lanfuli/Localization/elcano-master/Vision/IMG_0450.JPG

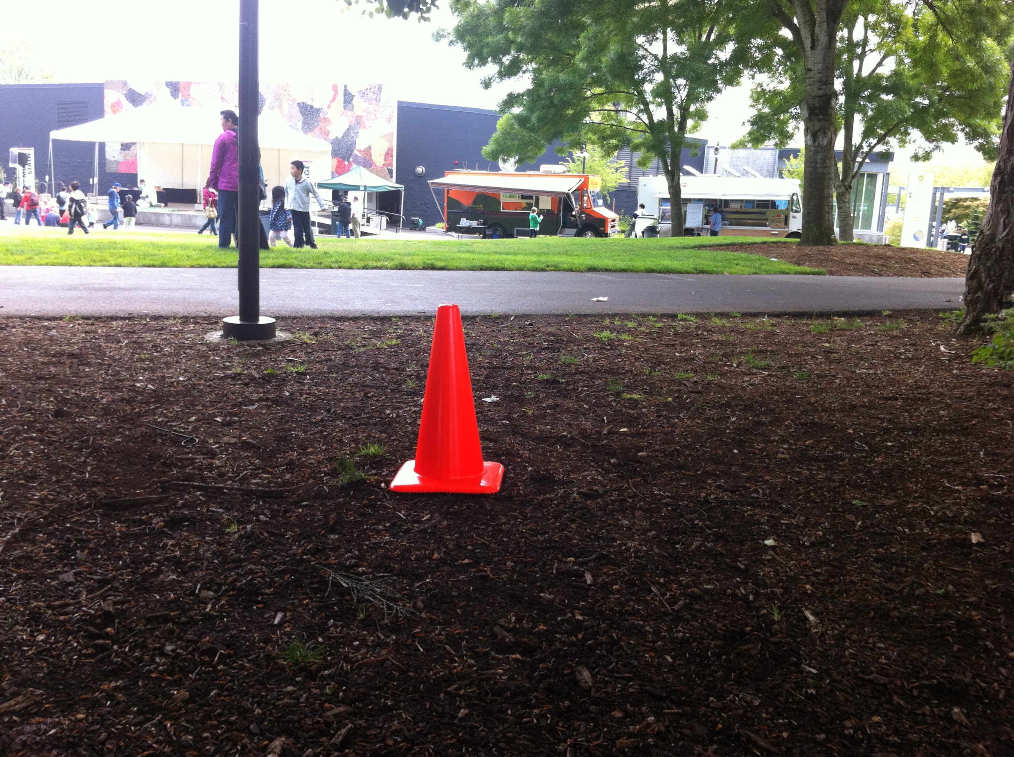
elcano-master/Vision/IMG_0450.JPG
