lanfuli/Localization/elcano-master/Vision/IMG_0453.JPG

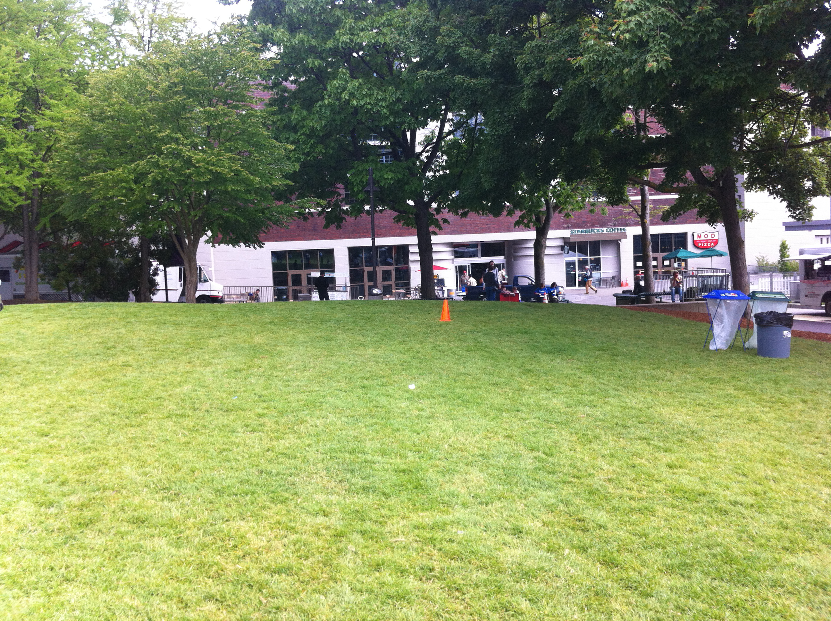
elcano-master/Vision/IMG_0453.JPG
