lanfuli/Localization/elcano-master/RNDF/Sample_RNDF.png

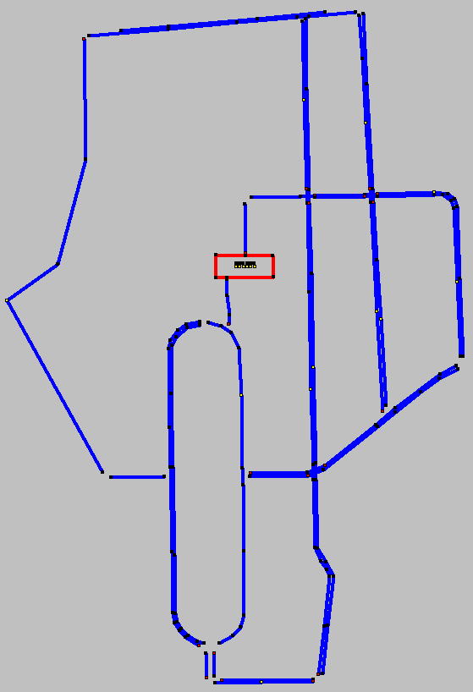
elcano-master/RNDF/Sample_RNDF.png
