lanfuli/Localization/elcano-master/Vision/backgrounds/IMG_0440.png

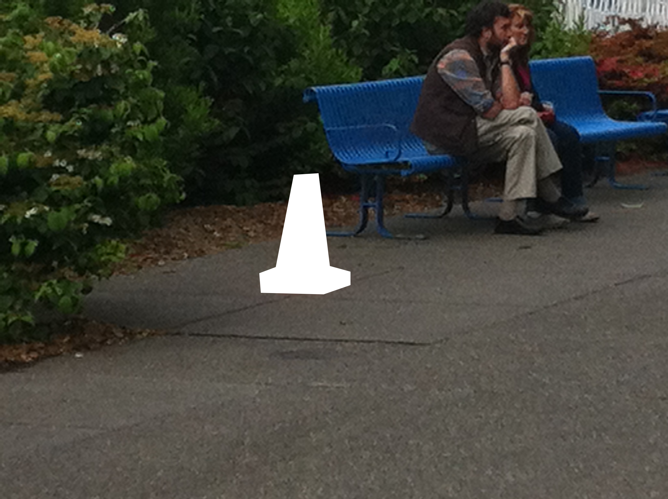
elcano-master/Vision/backgrounds/IMG_0440.png
