lanfuli/Localization/elcano-master/Vision/cones/orange_cones_cropped.png

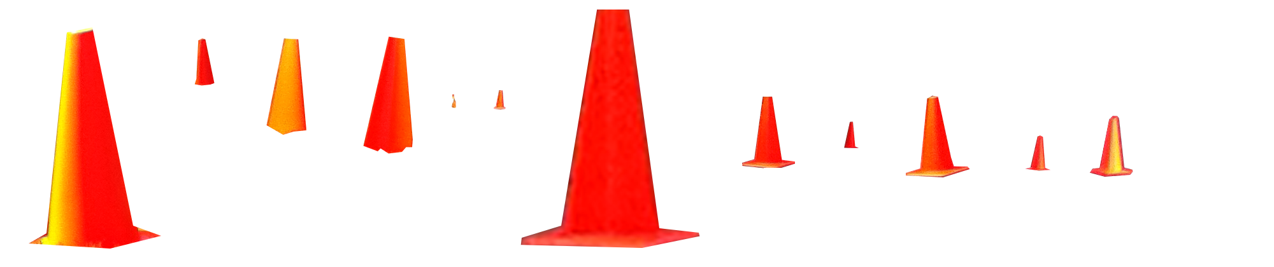
elcano-master/Vision/cones/orange_cones_cropped.png
