lanfuli/Localization/elcano-master/Vision/IMG_0434.JPG

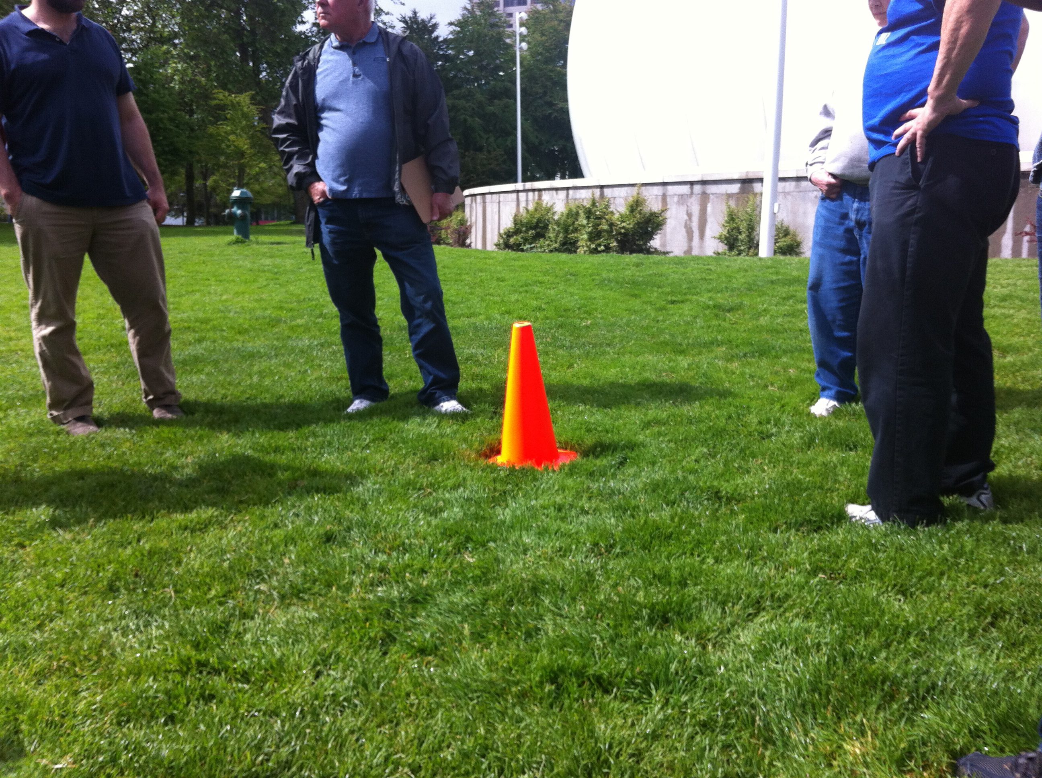
elcano-master/Vision/IMG_0434.JPG
