lanfuli/Localization/elcano-master/Vision/IMG_0435.JPG

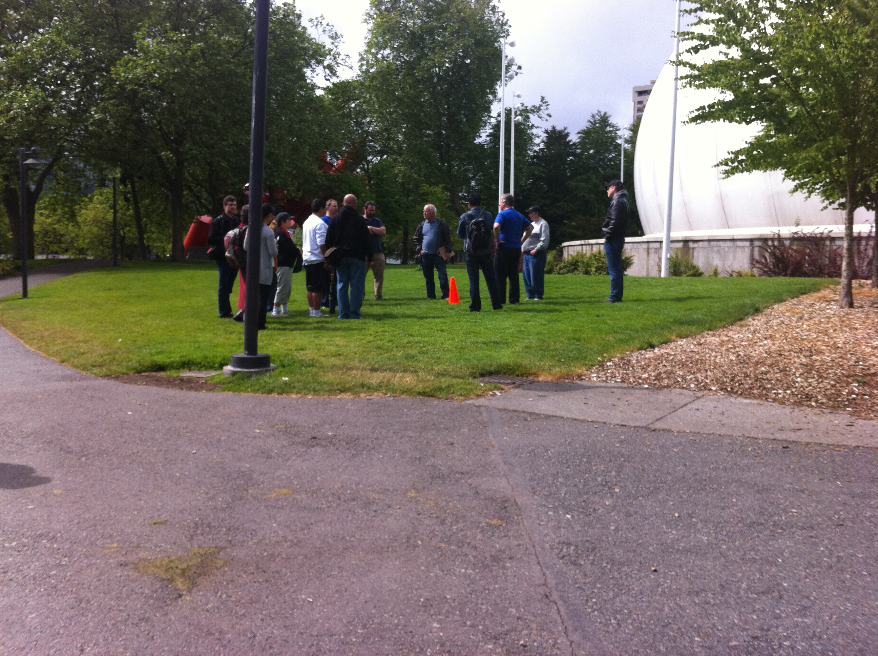
elcano-master/Vision/IMG_0435.JPG
