lanfuli/Localization/elcano-master/Vision/IMG_0436.JPG

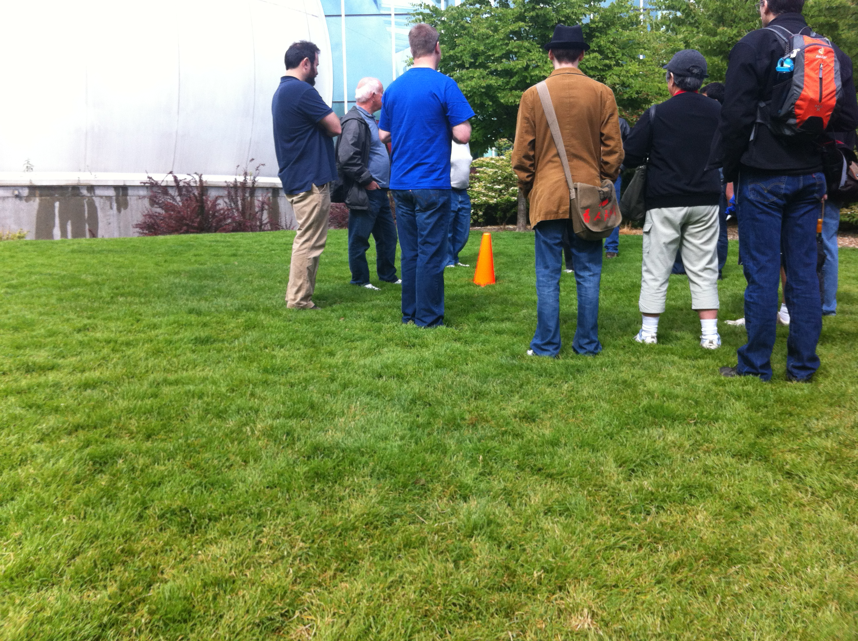
elcano-master/Vision/IMG_0436.JPG
