lanfuli/Localization/elcano-master/Vision/IMG_0437.JPG

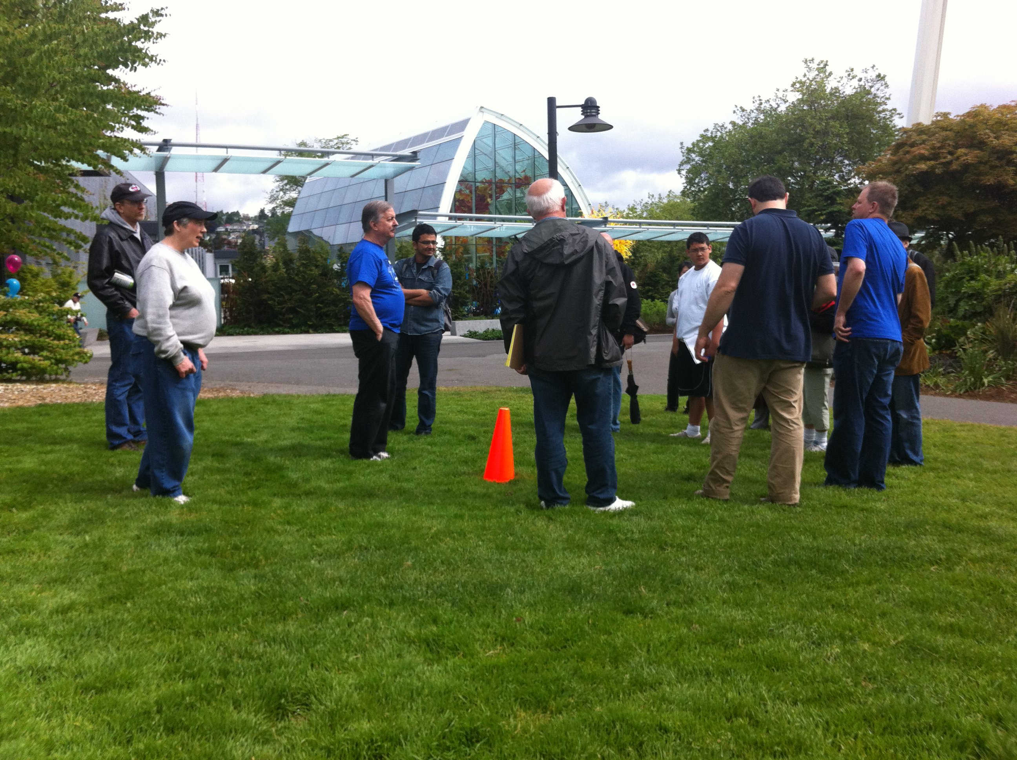
elcano-master/Vision/IMG_0437.JPG
