lanfuli/Localization/elcano-master/Vision/IMG_0438.JPG

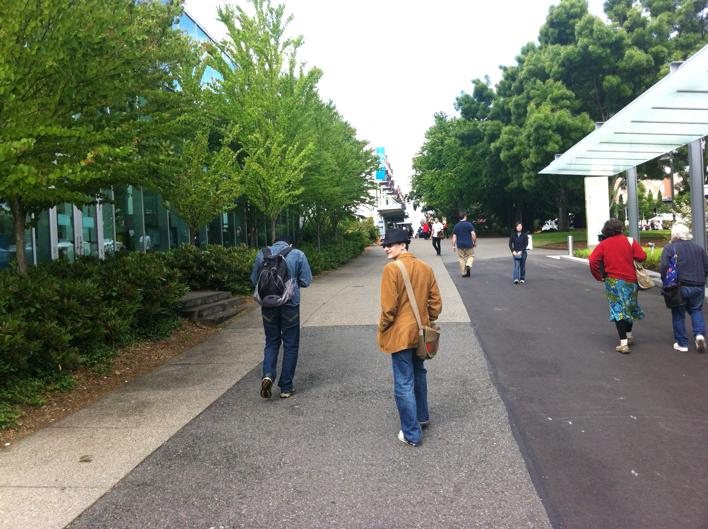
elcano-master/Vision/IMG_0438.JPG
