lanfuli/Localization/elcano-master/Vision/IMG_0439.JPG

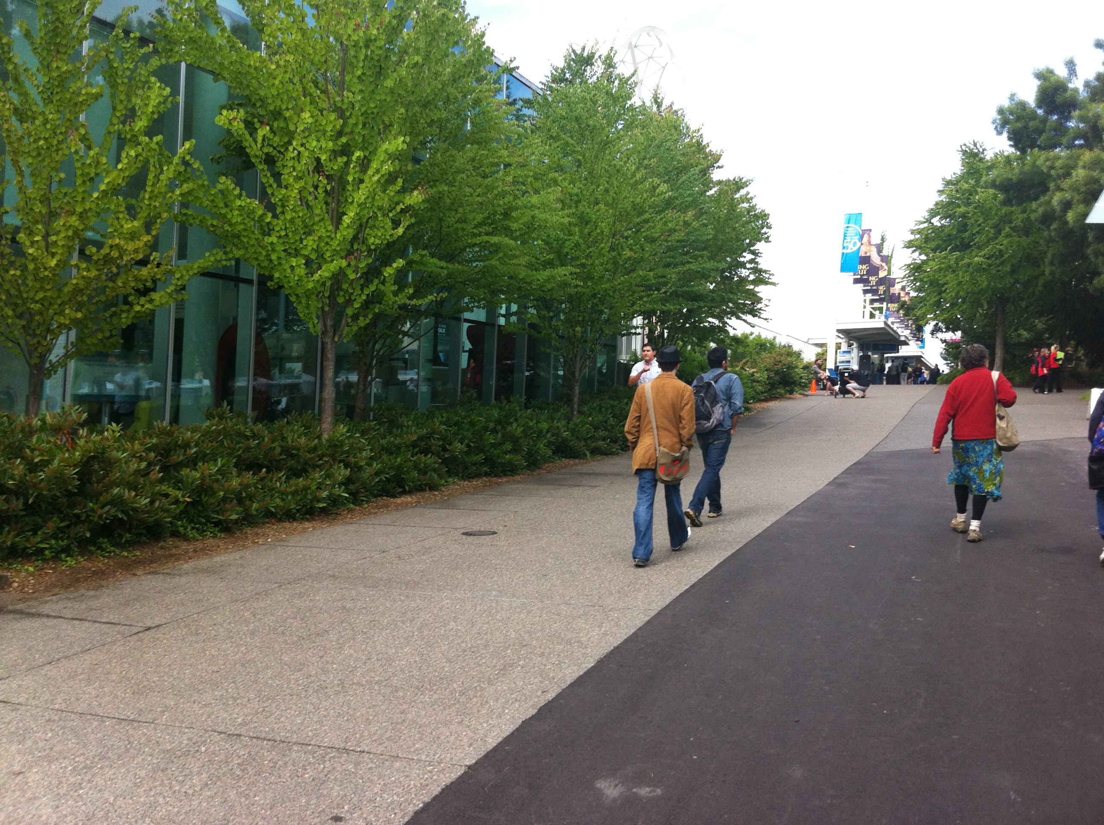
elcano-master/Vision/IMG_0439.JPG
