lanfuli/Localization/elcano-master/Vision/IMG_0441.JPG

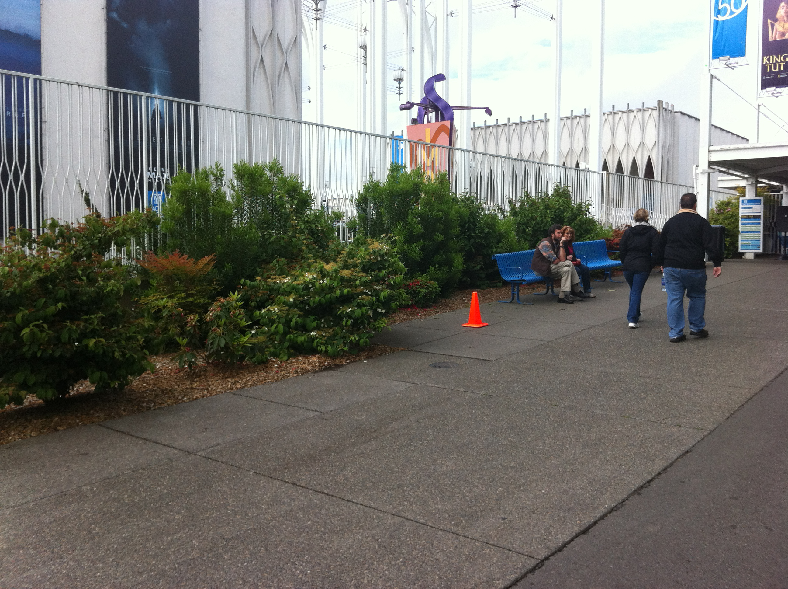
elcano-master/Vision/IMG_0441.JPG
