lanfuli/Localization/elcano-master/Vision/IMG_0442.JPG

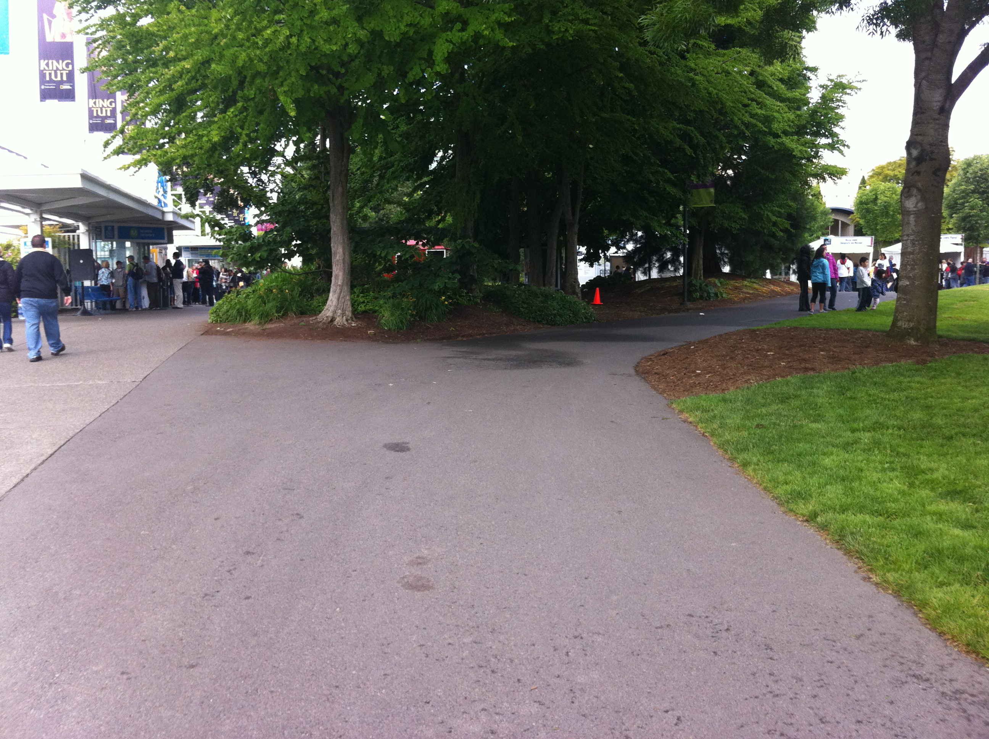
elcano-master/Vision/IMG_0442.JPG
