lanfuli/Localization/elcano-master/Vision/IMG_0443.JPG

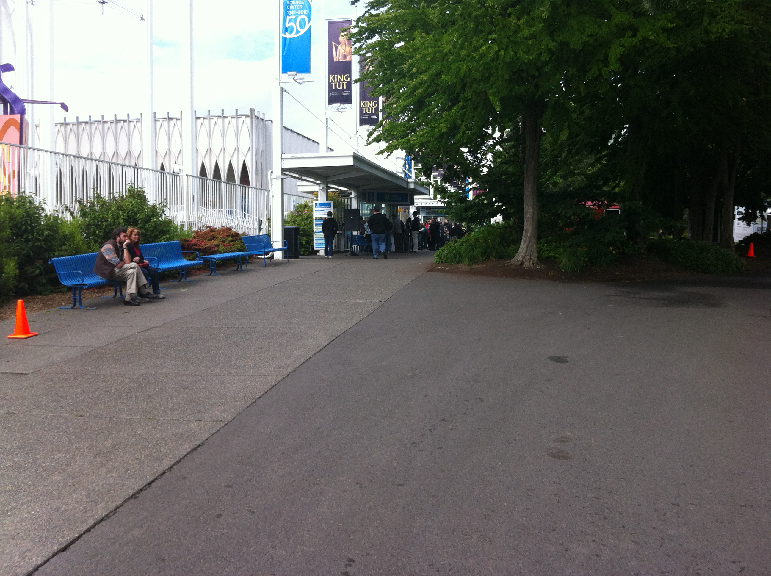
elcano-master/Vision/IMG_0443.JPG
