lanfuli/Localization/elcano-master/Vision/IMG_0444.JPG

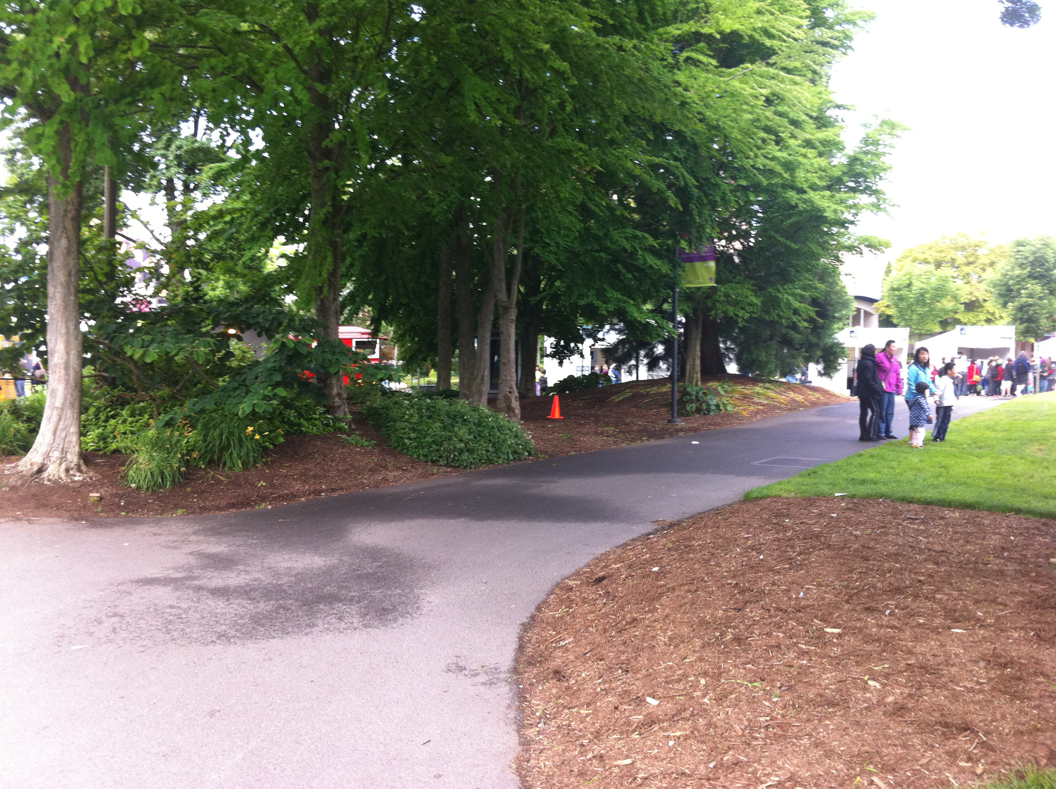
elcano-master/Vision/IMG_0444.JPG
