lanfuli/Localization/elcano-master/Vision/IMG_0445.JPG

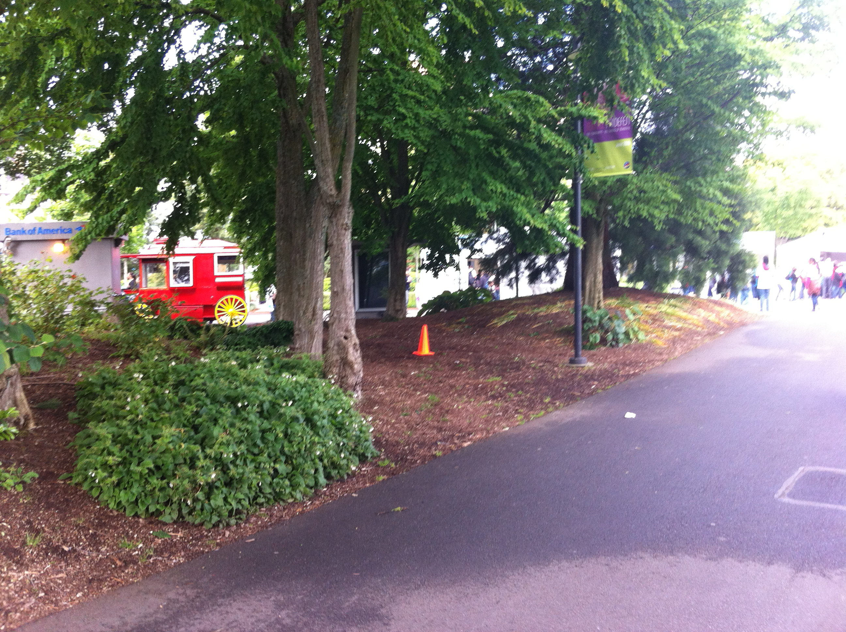
elcano-master/Vision/IMG_0445.JPG
