lanfuli/Localization/elcano-master/Vision/IMG_0446.JPG

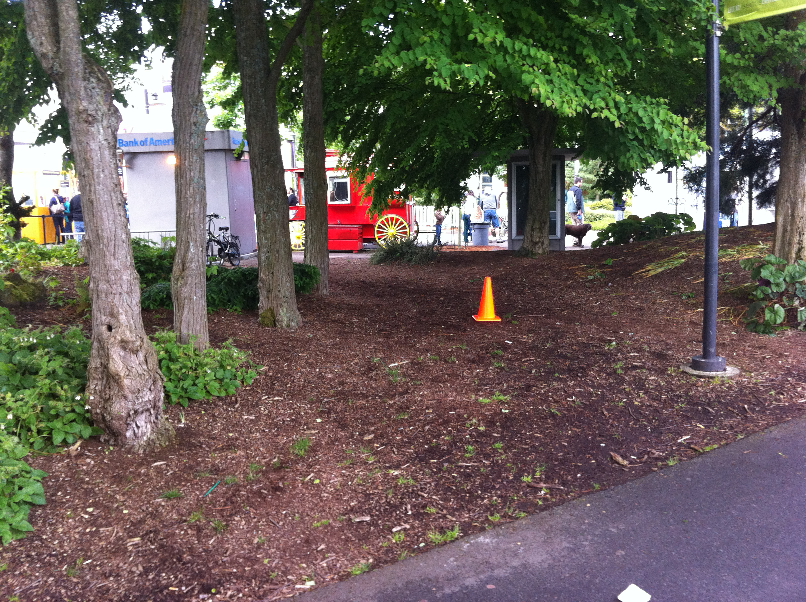
elcano-master/Vision/IMG_0446.JPG
