lanfuli/Localization/elcano-master/Vision/IMG_0447.JPG

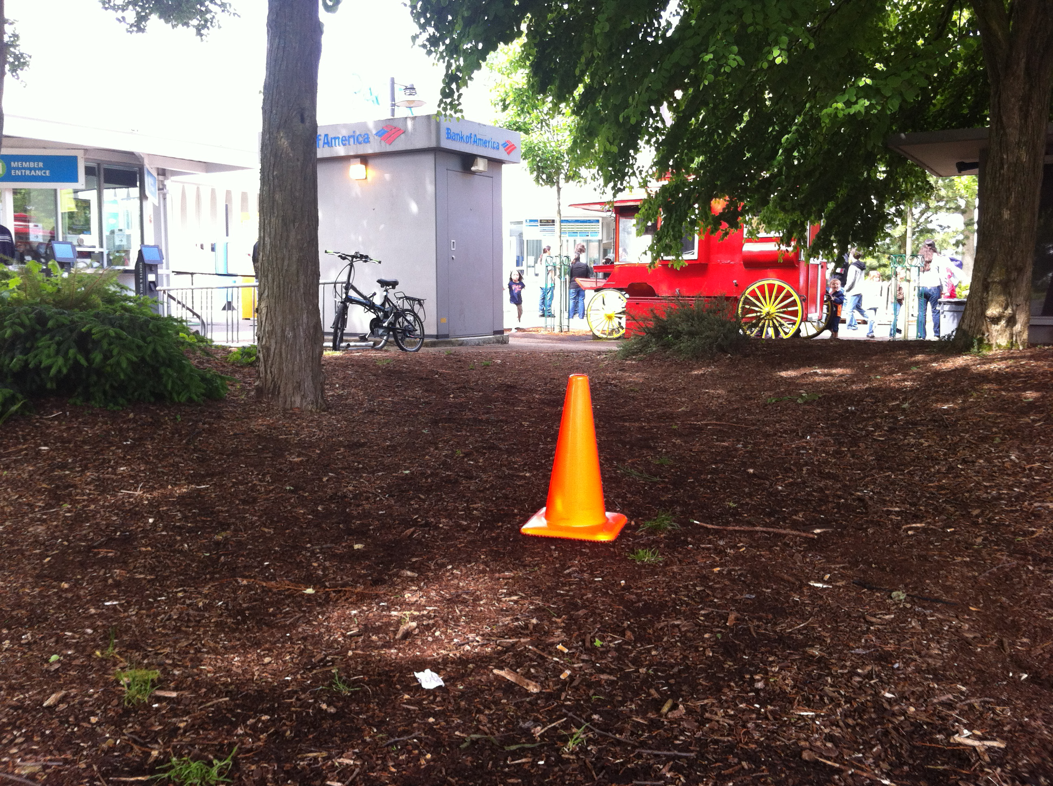
elcano-master/Vision/IMG_0447.JPG
