lanfuli/Localization/elcano-master/Vision/IMG_0448.JPG

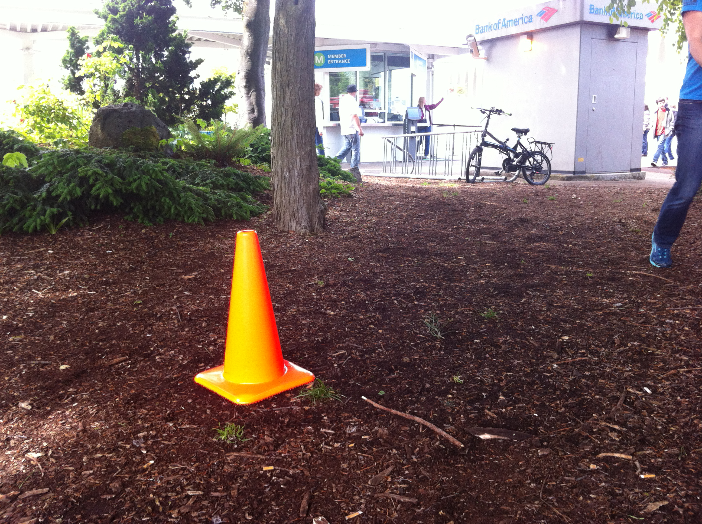
elcano-master/Vision/IMG_0448.JPG
