lanfuli/Localization/elcano-master/Vision/IMG_0449.JPG

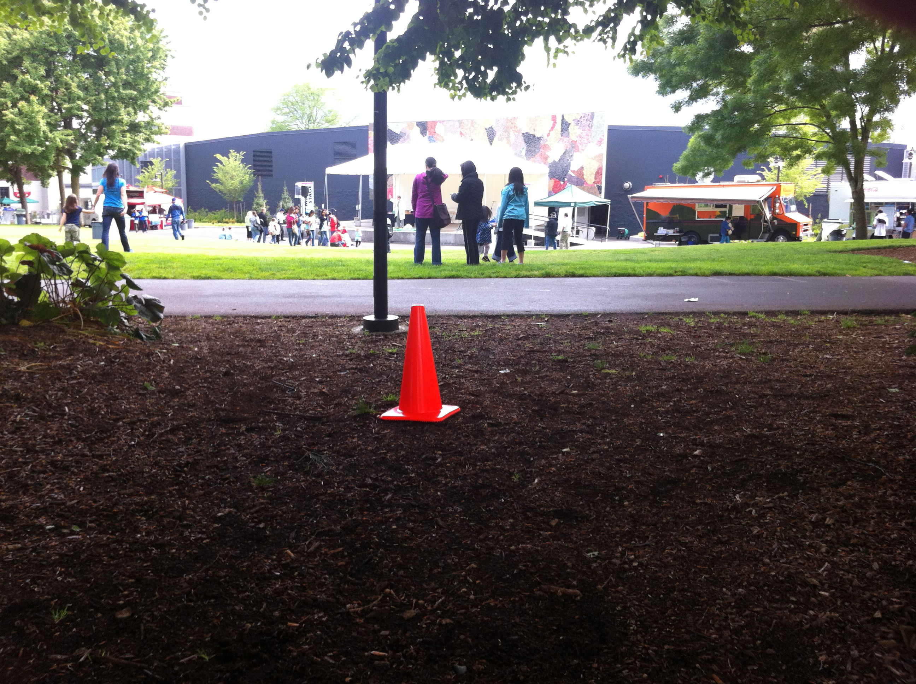
elcano-master/Vision/IMG_0449.JPG
