lanfuli/Localization/elcano-master/Vision/IMG_0451.JPG

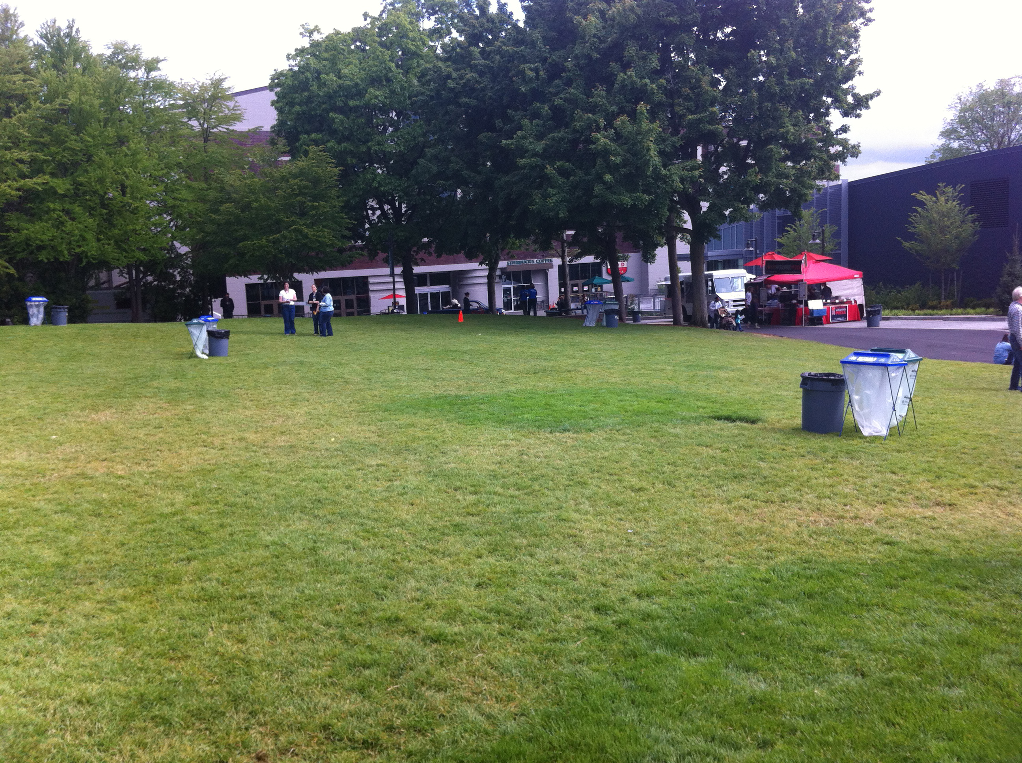
elcano-master/Vision/IMG_0451.JPG
