lanfuli/Localization/elcano-master/Vision/IMG_0452.JPG

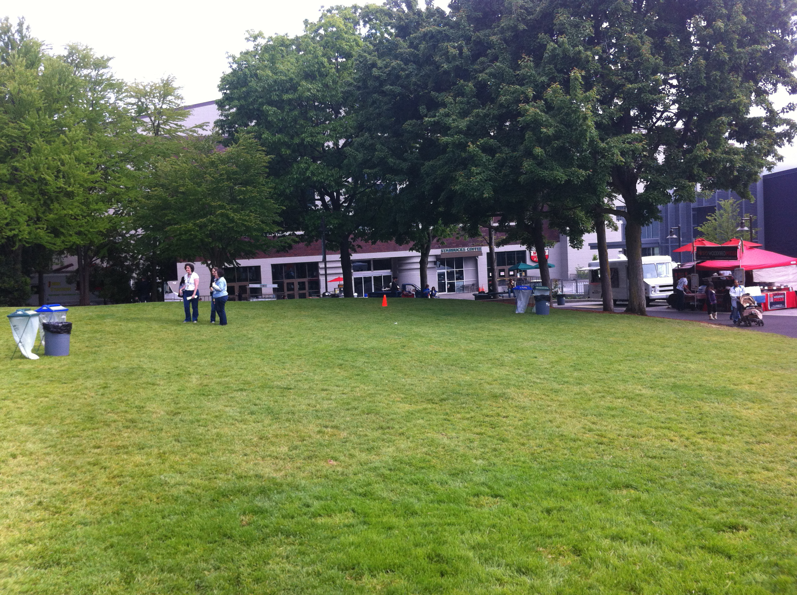
elcano-master/Vision/IMG_0452.JPG
