lanfuli/Localization/elcano-master/Vision/IMG_0454.JPG

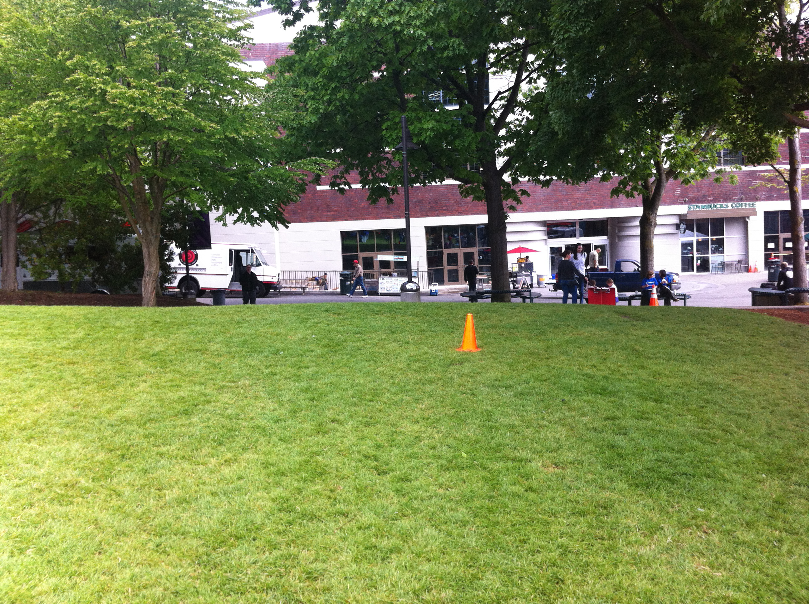
elcano-master/Vision/IMG_0454.JPG
