lanfuli/Localization/elcano-master/Vision/IMG_0455.JPG

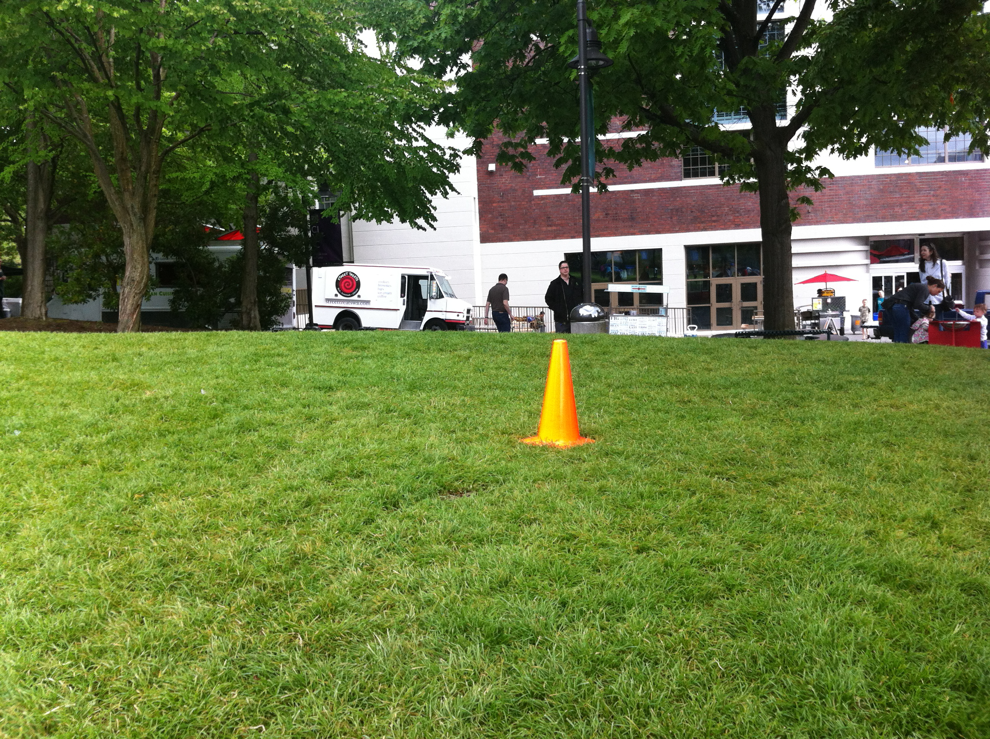
elcano-master/Vision/IMG_0455.JPG
