lanfuli/Localization/elcano-master/Vision/IMG_0456.JPG

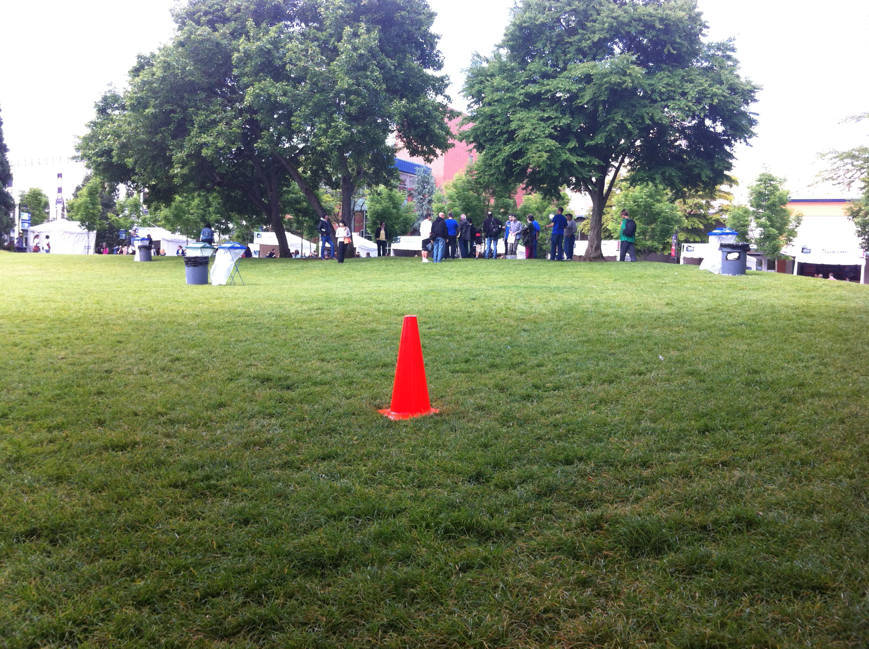
elcano-master/Vision/IMG_0456.JPG
