lanfuli/Localization/elcano-master/Vision/IMG_0457.JPG

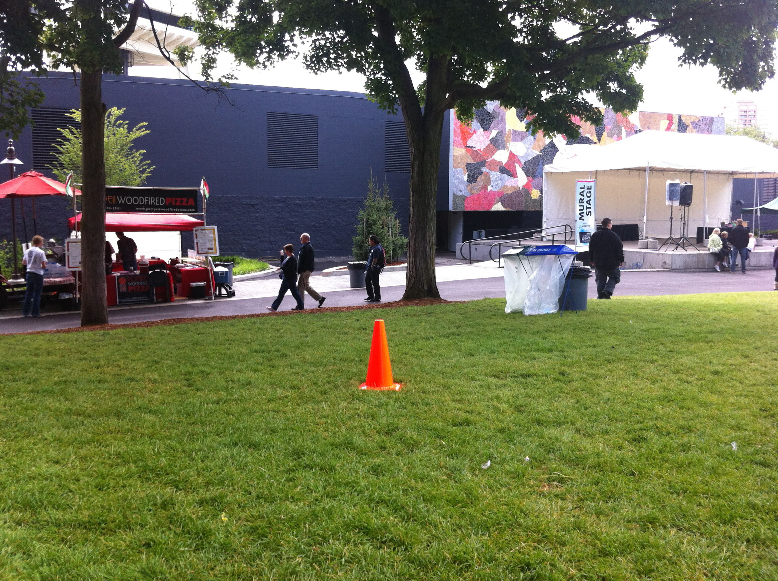
elcano-master/Vision/IMG_0457.JPG
