lanfuli/Localization/elcano-master/Vision/IMG_0465.JPG

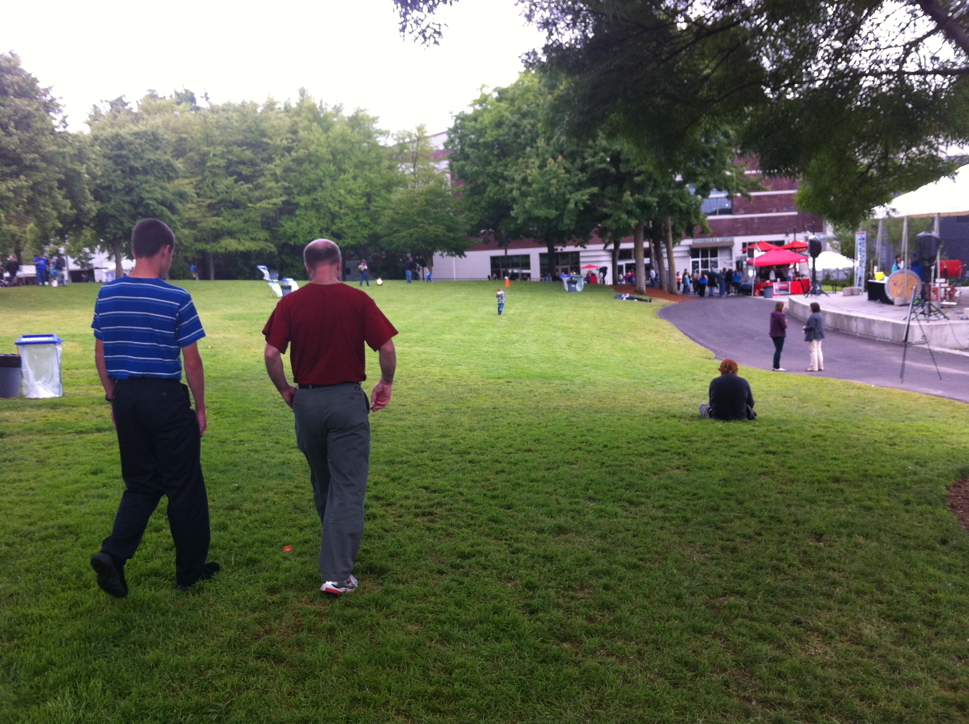
elcano-master/Vision/IMG_0465.JPG
