lanfuli/Localization/elcano-master/Vision/IMG_0466.JPG

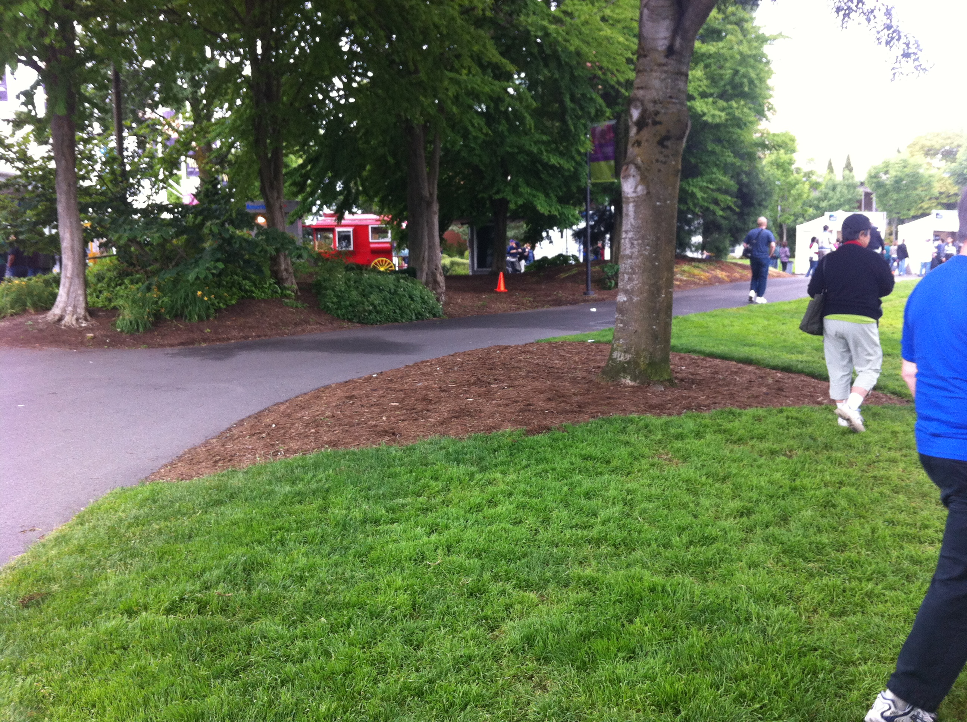
elcano-master/Vision/IMG_0466.JPG
