lanfuli/Localization/elcano-master/Vision/IMG_0467.JPG

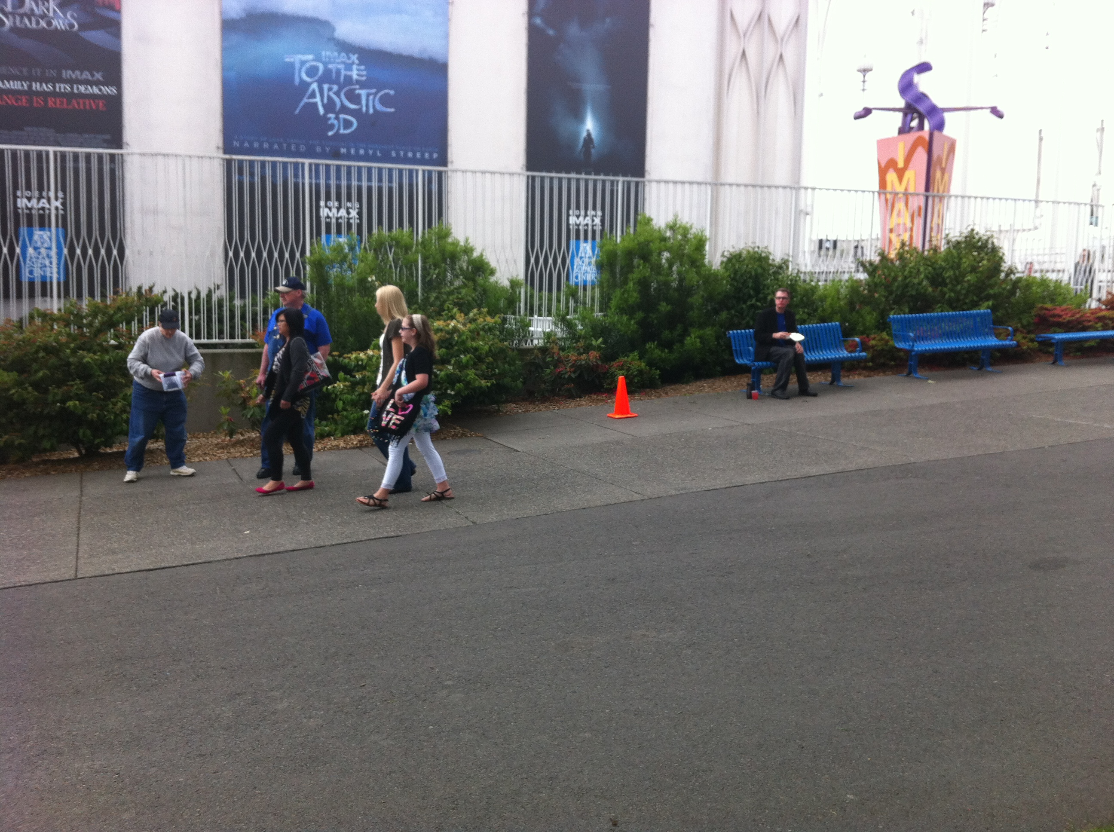
elcano-master/Vision/IMG_0467.JPG
