lanfuli/Localization/elcano-master/Vision/IMG_0468.JPG

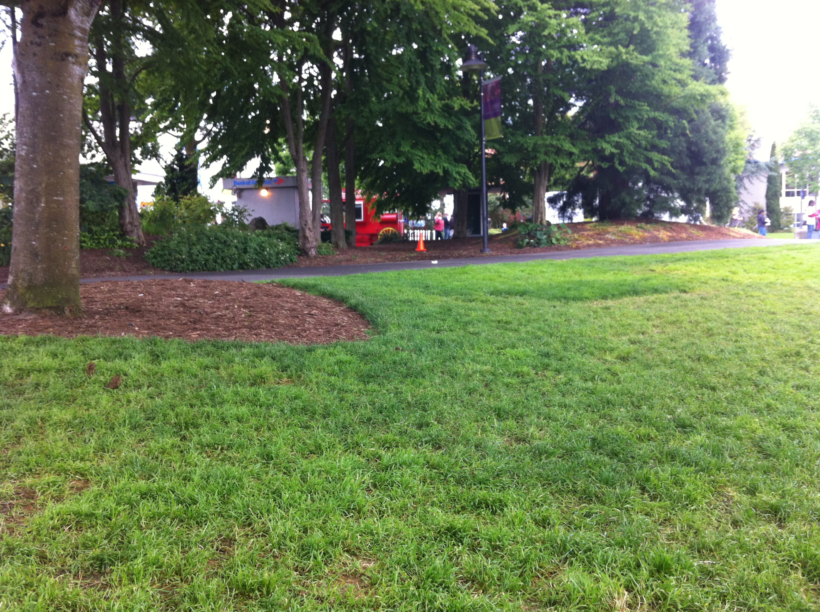
elcano-master/Vision/IMG_0468.JPG
