lanfuli/Localization/elcano-master/Vision/IMG_0469.JPG

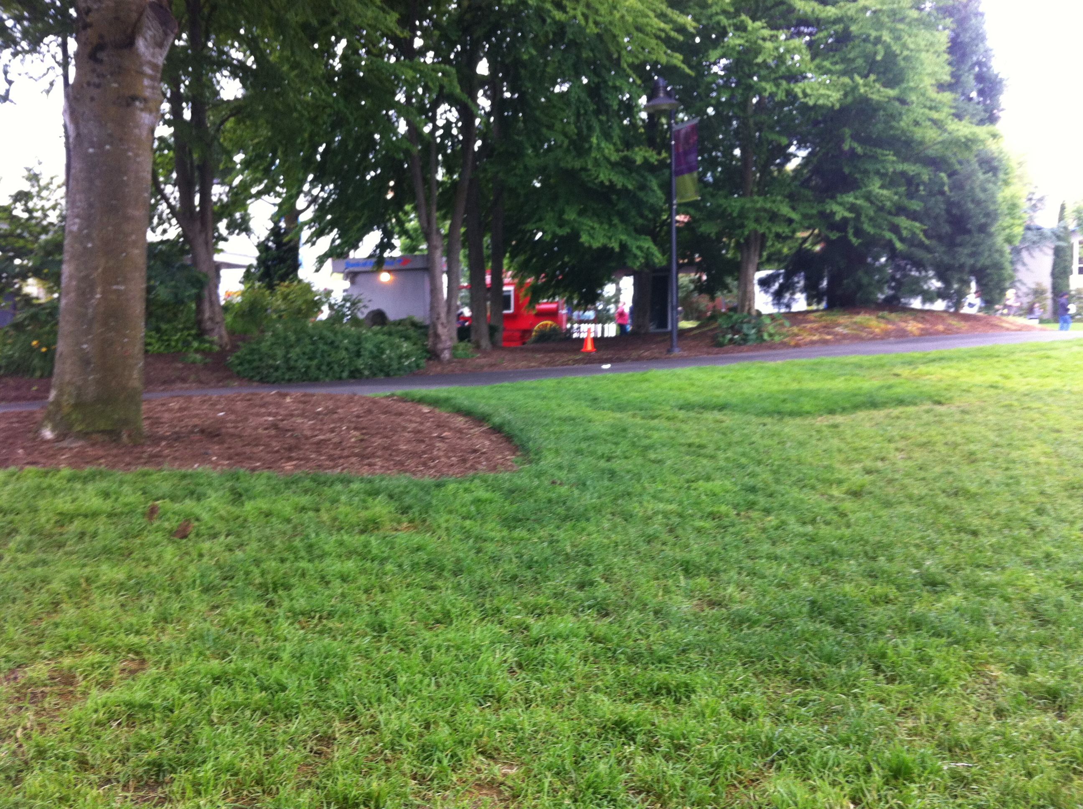
elcano-master/Vision/IMG_0469.JPG
