lanfuli/Localization/elcano-master/Vision/IMG_0470.JPG

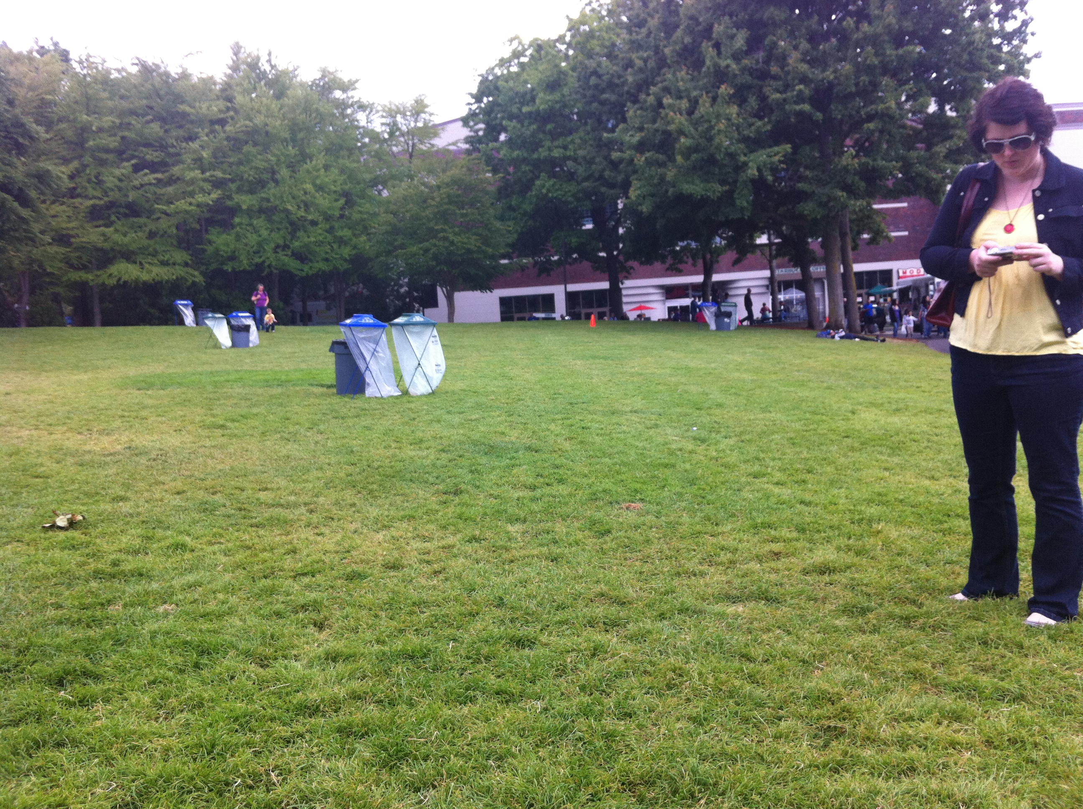
elcano-master/Vision/IMG_0470.JPG
