lanfuli/Localization/elcano-master/Vision/IMG_0471.JPG

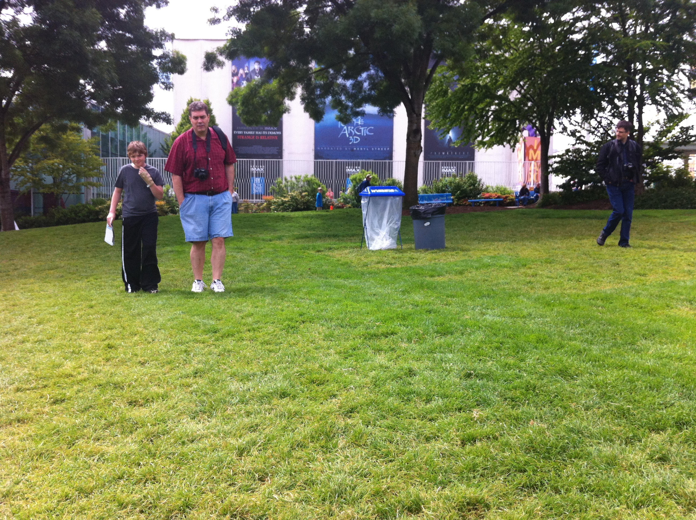
elcano-master/Vision/IMG_0471.JPG
