lanfuli/Localization/elcano-master/Vision/IMG_0472.JPG

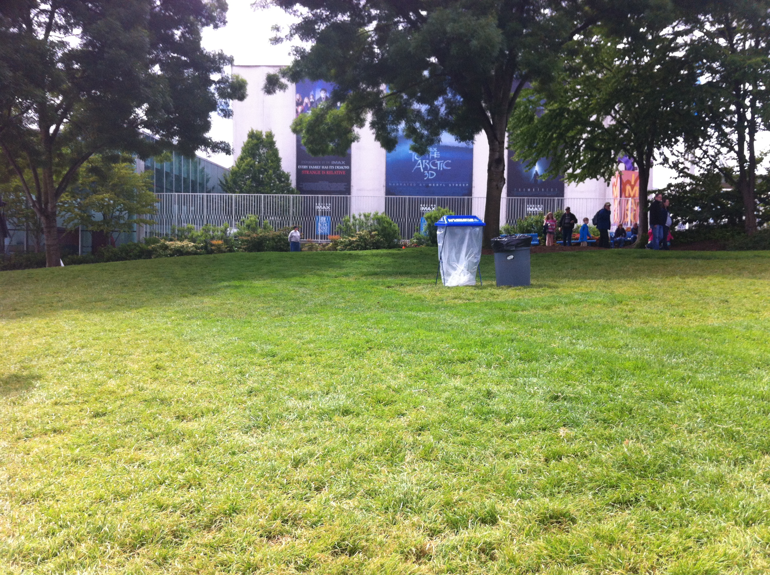
elcano-master/Vision/IMG_0472.JPG
