lanfuli/Localization/elcano-master/Vision/IMG_0473.JPG

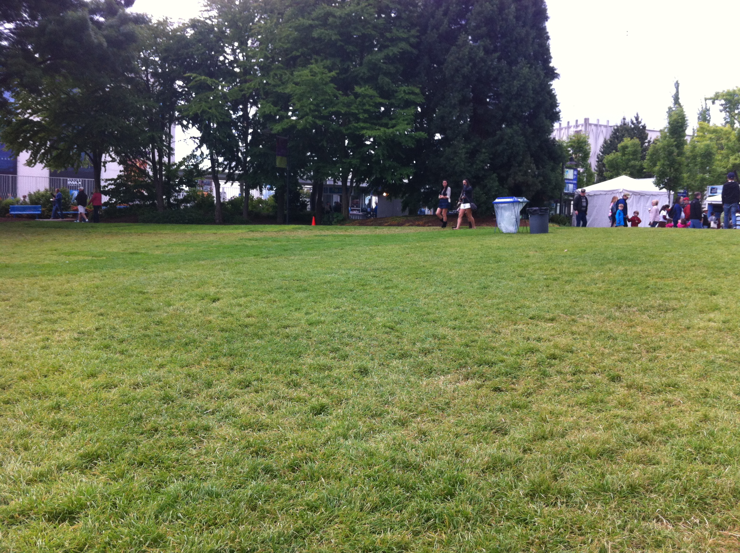
elcano-master/Vision/IMG_0473.JPG
