lanfuli/Localization/elcano-master/Vision/IMG_0474.JPG

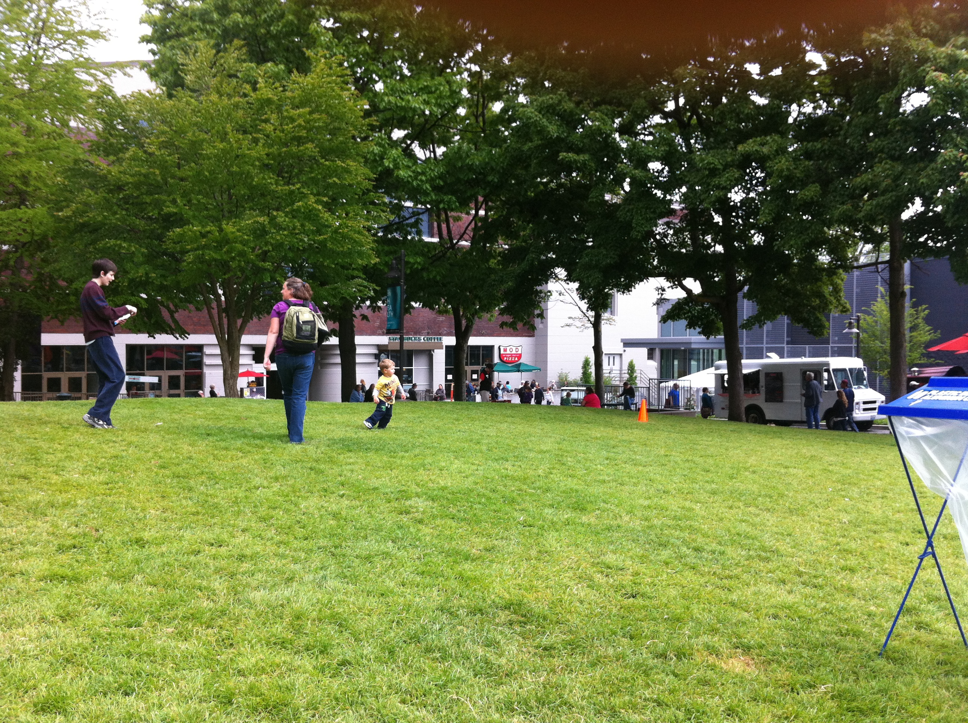
elcano-master/Vision/IMG_0474.JPG
