lanfuli/Localization/elcano-master/Documentation/Elcano_BOM.xls

Sheet: Sheet1
Elcano Bill of Materials
Description | Price (US $) | Weight (lb) | Source | Comment
Mechanical subtotal | 2579 | 31.4
Aluminum rack | 15 | 0.5 | Hardware store | Build rack from 1/16”x1/2”x6' Aluminum angle.
Navigation subsystem | 563
3 project boxes | 30 | 3 | Fryes; Twin Industries part# b30-7100 | 6.3”x3.7”x2.4” with proto boards.
Colored Anderson housings and powerpole contacts | 40 |  | Powerwerx.com | These give a secure connection. Buy an Anderson crimping tool. Price is for about 200 connectors.
MegaShieldDB | 105 |  |  | Four remote operated relays. Used for stop / go and emergency stop.
Arduino Mega for C2 | 24 |  | http://lightake.com | Dual control unit selects from driver joystick or C1 cruise control.
One ACS758LCB-050U current sensors | 7 |  | Newark Electronics | Sense the power draw to the three actuators
APEM 9000 Joystick | 110 |  | DigiKey | Driver has no mechanical control of the vehicle. Joystick is not needed for Robomagellan.
joystick enclosure, connector, relay etc. | 25
Parts for brake & steer servo control | 30
Parts for front panel | 60
Cable DB25 M-M | 7 |  | DigiKey
Cable DB25 F-F | 7 |  | DigiKey
Cable DB15 F-F | 7 |  | DigiKey
Data logging shield for C2 | 20 |  | http://www.adafruit.com/category/17 | You can record everything on an SD card, then analyze it in a spreadsheet on your laptop.
Arduino Nano for C3 | 11.5 |  | Various sources | Pilot
Arduino Nano for C4 | 11.5 |  | Various sources | Path planner
SD shield for C4 | 20
Raspberry Pi for C7 | 40
Web Camera | 20
Cruise shield | 55
TOTAL: | 3732 | 34.9
This come to about $3700 in materials, plus a whole lot of work. On completion, you will have a 50 lb dual mode vehicle capable of carrying a person.

Sheet: Navigation
Costs for building an Elcano vehicle |  | Updated 4/15/13
Navigation Subsystem
Description | Price (US $) | Weight (lb) | Source | Comment
Arduino Mega for C6 | 24 |  | http://lightake.com | Navigation unit uses GPS, odometer, compass, INU and digital map.
Arduino GPS data logging shield for C6 | 20 |  | http://www.adafruit.com/category/17 | SD card to analyze localization from sensor fusion.
EM-406A GPS module | 60 |  | http://www.adafruit.com/category/17
Cylometer | 25 |  | Bike store | Cut into wires from the Hall Effect odometry pick- ups and route them to the C6 computer.
UM-6 LT Orientation sensor | 149 |  | Polulu # 1256
Optical mouse odometer | 35 |  | Had been available from DIYdrones | An optical mouse sensor with the right lens
Front left: XL-MaxSonar 1200 | 50 |  | Pololu #1652 | Obstacle detection on C6
Front: XL-MaxSonar 1220 | 50 |  | Pololu #1650
Front right: XL-MaxSonar 1200 | 50 |  | www.Pololu.com #1650
right: XL-MaxSonar 1200 | 50
Left: XL-MaxSonar 1200 | 50
Total | 563

Sheet: Mechanical
Mechanical Subsystem
Description | Price (US $) | Weight (lb) | Source | Comment
 |  |  |  | There are many ways to build the system on a less expensive vehicle.
 |  |  | http://www.pjrc.com/teensy/ | An RC car would be a good choice, in which case Teensy Arduinos are appropriate.
Catrike Dash | 1350 | 17 | http://www.catrike.com/catrike_dash.html | Design works with any vehicle big enough to carry electronics, sensors and actuators.
Kelly E-bike controller | 169 | 4.5 | http://kellycontroller.com/keb48201x24v-48v150a20kw-bike-brushless-controller-regen-p-59.html | KEB48201X,24V-48V,150A,2.0KW, E-bike Brushless Controller /Regen
Controller waterproof option | 38 | 0 | same
20” rear wheel with hub motor | 295 |  | http://www.goldenmotor.com | May be heavy
2” stroke linear servo | 130 | 2.4 | http://servocity.com/html/12v_linear_actuators.html | Brake servo and controller: 25 lb thrust. Writing a PWM signal applies brakes. Present version from Servo City does not include a controller, but price is $130.
4” stroke linear servo | 130 | 2.5 | same | Steering servo and controller: 25 lb thrust. Writing a PWM signal turns wheels.
Two actuator mounting brackets | 22 |  | same
Brake lever pulling two cables | 15 |  | Bike shop | Connect disk brakes on front wheels to the lever.
Custom brake mount hardware | 15 |  | Need to machine parts. | Make parts to mount brake servo. A slotted PVC tube pushed by the servo applies the brake. Make sure rider can manually operate brake lever in an emergency.
Custom steering mount hardware. | 15 |  | Need to machine parts. | Steering servo is attached to steering tie bar. Vehicle is Ackerman steered.
Subtotal | 2179 | 26.4
Lead acid battery: 3 cells of 12 V and 6.5 Amp Hours each | 110 | 15.4 |  | Put batteries in series for 36V power to hub motor. The lower 12 V (or a separate battery) is used to power the servos and electronics.
Lithium battery | 400 | 5 | BatterySpace.com
Lead acid total: | 2289 | 41.8
Lithium Total: | 2579 | 31.4
