lanfuli/Localization/elcano-master/Documentation/MegaShieldDB_BOM.xls

DB board | Bill of Materials |  | 9/11/13
Part | Where | Quantity | Appox price | Extended | Manufacturer | M Part # | Source | Supplier part # | Link
MegaShieldDB PCB |  | 1 | 40.00 | 40.00 | ElcanoProject | DB-PCBv1
1x8 Stack Header | D0-13,A0-7 | 3 |  | 1.76 |  |  | Pololu | 1035 | http://www.pololu.com/catalog/product/1035
1x6 Stack Header | Power | 1 |  |  |  |  | Pololu | 1035
1x8 M Hdr .23 | D14-21,A8-15 | 2 | 0.22 | 0.44 | FCI | 68000-408HLF | DigiKey | 609-3264-ND | http://www.digikey.com/product-search/en?WT.z_header=search_go&lang=en&site=us&x=11&y=14&formaction=on
PINHD-2X9M .228 | D22-53 | 2 | 0.60 | 1.20 | Harwin | M20-9760942 | DigiKey | 952-1825-ND | http://www.digikey.com/product-search/en?WT.z_header=search_go&lang=en&site=us&x=11&y=12&formaction=on
Resistor 1 M | R1 | 1 | 0.03 | 0.03 | Stackpole Electronics | CF14JT1M00 | DigiKey | CF14JT1M00CT-ND | http://www.digikey.com/product-detail/en/CF14JT1M00/CF14JT1M00CT-ND/1830423
M25 SubD connector | X1 | 1 | 1.18 | 1.18 | FCI | 10090097-P254VLF | DigiKey | 609-4006-ND | http://www.digikey.com/product-search/en?WT.z_header=search_go&lang=en&site=us&x=11&y=16&formaction=on
DB-25 female | X2 | 1 | 1.18 | 1.18 | FCI | 10090099-S254VLF | DigiKey | 609-4012-ND | http://www.digikey.com/product-search/en?WT.z_header=search_go&lang=en&site=us&x=15&y=16&formaction=on
DB-15 -male | X3 | 1 | 1.08 | 1.08 | Sullins Connector | SDS107-PRW1-M15-SN23-11 | DigiKey | S9569-ND | http://www.digikey.com/product-search/en?WT.z_header=search_go&lang=en&site=us&x=18&y=17&formaction=on
DB-9-F | X4 | 1 | 0.64 | 0.64 | TE Connectivity | 1734348-1 | DigiKey | A35109-ND | http://www.digikey.com/product-search/en?WT.z_header=search_go&lang=en&site=us&x=12&y=12&formaction=on
DB-9-M | X5 | 1 | 0.83 | 0.83 | FCI | 10090097-P094VLF | DigiKey | 609-4003-ND | http://www.digikey.com/product-search/en?WT.z_header=search_go&lang=en&site=us&x=12&y=16&formaction=on
SHUNT | JP9:3-5,2-4 | 2 | 0.10 | 0.20 | TE Connectivity | 382811-8 | DigiKey | A26228-ND | http://www.digikey.com/product-search/en?WT.z_header=search_go&lang=en&site=us&x=16&y=15&formaction=on
PINHD-2X3M | ICSP,JP9 | 2 | 0.22 | 0.44 | Sullins Connector | PREC003DAAN-RC | DigiKey | S2012EC-03-ND | http://www.digikey.com/product-detail/en/PREC003DAAN-RC/S2012EC-03-ND/2774891
DAC MCP 4802 | IC2,IC3 | 2 | 1.48 | 2.96 | Microchip Tech | MCP4802-E/P | DigiKey | MCP4802-E/P-ND | http://www.digikey.com/product-search/en?WT.z_header=search_go&lang=en&site=us&x=11&y=13&formaction=on
0.1 uF Capacitor | C1,C2 | 2 | 0.10 | 0.20 | Kemet | C420C104K5R5TA7200 | DigiKey | 399-4491-1-ND | http://www.digikey.com/product-detail/en/C420C104K5R5TA7200/399-4491-1-ND/818348
Parts TOTAL |  |  |  | 46.87
Price |  |  |  | 90.00
Not used
PINHD-1X8M .32 | too long | 2 | 0.80 |  | Samtec | TSW-108-14-L-S | DigiKey | SAM1055-08-ND | http://www.digikey.com/product-search/en?WT.z_header=search_go&lang=en&site=us&x=15&y=15&formaction=on
push button (reset) | PCB error | 2 | 0.44 | 0.88 | CW Industries | GPBS-800N | DigiKey | CW178-ND | http://www.digikey.com/product-search/en?WT.z_header=search_go&lang=en&site=us&x=14&y=13&formaction=on
Socket-2X3F ICSP1 | Not needed | 1 | 0.88 |  | TE Connectivity | 215307-3 | DigiKey | A106656-ND | http://www.digikey.com/product-search/en?WT.z_header=search_go&lang=en&site=us&x=10&y=17&formaction=on
Enhanced version
Wire, 200mm | ANT1 | 1
Transistor, NPN C8050 | Q1,Q2 | 2 |  |  |  |  | DigiKey | 497-2586-5-ND
Flip-flop | IC1 | 1 |  |  |  |  | DigiKey | 497-1346-5-ND
4-Channel UHF Receiver | JP5, JP6 | 1 |  |  |  | H01749-01U | Hobby Engineering
Diode | D1 | 1 |  |  |  |  | DigiKey | 641-1311-1-ND
Res, 10 M | R2,R5,R6,R8 | 4 |  |  |  |  | DigiKey | CF14JT10M00CT-ND
Res, 1.5K | R3,R7 | 2 |  |  |  |  | DigiKey
Res, 1M | R4 | 1 |  |  |  |  | DigiKey | CF14JT1M00CT-ND
0.1 uF Capacitor | C3,C4,C5 | 3 |  |  |  |  | DigiKey | 399-4491-1-ND
Purchased separately
Arduino Mega 2560 |  | 1 | 55.13 | 55.13 | Arduino |  | Robot Shop | RB-Ard-33
Off-Board
4-Channel UHF Transmitter |  |  |  |  |  | H01747-01Y | Hobby Engineering
DB-25 pin though 2m, male-male cable |  |  |  |  |  |  | DigiKey | AE9867-ND
DB-25 pin though 2m, female-female cable
Relay |  | 1 | 4.02 |  | Panasonic | ALF1P12 | DigiKey | 255-2099-5-ND | http://www.digikey.com/product-search/en?WT.z_header=search_go&lang=en&site=us&x=11&y=17&formaction=on
C1 Circuit board and box for relay.
DB-15 -male for C1 box.
DB-25 female for C6 box.
Wiring from C1 box to joystick/controller.
Current sensor in C1 box.
Connectors in C2 from servo controllers to PCB.
DB-15 cable |  |  |  |  |  |  | DigiKey | H7SSH-1506G-ND
DB-9 cable |  |  |  |  |  |  | DigiKey | AE9880-ND
