lanfuli/Localization/elcano-master/Documentation/MegaShieldTrio_BOM.xls

Trio board |  | Bill of Materials |  | 9/10/13
Part | Where | Quantity | Appox price | Extended | Manufacturer | M Part # | Source | Supplier part # | Link
MegaShieldTrio PCB |  | 1 | 13.00 | 13.00 | ElcanoProject | Trio-PCB
Relay | RL1 | 1 | 2.57 | 2.57 | TE Connectivity | TSC-105D3H,000 | DigiKey | PB1016-ND | http://www.digikey.com/product-search/en?WT.z_header=search_go&lang=en&site=us&x=12&y=12&formaction=on
1X7HEADER | C3,C4 | 4 | 0.62 | 2.48 | FCI | 71920-407LF | Mouser | 649-71920-407LF
1x10 Header | Mouse | 1 | 1.11 | 1.11 | FCI | 75915-310LF | Mouser | 649-75915-310LF
1x9 Header | CHRUM6 | 1 | 0.89 | 0.89 | FCI | 75915-409LF | Mouser | 649-75915-409LF
1X8HEADER | C4SD0-13,C3,C4 | 6 | 0.84 | 5.04 | FCI | 75915-308LF | Mouser | 649-75915-308LF
1X6HEADER | C4SPwr,C4SA | 2 | 0.71 | 1.42 | FCI | 75915-306LF | Mouser | 649-75915-306LF
1x2 Header | CHRUM6 | 2 | 0.30 | 0.60 | FCI | 75915-302LF | Mouser | 649-75915-302LF
1x8 Stack Header | D0-13,A0-7 | 3 |  | 1.76 |  |  | Pololu | 1035 | http://www.pololu.com/catalog/product/1035
1x6 Stack Header | Power | 1 |  |  |  |  | Pololu | 1035
1x8 M pins | D14-21,A8-15 | 2 | 0.22 | 0.44 | FCI | 68000-408HLF | DigiKey | 609-3264-ND | http://www.digikey.com/product-search/en?WT.z_header=search_go&lang=en&site=us&x=11&y=14&formaction=on
2x15 M pins | D28-53 | 1 | 0.53 | 0.53 | Sullins Connector | PREC015DAAN-RC | DigiKey | S2012EC-15-ND | http://www.digikey.com/product-detail/en/PREC015DAAN-RC/S2012EC-15-ND/2774879
1x2 M pins | D23,25 | 1 | 0.10 | 0.10 | Sullins Connector | PREC002SAAN-RC | DigiKey | S1012EC-02-ND | http://www.digikey.com/product-detail/en/PREC002SAAN-RC/S1012EC-02-ND/2774852
1x3 M pins | D22,24,26 | 1 | 0.11 | 0.11 | Sullins Connector | PREC003SAAN-RC | DigiKey | S1012EC-03-ND | http://www.digikey.com/product-detail/en/PREC003SAAN-RC/S1012EC-03-ND/2774851
ODO_JACK | X2,X3 | 2 | 0.53 | 1.06 | CUI Inc | MJ1-2503A | DigiKey | CP1-2503AM-ND | http://www.digikey.com/product-search/en?WT.z_header=search_go&lang=en&site=us&x=18&y=15&formaction=on
RJ45-8L-B | X4,X5 | 2 | 0.48 | 0.96 | FCI | 54602-908LF | DigiKey | 609-1046-ND | http://www.digikey.com/product-search/en?WT.z_header=search_go&lang=en&site=us&x=17&y=17&formaction=on
M25 SubD connector | X1 | 1 | 1.18 | 1.18 | FCI | 10090097-P254VLF | DigiKey | 609-4006-ND | http://www.digikey.com/product-search/en?WT.z_header=search_go&lang=en&site=us&x=11&y=16&formaction=on
Resistor 1 M | R1,R2,R3 | 3 | 0.03 | 0.09 | Stackpole Electronics | CF14JT1M00 | DigiKey | CF14JT1M00CT-ND | http://www.digikey.com/product-detail/en/CF14JT1M00/CF14JT1M00CT-ND/1830423
2x3 M pins | ICSP | 1 | 0.22 | 0.22 | Sullins Connector | PREC003DAAN-RC | DigiKey | S2012EC-03-ND | http://www.digikey.com/product-detail/en/PREC003DAAN-RC/S2012EC-03-ND/2774891
Parts TOTAL |  |  |  | 33.56
Price |  |  |  | 90.00
Purchased separately
Arduino Mega 2560 |  | 1 | 55.13 | 55.13 | Arduino |  | Robot Shop | RB-Ard-33
Arduino Nano |  | 2 | 34.99 | 69.98 |  |  | Robot Shop | RB-Gra-01
GPS Log Shield |  | 1 | 50 | 50.00 |  |  | Adafruit | 1272 | http://www.adafruit.com/products/1272
SD Shield |  | 1 | 20 | 20.00 |  |  | Adafruit | 1141 | http://www.adafruit.com/products/1141
Micro SD Card |  | 1 | 7 | 7.00 | Kingston |  | Amazon |  | http://www.amazon.com/Kingston-microSDHC-Memory-SDC4-8GBET/dp/B00200K1TS
SD Card |  | 1 | 9 | 9.00 | Transcend |  | Amazon |  | http://www.amazon.com/Transcend-Class-Flash-Memory-TS8GSDHC10E/dp/B003VNKNEG
UM-6 LT Orientation sensor |  | 1 | 149 | 149.00 |  |  | Pololu | 1256 | http://www.pololu.com/catalog/product/1256
DB-25 Cable M-F |  | 1 | 6.76 | 6.76 | Assmann WSW | AK135-2-R | DigiKey | AE9865-ND | http://www.digikey.com/product-detail/en/AK135-2-R/AE9865-ND/821620
Ethernet Cable |  | 1 | 2.19 | 2.19 | Assmann WSW Comp | DK-1511-003/B | DigiKey | AE10481-ND | http://www.digikey.com/product-detail/en/DK-1511-003%2FB/AE10481-ND/2268273
Cable |  | 1 | 2.57 | 2.57 | Tensility Inrtnl | CA-2201 | DigiKey | CP-2201-ND | http://www.digikey.com/product-search/en?WT.z_header=search_go&lang=en&site=us&x=11&y=15&formaction=on
9.6V Battery & charger |  | 1 | 24 | 24.00 | Nitro Power |  | BatteryMart | RC-R96K | http://www.batterymart.com/p-rc-r96k-nitropower-battery-and-charger.html?device=c&network=g&matchtype=
Battery Connector |  | 1 |  | 0.00
Optical mouse odometer |  | 1 | 35 | 35.00
TOTAL |  |  |  | 430.63
Grand total |  |  |  | 520.63
