lanfuli/Localization/elcano-master/Documentation/Sonars_BOM.xls

Sonars board | Bill of Materials |  | 9/10/13
Part | Quantity | Appox price | Extended | Manufacturer | M Part # | Source | Supplier part # | Link
Sonars PCB | 1 | 6.00 | 6.00 | ElcanoProject | Sonar-PCB
RJ45-8L-B | 1 | 0.48 | 0.48 | FCI | 54602-908LF | DigiKey | 609-1046-ND | http://www.digikey.com/product-search/en?WT.z_header=search_go&lang=en&site=us&x=17&y=17&formaction=on
1x7 Socket | 5 | 0.62 | 3.10 | FCI | 71920-407LF | Mouser | 649-71920-407LF
7x1 Angled pins | 5 | 0.62 | 3.10 | Molex | 22288073 | DigiKey | WM50026-07-ND | http://www.digikey.com/product-search/en?WT.z_header=search_go&lang=en&site=us&x=18&y=14&formaction=on
Sonar mounts | 5 | 1.50 | 7.50 | ElcanoProject | Sonar-MNT
Machine screw 4-40 | 5 | 0.03 | 0.15 | B&F Fastener Supply | PMS 440 0075 PH | DigiKey | H350-ND | http://www.digikey.com/product-search/en/hardware-fasteners-accessories/screws-bolts/2097339?k=H350-ND
Hex nut 1/14” 4-40 | 5 | 0.02 | 0.10 | B&F Fastener Supply | HNZ 440 | DigiKey | H216-ND | http://www.digikey.com/product-search/en?WT.z_header=search_go&lang=en&site=us&x=16&y=13&formaction=on
Parts TOTAL |  |  | 20.43
Price |  |  | 80.00
Purchased separately
Maxbotix XL-MaxSonar EZ0, EZ2 or EZ4 | 5 | 45.00 | 225.00 | Maxbotix | MB-1202 | Pololu | 1650 | http://www.maxbotix.com/Ultrasonic_Sensors/MB1202.htm
Ethernet cable | 1 | 2.19 | 2.19 | Assmann WSW Comp | DK-1511-003/B | DigiKey | AE10481-ND | http://www.digikey.com/product-detail/en/DK-1511-003%2FB/AE10481-ND/2268273
TOTAL |  |  | 227.19
Grand total |  |  | 307.19
