lanfuli/Localization/elcano-master/Documentation/Wiring_C6Mega.xls

Sheet: C6 Navigator
Src/Dest | Wire color @ C6 | End Color | Dir | Signal | Mega
C2:5 | Green | Blue | > | Throttle | A00
C2:7 | Green | Green | > | DiskBrake | A01
C2:6 | Yellow | Yellow | > | Steer | A02
 |  |  |  |  | A03
 |  |  |  |  | A04
 |  |  |  |  | A05
 |  |  |  |  | A06
 |  |  |  |  | A07
 |  |  |  |  | A08
C3:9 |  | Blue | > | Cruise Throttle | A09
C3:10 |  | Green | > | Cruise Brake | A10
C3:11 |  | Yellow | > | Cruise Steer | A11
 |  |  |  |  | A12
 |  |  |  |  | A13
 |  |  |  |  | A14
 |  |  |  |  | A15
Serial Monitor in |  |  | > | Rx0; serial in | D00 (Rx0, D0 PWM)
Serial Monitor out |  |  | < | Tx0; serial out | D01 (Tx0, D1 PWM)
 |  |  |  |  | D02 Int 0
 |  |  |  |  | D03 Int 1
GPS J-11 6 |  |  |  | GPS Power | D04
GPS J-11 5 |  |  |  | GPS green LED | D05 PWM)
GPS J-11 4 |  |  |  | GPS red LED | D06 PWM)
GPS J-11 3 |  |  |  | GPS_PPS | D07 PWM)
GPS J-11 2 |  |  |  | GPS MMC_CD
GPS J-11 1 |  |  |  | GPS_MMC_WP
C3:A0 | Red | Black |  | Speed | D08
C3:A1 | Yellow | Gray |  | Direction | D09
Shield:D10 |  |  |  | Chip Select | D10
Shield:D11 |  |  |  | MOSI | D11
Shield:D12 |  |  |  | MISO | D12
Shield:D13 |  |  |  | CLK | D13
GPS J-11 7, Rx | Red | Red | < | GPS control | D14 TX3
GPS J-11 8, Tx | Orange | Orange | > | Location | D15 Rx3
C4:0 | Yellow | Orange | < | Navigation Fix | D16 Tx2
C4:3 | Green | Green | < | C6 Data available | D17 Rx2
INU:Rx | Blue |  | < | INU control | D18 Int 2, Tx1
INU:Tx | Brown |  | > | Bearing | D19 Int 3, Rx1
 | Gray |  |  |  | D20 Int 4
Cylclometer | Black |  | > | Odometer click | D21 INT 5
 | Red |  |  |  | Vcc
C2:4;C3:12 | Orange |  | > | Move OK | D23
 | Yellow |  |  |  | D25
 | Green |  |  |  | D27
 | Blue |  |  |  | D29
 | Brown |  |  |  | D31
 | Gray |  |  |  | D33
 | Black |  |  |  | D35
optical odometer |  |  |  |  | D49 LED
optical odometer |  |  |  |  | D50 MISO
optical odometer |  |  |  |  | D51 MOSI
optical odometer |  |  |  |  | D52 SCK
optical odometer |  |  |  |  | D53 SS

Sheet: C7 Vision
Src/Dest | Wire color | Connector Color | Dir | Signal | Mega | Source pin
C4:9 |  |  | > | Expected horizontal | A00
C4:10 |  |  | > | Expected vertical | A01
C4:11 |  |  | > | Expected size | A02
 |  |  |  |  | A03
 |  |  |  |  | A04
 |  |  |  |  | A05
 |  |  |  |  | A06
 |  |  |  |  | A07
 |  |  |  |  | A08
 |  |  |  |  | A09
 |  |  |  |  | A10
 |  |  |  |  | A11
 |  |  |  |  | A12
 |  |  |  |  | A13
 |  |  |  |  | A14
 |  |  |  |  | A15
Web cam |  | USB | > | Camera | D00 (Rx0, D0 PWM)
Web cam |  | USB | < | Camera control | D01 (Tx0, D1 PWM)
 |  |  |  |  | D02 Int 0
 |  |  |  |  | D03 Int 1
C4:A0 |  |  | < | Horizontal | D04
C4:A1 |  |  | < | Vertical | D05 PWM)
C4:A2 |  |  | < | Size | D06 PWM)
C4:A3 |  |  | < | Coneness | D07 PWM)
 |  |  |  |  | D08
 |  |  |  |  | D09
 |  |  |  |  | D10
 |  |  |  |  | D11
 |  |  |  |  | D12
 |  |  |  |  | D13
 |  |  |  |  | D14 TX3
 |  |  |  |  | D15 Rx3
 |  |  |  |  | D16 Tx2
 |  |  |  |  | D17 Rx2
 |  |  |  |  | D18 Int 2
 |  |  |  |  | D19 Int 3
 |  |  |  |  | D20 Int 4
 |  |  |  |  | D21 INT 5
 |  |  |  |  | D22-D53
 |  |  |  |  | P0 Reset
 |  |  |  |  | P1 3V3
 |  |  |  |  | P2 5V
 |  |  |  |  | P3 Gnd
 |  |  |  |  | P4 Gnd
 |  |  |  |  | P5 Vin

Sheet: C4 Path
Src/Dest | Color @ Arduino | End Color | Dir | Signal | 2009 | Source pin
C6:16 | Orange | Yellow | > | Navigation fix | J1:1 (RxD, D0)
C3:0 | Red | Red | < | Path | J1:2 (TxD, D1)
C6:17 | Green | Green | > | C6 Data available | J1:3 (D2 INT0)
C3:2 | Yellow | Yellow | < | C4 Data available | J1:4 (D3 INT1, PWM)
 |  |  |  |  | J1:5 (D4)
 |  |  |  |  | J1:6 (D5 PWM)
 |  |  |  |  | J1:7 (D6 PWM)
 |  |  |  |  | J1:8 (D7)
 |  |  |  |  | J3:1 (D8)
C7:A0 |  |  | < | Expected horizontal | J3:2 (D9 PWM)
C7:A1 |  |  | < | Expected vertical | J3:3 (D10 PWM)
C7:A2 |  |  | < | Expected size | J3:4 (D11 PWM)
 |  |  |  |  | J3:5 (D12)
 |  |  |  |  | J3:6 (D13)
 |  |  |  |  | J3:7 (Ground)
 |  |  |  |  | J3:8 (AREF)
C7:4 |  |  | > | Horizontal | J2:1 (ADC0/D14)
C7:5 |  |  | > | Vertical | J2:2 (ADC1/D15)
C7:6 |  |  | > | Size | J2:3 (ADC2/D16)
C7:7 |  |  | > | Coneness | J2:4 (ADC3/D17)
L-3 |  |  | > | Sonar range | J2:5 (ADC4/D18)
R-3 |  |  | > | Sonar range | J2:6 (ADC5/D19)

Sheet: C3 Pilot
Src/Dest | Color @ Arduino | End color | Dir | Signal | 2009
C4:1 | Red | Red | > | Path | J1:1 (RxD, D0)
 |  |  |  |  | J1:2 (TxD, D1)
C4:3 | Yellow | Yellow | > | C4 Data available | J1:3 (D2 INT0)
 |  |  |  |  | J1:4 (D3 INT1, PWM)
 |  |  |  |  | J1:5 (D4)
F-1 |  |  | < | Chaining | J1:6 (D5 PWM)
Relay |  |  | < | Power FL,FR | J1:7 (D6 PWM)
Relay |  |  | < | Power F | J1:8 (D7)
 |  |  |  |  | J3:1 (D8)
C2:A9, C6:A9 |  |  | < | Cruise Throttle | J3:2 (D9 PWM)
C2:A10,C6:A10 |  |  | < | Cruise Brake | J3:3 (D10 PWM)
C2:A11,C6:A11 |  |  | < | Cruise Steer | J3:4 (D11 PWM)
C2:4;C6:23 |  |  | > | Move OK | J3:5 (D12)
 |  |  |  |  | J3:6 (D13)
 |  |  |  |  | J3:7 (Ground)
 |  |  |  |  | J3:8 (AREF)
C6:8 |  |  | > | Speed | J2:1 (A0)
C6:9 |  |  | > | Direction | J2:2 (A1)
 |  |  | > |  | J2:3 (A2)
F-3 | Green | Yellow | > | Sonar range | J2:4 (A3)
FL-3 | Green | Orange | > | Sonar range | J2:5 (A4)
FR-3 | Green | Red | > | Sonar range | J2:6 (A5)
 |  | (none) |  |  | P0 Reset
 |  | (none) |  |  | P1 3V3
F-1 | Orange | Black | < | Select Tx / chaining | P2 5V
F-4 | Blue | Black | < | Enable ranging | P2 5V
F-6 | Gray | Black | < | Vcc | P2 5V
FL-1 | Orange | Black | < | Select Tx / chaining | P2 5V
FL-4 | Blue | Black | < | Enable ranging | P2 5V
FL-6 | Gray | Black | < | Vcc | P2 5V
FR-1 | Orange | Black | < | Select Tx / chaining | P2 5V
FR-4 | Blue | Black | < | Enable ranging | P2 5V
FR-6 | Gray | Black | < | Vcc | P2 5V
F-7 | Black | Gray |  | Ground | P3 Gnd
FL-7 | Black | Gray |  | Ground | P3 Gnd
FR-7 | Black | Gray |  | Ground | P3 Gnd
(none) | (none) | Brown |  |  | P4 Gnd
(none) | (none) | Blue |  |  | P5 Vin
(none) | (none) | Green |  |  | P6 (none)
F-0 | Red | (none) |  | (none)
F-2 | Yellow | (none) | > | Pulse width
F-5 | Brown | (none) | > | Tx serial out
FL-0 | Red | (none) |  | (none)
FL-2 | Yellow | (none) | > | Pulse width
FL-5 | Brown | (none) | > | Tx serial out
FR-0 | Red | (none) |  | (none)
FR-2 | Yellow | (none) | > | Pulse width
FR-5 | Brown | (none) | > | Tx serial out
