lanfuli/Localization/elcano-master/Electronics/ArduinoMegaPins.xls

Eagle CAD produced file giving positions of pins on the Arduino Mega.
 |  |  |  |  |  |  | relative position
Part | Value | Description | Library | x position | y position | Rotation | 4200 | 2600
IC4 | ATMEGA8U2-MU | QFN32 | atmel | 720 | 1500 | R90
IC3 | ATMEGA2560-16AU | TQFP100 | atmel-2005 | 2000 | 1116 | R0
D1 | M7 | SMB | diode | 725 | 475 | R180
L | YELLOW | CHIP-LED0805 | led | 1100 | 1650 | R90
ON | GREEN | CHIP-LED0805 | led | 3000 | 1450 | R90
RX | YELLOW | CHIP-LED0805 | led | 1100 | 1350 | R90
TX | YELLOW | CHIP-LED0805 | led | 1100 | 1450 | R90
IC1 | MC33269ST-5.0T3 | SOT223 | linear | 340 | 700 | R90
IC2 | MC33269D-5.0 | DPACK | linear | 275 | 700 | R90
IC5 | LM358D | SO08 | linear | 720 | 850 | R270
POWER | POWER | 1X06 | pinhead | 1550 | 100 | R0 | 2650 | 2500
A0-7 | ADCL | 1X08 | pinhead | 2350 | 100 | R0 | 1850 | 2500
A8-15 | ADCH | 1X08 | pinhead | 3250 | 100 | R0 | 950 | 2500
JP3 | JP3 | 1X01 | pinhead | 3700 | 300 | R0 | 500 | 2300
JP4 | JP4 | 1X01 | pinhead | 3800 | 300 | R0 | 400 | 2300
RESET-EN | RESET-EN | SJ | jumper | 1100 | 600 | R0 | 3100 | 2000
D38-53 | XIOL | 2X08 | pinhead | 3750 | 750 | R90 | 450 | 1850
ICSP | ICSP | 2X03 | pinhead | 2555 | 1100 | R270 | 1645 | 1500
GROUND | GROUND | SJ | jumper | 425 | 1300 | MR180 | 3775 | 1300
D22-37 | XIOH | 2X08 | pinhead | 3750 | 1550 | R90 | 450 | 1050
UBOOT | UBOOT | SJ | jumper | 830 | 1610 | MR90 | 3370 | 990
ICSP1 | ICSP | 2X03 | pinhead | 720 | 1820 | R180 | 3480 | 780
D8-13 | PWMH | 1X08 | pinhead | 1290 | 2000 | R180 | 2910 | 600
D0-7 | PWML | 1X08 | pinhead | 2150 | 2000 | R180 | 2050 | 600
D14-21 | COMMUNICATION | 1X08 | pinhead | 3050 | 2000 | R180 | 1150 | 600
JP1 | JP1 | 1X01 | pinhead | 3700 | 2000 | R0 | 500 | 600
JP2 | JP2 | 1X01 | pinhead | 3800 | 2000 | R0 | 400 | 600
 |  |  | hole | 550 | 100 |  | 3650 | 2500
 |  |  | hole | 2600 | 300 |  | 1600 | 2300
 |  |  | hole | 3800 | 100 |  | 400 | 2500
 |  |  | hole | 600 | 2000 |  | 3600 | 600
 |  |  | hole | 2600 | 1400 |  | 1600 | 1200
 |  |  | hole | 3550 | 2000 |  | 650 | 600
X1 | DC21MMX | DC-21MM | powersupply | 210 | 330 | R90
C11 | 100n | C0603 | rcl | 850 | 1000 | R0
C8 | 100n | C0603 | rcl | 600 | 1000 | R0
F1 | 500mA | L1812 | rcl | 175 | 1000 | R180
PC1 | 47u | PANASONIC_D | rcl | 800 | 225 | R90
PC2 | 47u | PANASONIC_D | rcl | 1100 | 225 | R90
RN1 | 10K | CAT16 | resistor-dil | 3175 | 1450 | R270
RN2 | 22R | CAY16 | resistor-dil | 475 | 1500 | R90
RN3 | 1k | CAY16 | resistor-dil | 1100 | 1550 | R270
RN4 | 1k | CAY16 | resistor-dil | 1100 | 1225 | R90
RN5 | 10K | CAT16 | resistor-dil | 725 | 650 | R90
C1 | 22p | C0603-ROUND | SmartPrj | 1100 | 525 | R180
C10 | 1u | C0603-ROUND | SmartPrj | 475 | 1725 | R180
C12 | 100n | C0603-ROUND | SmartPrj | 850 | 700 | R180
C13 | 100n | C0603-ROUND | SmartPrj | 1100 | 850 | R0
C14 | 22p | C0603-ROUND | SmartPrj | 1575 | 450 | R90
C15 | 22p | C0603-ROUND | SmartPrj | 1575 | 700 | R270
C16 | 22p | C0603-ROUND | SmartPrj | 600 | 1075 | R180
C17 | 22p | C0603-ROUND | SmartPrj | 850 | 1075 | R0
C2 | 100n | C0603-ROUND | SmartPrj | 600 | 700 | R0
C3 | 100n | C0603-ROUND | SmartPrj | 1100 | 1750 | R0
C4 | 100n | C0603-ROUND | SmartPrj | 1520 | 280 | R0
C5 | 100n | C0603-ROUND | SmartPrj | 2320 | 1550 | R0
C6 | 100n | C0603-ROUND | SmartPrj | 1576.5748 | 1197.59843 | R180
C7 | 100n | C0603-ROUND | SmartPrj | 1100 | 700 | R0
C9 | 100n | C0603-ROUND | SmartPrj | 850 | 1325 | R0
R1 | 1M | R0603-ROUND | SmartPrj | 1575 | 575 | R90
R2 | 1M | R0603-ROUND | SmartPrj | 725 | 1075 | R0
R3 | 27R | R0603-ROUND | SmartPrj | 1650 | 575 | R270
R4 | 27R | R0603-ROUND | SmartPrj | 600 | 1325 | R180
U$2 | FIDUCIALMOUNT | FIDUCIA-MOUNT | SmartPrj | 2789 | 1503.62992 | R0
U$3 | FIDUCIALMOUNT | FIDUCIA-MOUNT | SmartPrj | 105 | 95 | R0
U$4 | FIDUCIALMOUNT | FIDUCIA-MOUNT | SmartPrj | 780 | 2000 | R0
U$5 | FIDUCIALMOUNT | FIDUCIA-MOUNT | SmartPrj | 2000 | 1116 | R0
X2 | X2 | PN61729 | SmartPrj | 150 | 1500 | R270
Y1 | 16MHz | RESONATOR | SmartPrj | 1450 | 575 | R270
Y2 | 16MHz | RESONATOR | SmartPrj | 720 | 1200 | R180
Q1 | 16MHz | QS | special | 720 | 1200 | R180
Q2 | 16MHz | QS | special | 1450 | 575 | R270
RESET | TS42 | TS42 | st-mod | 2920 | 1100 | R90
IC6 | LP2985-33DBVR | SOT23-DBV | texas | 1100 | 991 | R180
Z1 | PGB1010604 | CT/CN0603 | varistor | 475 | 1400 | R0
Z2 | PGB1010604 | CT/CN0603 | varistor | 475 | 1600 | R0
L1 | BLM21 | 805 | wuerth-elektronik | 325 | 1780 | R180
T2 | FDN340P | SOT-23 | zetex | 375 | 1000 | R270
