lanfuli/Localization/elcano-master/Documentation/Power.xls

Power requirements for changes in speed, slope or headwind.
Maximum power at full throttle | 250 | W |  |  | 0.3351206434 | hp |  |  |  |  | Final speed |  |  | Additional Power required
Overall mechanical efficiency of transmission | 0.95 |  |  |  |  |  |  |  | Initial power | Initial Speed | 2 | 4 | 6 | 8 | 10 | 12 | 14 | 16 | 18
Total mass | 25 | Kg |  |  | 55 | lb |  |  | 0 | 0 | 3.775829363 | 12.19755346 | 29.91106704 | 61.56226482 | 111.7970416 | 185.261292 | 286.6009108 | 420.4617928 | 591.4898327
Gravitational acceleration | 9.806 | m/sec^2 |  |  |  |  |  |  | 3.775829363 | 2 | 0 | 8.4217241 | 26.13523767 | 57.78643546 | 108.0212122 | 181.4854626 | 282.8250814 | 416.6859634 | 587.7140033
Coefficient of rolling resistance | 0.004 |  |  |  |  |  |  |  | 12.19755346 | 4 |  | 0 | 17.71351357 | 49.36471136 | 99.59948809 | 173.0637385 | 274.4033573 | 408.2642393 | 579.2922792
Initial Upslope | 0 | % |  |  |  |  |  |  | 29.91106704 | 6 |  |  | 0 | 31.65119778 | 81.88597452 | 155.3502249 | 256.6898438 | 390.5507258 | 561.5787657
Vehicle acceleration | 0.50 | m/sec^2 |  |  |  |  |  |  | 61.56226482 | 8 |  |  |  | 0 | 50.23477673 | 123.6990271 | 225.038646 | 358.899528 | 529.9275679
Effective rotational mass of wheels | 1 | Kg |  |  | 2.2 | lb |  |  | 111.7970416 | 10 |  |  |  |  | 0 | 73.46425042 | 174.8038693 | 308.6647512 | 479.6927911
Aerodynamic drag coefficient | 0.5 |  |  |  |  |  |  |  | 185.261292 | 12 |  |  |  |  |  | 0 | 101.3396188 | 235.2005008 | 406.2285407
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
Change in throttle for change in speed | 255 |  |  |  |  |  | 916.7324722 | 16 | 255 | 16 |  |  |  |  |  |  |  | 0 | 0
Maximum acceleration | 0.7120056478 | m/sec^2
Final upslope | 0 | %
Final headwind | 0 | m/sec
Wheel diameter | 2 | m |  |  | 78.74015748 | in
