lanfuli/Localization/elcano-master/Documentation/Assembly/MegaBoardDB_Assembly.docx

# MegaBoardDB

Assembly Instructions

Take Photos of every step and add to this document.

# Parts list:

- MegaBoardDB Arduino shield (Qty: 1)
- 8-pin long tailed sockets - (Qty: 3)
- 6-pin long tailed socket - (Qty: 1)
- 8-pin headers - (Qty: 2)
- 2x18 pin header - (Qty: 1)
- 8-pin DIP integrated circuits - (Qty: 2)
- 0.1 uF Capacitors - (Qty: 2)
- 6 pin In-Circuit Serial Programming (ICSP) Sockets - (Qty: 1)
- DB25-Male connector - (Qty: 1)
- DB25-Female connector - (Qty: 1)
- DB15-Male connector - (Qty: 1)
- DB9-Female connector - (Qty: 1)
- DB9-Male connector - (Qty: 1)
- 2x6 pin header (Qty: 2)
- 1M Ω (Brown Black Green) resistor - (Qty: 1)
- Jumper - (Qty: 1)

# Assembly instruction:

## Without Wireless E-Stop:

1 ADCL, POWER, PWML, and PWMH shield stacking headers for Arduino
  a Find:
    - 8-pin long tailed sockets (Qty: 3) for PWML (D0-7), PWMH (D8-13), and ADCL (A0-7)
    - 6-pin long tailed socket (Qty: 1) for POWER
  b The analog-in socket is 8-pins, even though there are only 6-pins on shields.
  c Place MegaShieldDB board on up position (Text visible)
  d Secure sockets in a shield
  e Flip the board down.
  f Solder all 30 pins in place, making sure to maintain proper alignment with the Arduino board.
2 ADCH, COMMUNICATION, XIOL, and XIOH headers
  a Get:
    - 8-pin headers (Qty: 2) for ADCH (A8-15) and COMMUNICATION (D14-21)
    - 2x18 pin header (Qty: 1) for XIOL and XIOH (DIGITAL)
  b Place the long tails of the three connectors into sockets on an Arduino Mega board.
  c Place MegaShieldDB board on up position on top of the MegaShieldDB.
  d Align the Arduino Mega and the MegaShieldDB, so that the short pins on the three new headers stick though the board. (There will be a gap on the long-tailed sockets from step 1.)
  e Solder all 52 connector pins.
3 Integrated Circuits (IC)
  a 8-pin DIP integrated circuits:
    - IC2 - on the right with notch down (closer to IC2 text).
    - IC3 - on the left with notch up (closer to IC3 text).
  b With the MegaShieldDB board on up position, place these two IC.
  c Flip the board down.
  d Solder these IC in place.
4 Capacitors
  a Place two capacitors (0.1 uF):
    - C1 and C2 next to the ICs you just added.
  b They are ceramic and it doesn't matter which end is which.
  c Solder these in place.
  d Flip the MegaShield Snip off the leads after soldering.
5 In-Circuit Serial Programming (ICSP) Sockets
  a Place the 6-pin ICSP socket on the Arduino ICSP pins
  b Line up Arduino and MegaBoardDB.
  c Solder the ICSP connector into MegaBoardDB.
6 DB connectors
  a Snaps DB connectors into the board:
    - X1 - DB25-Male connector
    - X2 - DB25-Female connector
    - X3 - DB15-Male connector
    - X4 - DB9-Female connector
    - X5 - DB9-Male connector
  b Solder DB connectors in place
7 ICSP and JP9
  a Find:
    - 2x6 pin header (Qty: 2)
  c Place and Solder ICSP and JP9
8 Resistor
  a Place and Solder R1 (1M Ω - Brown Black Green)
9 Jumper setting
  a For without wireless E-Stop setting, place jumper on the JP9 (pin 3 and 5)

# Wireless E-Stop
