lanfuli/Localization/elcano-master/Documentation/Wiring.xls

Sheet: Internal
25 Pin D | Color | Dir | System | Signal | Proto board | C1 Motor | C3 Pilot
1 | brown |  | Pilot | TxD Serial DRIVE cmd |  |  | J1:2 (TxD, D1)
2 | red | < | Test | TxD Serial odometer |  | J1:2 (TxD, D1)
3 | orange | > | Pilot | RxD Serial state |  |  | J1:1 (RxD, D0)
4 | tan | > | Control | Reset |  |  | Power:1 (Reset)
5 | yellow | > | Control | AREF |  | J3:8 (AREF)
6 | dark green | > | Steer | Actual steer angle |  | J2:1 (ADC0)
7 | pale green |  | Motor | cyclometer ground | J6:4 ground
8 | dark blue | > | Motor | Motor temperature |  | J2:2 (ADC1)
9 | pale blue | > | Control | SelectPID |  | J1:8 (D7)
10 | purple | > | Brakes | Brake feedback |  | J2:3 (ADC2)
11 | gray | > | Pilot | switch bit 2 |  |  | J1:7 (D6)
12 | white | > | Pilot | switch bit 1 |  |  | J1:6 (D5)
13 | black | > | Pilot | switch bit 0 |  |  | J1:4 (D3 INT1)
14 | brown-black | > | Motor | Cyclometer input | J6:7 To pull-up resistor
15 | red-black | < | Motor | Reverse switch |  | J1:5 (D4)
16 | orange-black | > | Control | Halt |  | J1:4 (D3 INT1) | J1:8 (D7)
17 | tan-black | < | Motor | Traction motor throttle (A1) |  | J1:6 (D5)
18 | yellow-black | > | Control | Tune PID |  | J1:7 (D6)
19 | dark green-black | > | Control | E-Stop |  |  | J1:5 (D4)
20 | pale green-black | < | Motor | Recombinant brake switch |  | J3:1 (D8)
21 | dark blue-black | < | Brakes | Disk brakes (A2) |  | J3:2 (D9)
22 | pale blue-black | < | Motor | Recombinant braking |  | J3:3 (D10)
23 | purple-black | < | Steer | Steering actuator (A3) |  | J3:4 (D11)
24 | gray-black | < | Motor | Throttle switch |  | J3:5 (D12)
25 | white-black |  |  | spare
case | bare |  |  | shield
 | brown | < |  | obsolete | J6:8 timer in |  | J3:1 (D8)
 | orange | < | Pilot | Gamebot cmd |  | J1:1 (RxD, D0) | J1:2 (TxD, D1)
 | Blue | > | Motor | Cyclometer input | J6:3 Pulled-up | J1:3 (D2 INT0)
 | Green | > | Control | Ack |  | J1:8 (D7) | J1:3 (D2 INT0)
 | Green | < | Test | C1 LED | J6:9 LED 1 | J3:6 (D13)
 | yellow | < | Control | Delayed Reset |  | Power:1 (Reset) | J3:1 (D8)
 | Green | > |  | obsolete | J6:2 timer out | Power:1 (Reset)
 | red | < | Power | +5 V | J6:5 Vcc | Power:3
 | black | < | Power | Ground | J6:6 Gnd | Power:4
 | yellow | < | Test | C3 LED | J6:1 LED 2 |  | J3:6 (D13)

Sheet: External
Wire colors on a particular 25 pin cable. |  |  |  | Wire usage
25 Pin D | Color | Dir | System | Signal | Kelly Controller | Cyclometer | Disk Brakes | Steer | Destination | Console
1 | brown | < | Pilot | TxD Serial DRIVE cmd |  |  |  |  | C6: Navigator
2 | red | < | Test | TxD Serial odometer |  |  |  |  | C6: Navigator
3 | orange | > | Pilot | RxD Serial state |  |  |  |  | C6: Navigator
4 | tan | > | Control | Reset |  |  |  |  |  | X
5 | yellow | > | Control | AREF |  |  |  |  |  | X
6 | dark green | > | Steer | Actual steer angle |  |  |  | X
7 | pale green |  | Motor | cyclometer ground | J2:2 Signal RTN | Green
8 | dark blue | > | Motor | Motor temperature | J2:4
9 | pale blue | > |  | spare
10 | purple | > | Brakes | Brake feedback |  |  | X
11 | gray | > | Pilot | switch bit 2 |  |  |  |  |  | X
12 | white | > | Pilot | switch bit 1 |  |  |  |  |  | X
13 | black | > | Pilot | switch bit 0 |  |  |  |  |  | X
14 | brown-black | > | Motor | Cyclometer input |  | Red
15 | red-black | < | Motor | Reverse switch | J2:9
16 | orange-black | < | Control | Halt |  |  |  |  |  | X
17 | tan-black | < | Motor | Traction motor throttle (A1) | J2:5 Throttle
18 | yellow-black |  |  | spare
19 | dark green-black | < | Control | E-Stop |  |  |  |  |  | X
20 | pale green-black | < | Motor | Recombinant brake switch | J2:10 Brake switch
21 | dark blue-black | < | Brakes | Disk brakes (A2) |  |  | X
22 | pale blue-black | < | Motor | Recombinant braking | J2:6 Brake
23 | purple-black | < | Steer | Steering actuator (A3) |  |  |  | X
24 | gray-black | < | Motor | Throttle switch | J2:8
25 | white-black |  |  | spare
case | bare |  |  | shield
