lanfuli/Localization/elcano-master/Documentation/Wiring_C2.xls

Sheet: Internal
DEPRICATED | Old signals on low-level board. |  |  | The relay board is no longer used.
Src/Dest | Wire color | Connector Color | Dir | Signal | C2 Controls | External | Ex connector | Ex wire
Ground |  | Black |  | Ground | -Charge LED | Motor Control T | Black
Motor control 36V throttle |  | Red | > | 36 V fuel | +Charge LED | Motor Control T | Red
Reverse button | Green | Brown | > | Reverse button | J1:1 (RxD, D0) | Stick | Brown
C1 Reverse Cmd | Green | purple | > | Cruise Reverse | J1:2 (TxD, D1) | C1 | Red | Red-black
Stop from NOR3 (pin 8) | White |  | > | Stop | J1:3 (D2 INT0)
Cruise from NOR2 (pin 6) | Green |  | > | Cruise | J1:4 (D3 INT1)
Panel Green switch | Red |  | > | EnableThrottle | J1:5 (D4)
Panel Red switch | Black |  | > | EnableBrake | J1:6 (D5)
Panel Blue switch | White |  | > | EnableSteer | J1:7 (D6)
to Motor controller | Black |  | < | Reverse | J1:8 | Motor Control T
Joystick blue | White | Blue | > | MotionJoystick | J2:1 (ADC0/D14) | Stick | Blue | Blue
Joystick yellow | Black | Yellow | > | SteerJoystick | J2:2 (ADC1/D15) | Stick | Yellow | Yellow
Joystick Green | Red | Green | > | JoystickCenter | J2:3 (ADC2/D16) | Stick | Green | Green
C1 Throttle Cmd | White | Blue | > | Cruise Throttle | J2:4 | C1 | Blue | Tan-black
C1 Brake Cmd | Black | Green | > | Cruise Brake | J2:5 | C1 | Green | Blue
C1 Steer Cmd | Red | Yellow | > | Cruise Steer | J2:6 | C1 | Yellow | Purple-black
Panel Green LED | Blue |  | < | CruiseLED | J3:1 (D8)
to Motor controller | Green | Blue | < | Throttle | J3:2 (D9) | Motor Control T | Blue | Green
Steer servo | Yellow | Yellow | < | Steer | J3:3 (D10)
Brake servo | Green | Green | < | DiskBrake | J3:4 (D11)
Panel Red LED | Red |  | < | StopLED | J3:5 (D12)
Reverse LED | Orange |  | < | C2 LED | J3:6 (D13)
Ground | Black | Black |  | Ground | J3:7 (Ground) | C1
Ground | Black | Black |  | Ground | J3:7 (Ground) | Stick | Black | black
Brake servo 5V | Red | Pink | > | AREF | J3:8 (AREF) | C1
Brake servo 5V | Red | Pink | > | AREF | J3:8 (AREF) | Stick | Pink | red
~Motor power from NOR1 (pin 12) |  |  |  | E-stop | NOR3 pin 11
RC cruise button to NOR2 (pin 3,4) |  |  |  | CruiseRC | Relay 1C
RC stop button to NOR3 (pin 9) |  |  |  | StopRC | Relay 2C
Battery to relay board | Black | Red | > | 36 V | Relay 4B | Battery | Red | White
from relay to motor control | Black | Red | < | 36 V | Relay 4C | Motor Control P | Red | White
to Panel On switch | Black | orange | > | 12 v power |  | Battery | orange | Brown
Ground | Black | Black |  | Ground |  | Battery | Black | Green
C1 LED | Green | purple | > | LED 1 |  | C1 | purple
C3 LED | Black | Blue | > | LED 3 |  | C3 | Blue
C4 LED | White | Green | > | LED 4 |  | C4 | Green
C5 LED | Green | Yellow | > | LED 5 |  | C5 | Yellow
C6 LED | Red | Brown | > | LED 6 |  | C6 | Brown
C7 LED | Black | Gray | > | LED 7 |  | C7 | Gray
C8 LED | White | white | > | LED 8 |  | C8 | white
Steer servo 5V |  | Pink | < | +5 V |  | C4-8 | Pink
Ground |  | Black |  | Ground |  | C4-8 | Black
Ground |  | Black |  | Ground |  | Motor Control P | Black | black
Motor 5V to NOR1 (pin 1,2,13) | Red | Pink | > | MC 5 V |  | Motor Control T | Pink | Red
Panel Red button to NOR3 (pin 10) |  |  |  | StopButton
Panel Black button to NOR2 (pin 5) |  |  |  | CruiseButton

Sheet: Relay
Relay board is 4 channel remote. |  |  | Source: www.carrymart.com | Shenzhen Guiyuan Iindustry Development Co.
The relay board soldered to the main MegaShieldDB.
It received four signals from a key-chain fob designed as a remote door locking device.
The remote was our first attempt at e-stop
It was discontinued since we found that the range was much too short.
Transmit frequency: 315 MHz or 433 MHz
Relay board has 14 connectors.
On all channels, A and C are connected. |  |  | Relay OFF: B to A is on and B to C is off. |  | Relay ON: B to C is on and B to A is off.
Relay board is operated in mode (4). |  |  | Both Jumper 1 and Jumper 2 are connected.
Buttons 1 and 2 are momentary switches.
Button 1: | Cruise | Start operation in autonomous mode.
Button 2: | Stop | Bring vehicle to stop without turning off 36-volt power
Buttons 3 and 4 toggle on/off when pushed.
Button 3: | Not used
Button 4: | 36 V power on/off | E-stop | Duplicates the function of the motor controller key switch
Pins: | Signal | Color | Destination
- | Ground | Black | Battery and other
+ | 12 V | Green | On switch via orange connector
1A | Not used
1B | 5V | Red | 2B
1B | 5V | Red | Perf 21
1C | Cruise | Green | Perf 24
2A | Not used
2B | 5V | Red | 1B
2C | Stop | White | Perf 23
3A | Not used
3B | Not used
3C | Not used
4A
4B
4C

Sheet: Servos
Brake servo
Gray cable from servo to servo controller
Wire color | Connector color | Signal
Red | Orange | 12V | 5A fuse
Black | Black | Ground
Red | Pink | 5V | Within box
Black | Black | Ground
Yellow | Green | Brake
Steer servo
Gray cable from servo to servo controller
Wire color | Connector color | Signal
Red | Orange | 12V | 5A fuse
Black | Black | Ground
Red | Pink | 5V | Leaves box to power external devices
Black | Black | Ground
Yellow | Yellow | Steer
Battery 12 V goes to ON switch
If switch is ON, 12 V goes to brake servo, steer servo and relay board.

Sheet: Perf board
Bottom Dest | Bottom Color | Signal | Top Destnation | Top Color | Pin | Pin | Top Color | Top Destnation | Signal | Bottom Color | Bottom Dest
 |  | Ground |  |  | 1 | 2 |  |  | 5 V
 |  | Ground |  |  | 3 | 4 |  |  | 5 V
 | Black | Ground | External | White | 5 | 6 | Red | External | 5 V | Red
 |  | Ground |  |  | 7 | 8 |  |  | 5 V
 |  |  |  |  | 9 | 10 |  |  | 5 V
 |  |  |  |  | 11 | 12 |  |  | 5 V
 |  | 5 V | Cruise button | Red | 13 | 14 | Red | Stop button | 5 V
 |  |  |  |  | 15 | 16
NOR 5: 2C | Orange |  | Cruise button | Brown | 17 | 18 | White | Stop button |  | Green | NOR 10: 3B
Spare | Red |  |  | (pin) | 19 | 20 |  |  |  | Red | Spare
 | Yellow | 5V | Relay 1B | Red | 21 | 22 |  |  |  | Black | NOR 10: 3B
 | White | Stop RC | Relay 2C | White | 23 | 24 | Green | Relay 1C | Cruise RC |  | NOR 4: 2B
 |  | Function | Signal | 74LS27 |  |  |  | Signal | Function | Dest
 |  | 1A Nor in | MC 5V |  | 1 | 14 | Red | Servo supply | 5 V
 |  | 1B Nor in | MC 5V |  | 2 | 13 |  | MC 5V | 1C Nor in
 |  | 2A Nor in | Cruise RC |  | 3 | 12 |  | ~MC power | 1Y Nor out
 |  | 2B Nor in | Cruise RC |  | 4 | 11 |  | ~MC power | 3C Nor in
 | Panel Black button to NOR2 (pin 5) | 2C Nor in | Cruise button | White | 5 | 10 | Green | Stop button | 3B Nor in | Panel Red button to NOR3 (pin 10)
 | J1:4 (D3 INT1) | 2Y Nor out | Cruise | Green | 6 | 9 |  | Stop RC | 3A Nor in
 |  | Ground |  | Black | 7 | 8 | White | Stop | 3Y Nor out | J1:3 (D2 INT0)
