lanfuli/Localization/elcano-master/Documentation/Wiring_C2Mega.xls

Sheet: Internal
DEPRICATED |  |  | We no longer use the power distribution posts or the current sensors
Src/Dest | Src | Dest | Wire color | Connector Color | Dir | Signal | Mega | Formerly | Ex wire
Lower box ACS758 A | 3 | 2 | Green |  | > | 36V current | A00 | (Arduino duemillenove)
Lower box ACS758 B | 3 | 2 | Red |  | > | Steer current | A01
Lower box ACS758 C | 3 | 2 | Black |  | > | Brake Current | A02
reserved | 3 | 0 | White |  | > |  | A03
Shield | 3 | 10 |  |  | > | RTC SDA | A04
Shield | 3 | 10 |  |  | > | RTC SCL | A05
reserved | 3 | 0 |  |  | > |  | A06
reserved | 3 | 0 |  |  | > |  | A07
Brake servo blue | 3 | 7 | 4-Green | Blue | > | Brake Feedback | A08
Joystick Green | 3 | 5 | 4-Red | Green | > | JoystickCenter | A09 | A02 | Green
Joystick yellow | 3 | 5 | 4-Black | Yellow | > | SteerJoystick | A10 | A01 | Yellow
Joystick blue | 3 | 5 | 4-White | Blue | > | MotionJoystick | A11 | A00 | Blue
Steer servo blue | 3 | 8 | 3-Green | Blue (Purple) | > | Steer Feedback | A12
C3:9 | 3 | 6 | 3-Red | Yellow | > | Cruise Steer | A13 | A05 | Purple-black
C3:10 | 3 | 6 | 3-Black | Green | > | Cruise Brake | A14 | A04 | Blue
C3:11 | 3 | 6 | 3-White | Blue | > | Cruise Throttle | A15 | A03 | Tan-black
Serial Monitor in | 3 | 0 |  |  | > | Rx0; serial in | D00 (Rx0, D0 PWM)
Serial Monitor out | 3 | 0 |  |  | < | Tx0; serial out | D01 (Tx0, D1 PWM) |  | Red-black
Motor controller 5V | 3 | 9 | 1-Red |  | > | ~Estop | D02 Int 0 | D02 (NOR)
reserved | 3 | 0 |  |  |  |  | D03 Int 1
C3:12 | 3 | 6 |  |  | < | Move OK | D04
Motor controller,C3:A3,C6:A3 | 3 | 11 | Green | Blue | < | Traction motor Throttle | D05 PWM) | D09 | Green
Analog motor control | 11 | 9
Steer servo,C3:A4,C6:A4 | 3 | 8 | Yellow | Yellow | < | Steer | D06 PWM) | D10
Brake servo,C3:A5,C6:A5 | 3 | 7 | Green | Green | < | DiskBrake | D07 PWM) | D11
reserved | 3 | 0 |  |  |  |  | D08
reserved | 3 | 0 |  |  |  |  | D09
Shield | 3 | 10 |  |  |  | Chip Select | D10
Shield | 3 | 10 |  |  |  | MOSI | D11
Shield | 3 | 10 |  |  |  | MISO | D12
Shield | 3 | 10 |  |  |  | CLK | D13
reserved | 3 | 0 |  |  |  |  | D14 TX3
C3 Drive command | 3 | 6 |  |  | > | (serial) | D15 Rx3
reserved | 3 | 0 |  |  |  |  | D16 Tx2
reserved | 3 | 0 |  |  |  |  | D17 Rx2
Lower box: relay 2C | 3 | 4 |  |  | > | Stop RC-2 | D18 Int 2 | D02 (NOR)
Lower box: relay 1C | 3 | 4 |  |  | > | Cruise RC-1 | D19 Int 3 | D03 (NOR)
Panel Stop | 3 | 1 | White |  | > | Stop Button | D20 Int 4 | D02 (NOR)
Panel Cruise | 3 | 1 | Green |  | > | Cruise Button | D21 INT 5 | D03 (NOR)
Panel Blue switch | 3 | 1 | White-green |  | > | EnableSteer | D22 | D06
C1 LED | 3 | 1 | 6-Green | purple | < | LED 1 out | D23
Panel Red switch | 3 | 1 | White-orange |  | > | EnableBrake | D24 | D05
Motor controller reserved | 3 | 9 | 6-Red |  | < | Reverse | D25 | D07
Panel Green switch | 3 | 1 | Orange-white |  | > | EnableThrottle | D26 | D04
C3 LED | 3 | 1 | 6-Black | Blue | < | LED 3 out | D27
Panel Green LED | 3 | 1 | Green-white |  | < | CruiseLED | D28 | D08
C4 LED | 3 | 1 | 6-White | Green | < | LED 4 out | D29
Panel Red LED | 3 | 1 | White-blue |  | < | StopLED | D30 | D12
C5 LED | 3 | 1 | 7-Green | Yellow | < | LED 5 out | D31
Panel Reverse LED | 3 | 1 | Blue-white |  | < | Reverse LED | D32 | D13
C6 LED | 3 | 1 | 7-Red | Brown | < | LED 6 out | D33
Joystick reserved | 3 | 5 |  | Brown | > | Reverse button | D34 | D00
C7 LED | 3 | 1 | 7-Black | Gray | < | LED 7 out | D35
C1 Reserved: Reverse Cmd | 3 | 3 |  |  | > | Cruise Reverse | D36 | D01
C8 LED | 3 | 1 | 7-White | white | < | LED 8 out | D37
reserved | 3 | 0 |  |  |  |  | D38
reserved | 3 | 0 |  |  |  |  | D39
reserved | 3 | 0 |  |  |  |  | D40
reserved | 3 | 0 |  |  |  |  | D41
reserved | 3 | 0 |  |  |  | Unused | D42-D53
C1 Ground | 3 | 0 | Black | Black |  | Ground | J3:7 (Ground)
Joystick Ground | 3 | 5 | Black | Black |  | Ground | J3:7 (Ground) |  | black
Battery to relay board | 12 | 4 | Black | Red | > | 36 V | Relay 4B |  | White
Motor control | 9 | 4 | Black | Red | < | 36 V | Relay 4C |  | White
C1 5V | 7 | 3 | Red | Pink | > | 5 V | Servo Brake
C4-8 5V | 8 | 3 |  | Pink | < | +5 V | Servo Steer
C1 LED | 3,6 | 1 | 1-Green | purple | > | LED 1 in
C3 LED | 3,6 | 1 | 1-Black | Blue | > | LED 3 in
C4 LED | 3,6 | 1 | 1-White | Green | > | LED 4 in
C5 LED | 3,6 | 1 | 2-Green | Yellow | > | LED 5 in
C6 LED | 3,6 | 1 | 2-Red | Brown | > | LED 6 in
C7 LED | 3,6 | 1 | 2-Black | Gray | > | LED 7 in
C8 LED | 3,6 | 1 | 2-White | white | > | LED 8 in
Motor control 36V throttle | 9 | 1 |  | Red | > | 36 V fuel
Panel On switch | 2 | 1 | Black | orange | > | 12 v power |  |  | Brown
Joystick 5V | 7 or 8 | 5 | Red | Pink | > | 5 V |  |  | red
Battery Ground |  | 2 | Black | Black |  | Ground |  |  | Green
C4-8 Ground | 8 | 2 |  | Black |  | Ground
Motor control Ground |  | 2 |  | Black |  | Ground |  |  | black
Motor control throttle Ground |  | 2 |  | Black |  | Ground
Unspecified |  | 0
Panel |  | 1
Power distribution |  | 2
Arduino |  | 3
Relay |  | 4
Joystick |  | 5
Higher level computers |  | 6
Brake controller |  | 7
Steer controller |  | 8
Motor controller |  | 9
Shield |  | 10
Filter |  | 11
Battery |  | 12

Sheet: Power
End 1 | Connector 1 | Wire color | Connector 2 | Signal | End 2
758 A signal | Molex | White-blue | Molex | Motor current | A00
758 B signal | Molex | Green-white | Molex | Steer current | A01
758 C signal | Molex | White-orange | Molex | Brake current | A02
Relay ground | Screw ground | Black thin | Soldered | Brake ground | Brake servo ground
To D07 | Green | Yellow | Soldered | Brake PWM signal | Brake servo signal
Battery ground | Black | Black | Ring | Fuse ground | Fuse ground post
Brake ground | Black | Black | Spade | Fuse 5A Brake | Fuse tab brake
Motor control ground | Black | Black | Spade | Fuse 2A Motor | Fuse tab motor
Battery 12 V | Orange | Black | Soldered | 12 V | Panel: power switch
Panel: Power switch acc | tab | White | Ring | Switched 12 V | Panel: Post 12 V
C1 and C3 5V | Pink |  | Ring | Brake 5V | Panel: Post 5 V
Joystick 5V | Pink | Red | Ring | Brake 5V | Panel: Post 5 V
C1 and C3 ground | Black | Black | Ring | Brake ground | Panel: Post ground
Joystick ground | Black | Black | Ring | Brake ground | Panel: Post ground
758 power | Soldered |  | Ring | Brake 5V | Post 1
Brake servo 5V | Soldered | Red thin | Ring | Brake 5V | Post 1
Panel: Post 5 V | Ring | Red | Ring | Brake 5V | Post 1
Relay: 1B, 2B | Soldered | 2 red thin | Ring | Brake 5V | Post 1
758 ground | Soldered | Black | Ring | Brake ground | Post 10
Brake servo ground | Soldered | Black thin | Ring | Brake ground | Post 10
Panel: Post ground | Ring | Black | Ring | Brake ground | Post 10
Fuse 5A steer | Soldered | Black | Ring | Steer ground | Post 2
Steer servo ground | Soldered | Black thin | Ring | Steer ground | Post 2
Battery 36 V | Red | Black | Ring | 36 V | Post 3
Relay: 4B | Screw 4B | Black | Ring | 36 V | Post 3
Relay 4C | Screw 4C | Black | Ring | Relay 36 V | Post 4
758 A out | Soldered | Black | Ring | Motor control 36 V | Post 4
758 A in | Soldered | Black | Ring | Relay 36 V | Post 5
Motor control 36 V | Red | Black | Ring | Motor control 36 V | Post 5
Steer servo 12 V | Soldered | Red thick | Ring | Steer 12 V | Post 6
758 C in | Soldered | Red | Ring | Switched 12 V | Post 6
758 C out | Soldered | Red | Ring | Steer 12 V | Post 8
Panel: Post 12 V | Ring | Green | Ring | Switched 12 V | Post 8
758 B out | Soldered | Red | Ring | Brake 12 V | Post 8
758 B in | Soldered | Red | Ring | Switched 12 V | Post 9
Brake servo 12 V | Soldered | Red thick | Ring | Brake 12 V | Post 9
Relay power | Screw 12 V | Green | Ring | Brake 12 V | Post 9
To D02 | Gray | Green | Screw 1C | Cruise RC-1 | Relay 1C
To D03 | White | White | Screw 2C | Stop RC-2 | Relay 2C
C4 … C8 5V | Pink | Red thin | Soldered | Steer 5V | Steer servo 5 V
C4 … C8 ground | Black | Black thin | Soldered | Steer ground | Steer servo ground
To D06 | Yellow | Yellow | Soldered | Steer PWM signal | Steer servo signal
