lanfuli/Localization/elcano-master/Documentation/Wiring_C2PCB.xls

Sheet: Internal
Current as of 4/16/16 |  |  | We no longer use the power distribution posts or the current sensors
 |  |  | Some other signals are no longer used.
Src | Dest | Connector | Dir | Signal | Mega | Notes
3 | 3 | (DAC) |  | Select CD | D49 | Select IC 3 DAC (channels C and D)
3 | 3 | (DAC) |  | (SS) Select AB | D53 | Select IC 2 DAC (channels A and B)
3 | 3 | (Rcvr 10) | > | Stop RC-2 | D18 Int 2 | A remote stop button generates an interrupt to stop the vehicle.
3 | 3 | (Rcvr 11) | > | Cruise RC-1 | D19 Int 3 | A remote cruise button starts enabled cruise systems.
3 | 1 | Black Anderson | - | Ground |  | Ground
3 | 3 | ICSP-1 |  | (MISO) | D50
 | 3 | ICSP-2 |  | 5V | 5V
 | 3 | ICSP-3 |  | (SCK) | D52
 | 3 | ICSP-4 |  | (MOSI) | D51
3 | 3 | ICSP-5 |  | Reset | Reset
3 | 3 | ICSP-6 |  | Ground | GND | Ground
3 | 1 | orange Anderson | > | 12 v power |  | Power goes to servo controllers, which produce the 5V to drive Arduino.
3 | 10 | Shield |  | Chip Select | D10 | Signals D10-13 are not brought out on connectors, and may be used by a shield.
3 | 10 | Shield |  | MOSI | D11 | “
3 | 10 | Shield |  | MISO | D12 | “
3 | 10 | Shield |  | CLK | D13 | “
3 | 0 | USB_Rx | > | Rx0; serial in | D00 (Rx0, D0 PWM) | Rx0 and Tx0 may be used by the monitor.
3 | 0 | USB_Tx | < | Tx0; serial out | D01 (Tx0, D1 PWM) | “
3 | 1 | X1-01 | < | LED 6 out | D33 | The LED outputs may display status information on the panel.
3 | 1 | X1-02 | < | LED 5 out | D31
3 | 1 | X1-03 | < | LED 4 out | D29
3 | 1 | X1-04 | < | LED 3 out | D27
3 | 1 | X1-05 | < | LED 1 out | D23
3 | 1 | X1-06 | > | EnableSteer | D22 | Panel switch: Whether steering can be autonomous.
3 | 1 | X1-07 | > | EnableBrake | D24 | Whether brakes can be autonomous.
3 | 1 | X1-08 | > | EnableThrottle | D26 | Whether the throttle can be autonomous.
3 | 1 | X1-09 | < | Cruise LED | D28 | Panel LED lights when under autonomous control.
3 | 1 | X1-10 | < | Stop LED | D30 | Panel LED lights when vehicle stop is commanded.
3 | 1 | X1-11 | < | Reverse LED | D32 | Vehicle is in reverse (not implemented)
3 | 1 | X1-12 | > | Reverse button | D34 | Button requesting reverse (not implemented)
3 | 1 | X1-13 | > | Cruise reverse | D36 | Autonomous request for reverse (not implemented)
9 | 1 | X1-14 | < | 36 V fuel | X3-8 | This is a 36V signal line that gives the state of the battery charge; used to drive LEDs.
3 | 1 | X1-15 | < | LED 7 out | D35
3 | 1 | X1-16 | < | LED 8 out | D37
3 | 1 | X1-17 | > | Cruise Button | D21 INT 5 | Panel cruise button starts enabled cruise systems
3 | 1 | X1-18 | > | Stop Button | D20 Int 4 | Panel stop button generates an interrupt to stop the vehicle.
3 | 1 | X1-19 |  | Available | D46 | Available for any digital input or output.
3 | 1 | X1-20 |  | Available | D44
3 | 1 | X1-21 |  | Available | D42
3 | 1 | X1-22 |  | Available | D40
3 | 1 | X1-23 |  | Available | D38
3 | 1 | X1-24 | > | 5 V from Steer | VCC | Main 5V supply. May be source or output.
3 | 1 | X1-25 | - | Ground | GND | Ground
3 | 6 | X2-01 | > | LED 6 in | X1-01 | Input for panel LEDs may come from off-board.
3 | 6 | X2-02 | > | LED 5 in | X1-02
3 | 6 | X2-03 | > | LED 4 in | X1-03
3 | 6 | X2-04 | > | LED 3 in | X1-04
3 | 6 | X2-05 | > | LED 1 in | X1-05
3 | 6 | X2-06 | > | Cruise Steer | A13 | Position of steering commanded by AI
3 | 6 | X2-07 | > | Cruise Brake | A14 | Position of brake commanded by AI
3 | 6 | X2-08 | > | Cruise Throttle | A15 | Position of throttle commanded by AI
3 | 6 | X2-09 | > | Speed Limit | A08 | Desired speed on this segment (not implemented).
3 | 6 | X2-10 | > | Speed | A12 | Actual speed (not implemented).
3 | 6 | X2-11 |  | Available | D41
3 | 6 | X2-12 |  | Available | D39
3 | 6 | X2-13 | > | Cruise Reverse | D36 | Reverse is commanded by AI (not implemented).
3 | 6 | X2-14 | < | Extra wireless | WLX / D0 | Jumper determines if this pin goes to D0 or unassigned wireless button.
3 | 6 | X2-15 | > | LED 7 in | X1-14
3 | 6 | X2-16 | > | LED 8 in | X1-15
3 | 6 | X2-17 | < | Move OK | D04 | Acknowledgement of receiving and executing move command (not implemented).
3 | 6 | X2-18 | > | Cruise Drive Cmd | D15 Rx3 | Message in Gamebots format giving wheel spin rate and steering angle.
3 | 6 | X2-19 |  | C2 Status | D14 TX3 | Feedback signal to AI with actual motion.
3 | 6 | X2-20 |  | Video in | D17 Rx2
3 | 6 | X2-21 | > | Wheel Rotation | D03 Int 1 | Reed switch generates one pulse per rotation.
3 | 6 | X2-22 |  | Video out | D16 Tx2
3 | 6 | X2-23 | > | Available | A06
7 | 6 | X2-24 | > | Secondary 5 V from Brake | X5-6 | May be used as power supply for AI.
3 | 6 | X2-25 | - | Ground | GND | Ground
1 | 9 | X3-01 | > | 36 V fuel | X1-25 | A 36V analog signal indicating battery charge; used to drive LEDs.
3 | 5 | X3-02 | > | SteerJoystick | A10 | Joystick left-right motion is for turning.
3 | 5 | X3-03 | > | JoystickCenter | A09 | This should be about 2.5V (128 counts) and is the joystick center. It is not important, since software uses a deadband.
3 | 9 | X3-04 | < | Reverse | D25 | REV_SW: Whether throttle drives trike forward (Low) or reverse (High)
3 | 9 | X3-05 |  | Regen brake | D43 | BRK_SW: Regenerative braking on/off
3 | 9 | X3-06 | < | Wireless Estop | D47/WLES | Remote request to turn off 36V power and stop the vehicle.
3 | 9 | X3-07 | > | Motor current | A00 | Indicates how much 36V current is being drawn.
3 | 5 | X3-08 | > | MotionJoystick | A11 | Joystick up motion is throttle; down motion is brake.
3 | 5 | X3-09 | > | Reverse button | D34 | Not implemented.
3 | 9 | X3-10 | > | ~Estop | D48 | This is the 5V supply produced by the E-bike controller. If it goes away, 36V power has been turned off (presumably by the rider's key switch).
3 | 9 | X3-11 | - | Ground | GND | Ground
3 | 9 | X3-12 | < | Analog Throttle | DACA | Motor throttle from the DAC.
3 | 9 | X3-13 | < | Analog Brake | DACB | BRK_AN: Amount of regenerative braking from the DAC
3 | 9 | X3-14 | > | Motor feedback | D02 Int 0 | A Hall signal from hub whose width is proportional to speed.
3 | 9 | X3-15 | < | WDPet | D05 PWM) | Stroke the watchdog. If pulse does not come in 250 ms, electronics applies e-stop
3 | 8 | X4-1 | - | Ground | GND | Ground
3 | 8 | X4-2 |  | Available | D08
3 | 8 | X4-3 | < | Analog C | DACC | A spare analog output from the DAC.
3 | 8 | X4-4 |  | Available | D45
3 | 8 | X4-5 | > | Available | A07
3 | 8 | X4-6 | > | Steer current | A04 | Current sensor (not implemented)
3 | 8 | X4-7 | > | Steer Feedback | A05 | Blue wire from servo gives servo position.
3 | 8 | X4-8 | > | 5 V from Steer | 5V | Servo produces 5V, used by MegaShieldDB
3 | 8 | X4-9 | < | Steer | D06 | PWM signal to turn vehicle
3 | 7 | X5-1 | - | Ground | GND | Ground
3 | 7 | X5-2 |  | Alternate Steer | D09 | Steer on #2
3 | 7 | X5-3 | < | Alternate Analog Throttle | DACD | Motor control on #2
3 | 7 | X5-4 |  | Ebrake | D47 | Remote request to e-stop the vehicle.
3 | 7 | X5-5 | > | Available | A03
3 | 7 | X5-6 | > | Brake Current | A02 | Current sensor (not implemented)
3 | 7 | X5-7 | > | Brake Feedback | A01 | Blue wire from servo gives servo position.
6 | 7 | X5-8 | > | Secondary 5 V from Brake | 5V | Servo produces 5V, routed to X2-24
3 | 7 | X5-9 | < | DiskBrake | D07 | PWM signal to apply brake
 |  |  |  | RC channel | D02 Int 0
 |  |  |  | RC channel | D18 Int 2
 |  |  |  | RC channel | D19 Int 3
 |  |  |  | RC channel | D20 Int 4
 |  |  |  | RC channel | D21 INT 5
 | 0 |  |  | Unspecified
 | 1 |  |  | Panel
 | 3 |  |  | Arduino
 | 5 |  |  | Joystick
 | 6 |  |  | Higher level computers
 | 7 |  |  | Brake controller
 | 8 |  |  | Steer controller
 | 9 |  |  | Motor controller
 | 10 |  |  | Shield
 | 12 |  |  | Battery

Sheet: Power
End 1 | Connector 1 | Wire color | Connector 2 | Signal | End 2
758 A signal | Molex | White-blue | Molex | Motor current | A00
758 B signal | Molex | Green-white | Molex | Steer current | A01
758 C signal | Molex | White-orange | Molex | Brake current | A02
Relay ground | Screw ground | Black thin | Soldered | Brake ground | Brake servo ground
To D07 | Green | Yellow | Soldered | Brake PWM signal | Brake servo signal
Battery ground | Black | Black | Ring | Fuse ground | Fuse ground post
Brake ground | Black | Black | Spade | Fuse 5A Brake | Fuse tab brake
Motor control ground | Black | Black | Spade | Fuse 2A Motor | Fuse tab motor
Battery 12 V | Orange | Black | Soldered | 12 V | Panel: power switch
Panel: Power switch acc | tab | White | Ring | Switched 12 V | Panel: Post 12 V
C1 and C3 5V | Pink |  | Ring | Brake 5V | Panel: Post 5 V
Joystick 5V | Pink | Red | Ring | Brake 5V | Panel: Post 5 V
C1 and C3 ground | Black | Black | Ring | Brake ground | Panel: Post ground
Joystick ground | Black | Black | Ring | Brake ground | Panel: Post ground
758 power | Soldered |  | Ring | Brake 5V | Post 1
Brake servo 5V | Soldered | Red thin | Ring | Brake 5V | Post 1
Panel: Post 5 V | Ring | Red | Ring | Brake 5V | Post 1
Relay: 1B, 2B | Soldered | 2 red thin | Ring | Brake 5V | Post 1
758 ground | Soldered | Black | Ring | Brake ground | Post 10
Brake servo ground | Soldered | Black thin | Ring | Brake ground | Post 10
Panel: Post ground | Ring | Black | Ring | Brake ground | Post 10
Fuse 5A steer | Soldered | Black | Ring | Steer ground | Post 2
Steer servo ground | Soldered | Black thin | Ring | Steer ground | Post 2
Battery 36 V | Red | Black | Ring | 36 V | Post 3
Relay: 4B | Screw 4B | Black | Ring | 36 V | Post 3
Relay 4C | Screw 4C | Black | Ring | Relay 36 V | Post 4
758 A out | Soldered | Black | Ring | Motor control 36 V | Post 4
758 A in | Soldered | Black | Ring | Relay 36 V | Post 5
Motor control 36 V | Red | Black | Ring | Motor control 36 V | Post 5
Steer servo 12 V | Soldered | Red thick | Ring | Steer 12 V | Post 6
758 C in | Soldered | Red | Ring | Switched 12 V | Post 6
758 C out | Soldered | Red | Ring | Steer 12 V | Post 8
Panel: Post 12 V | Ring | Green | Ring | Switched 12 V | Post 8
758 B out | Soldered | Red | Ring | Brake 12 V | Post 8
758 B in | Soldered | Red | Ring | Switched 12 V | Post 9
Brake servo 12 V | Soldered | Red thick | Ring | Brake 12 V | Post 9
Relay power | Screw 12 V | Green | Ring | Brake 12 V | Post 9
To D02 | Gray | Green | Screw 1C | Cruise RC-1 | Relay 1C
To D03 | White | White | Screw 2C | Stop RC-2 | Relay 2C
C4 … C8 5V | Pink | Red thin | Soldered | Steer 5V | Steer servo 5 V
C4 … C8 ground | Black | Black thin | Soldered | Steer ground | Steer servo ground
To D06 | Yellow | Yellow | Soldered | Steer PWM signal | Steer servo signal
