lanfuli/Localization/elcano-master/Documentation/Wiring_C5.xls

Src/Dest | Sonar Wire color | Arduino Wire color | Dir | Signal | Arduino
F-3 | Green | Yellow | > | Analog range | A00
FL-3 | Green | Orange | > | Analog range | A01
FR-3 | Green | Red | > | Analog range | A02
 |  |  |  |  | A03
 |  |  |  |  | A04
 |  |  |  |  | A05
Serial Monitor in |  |  | > | Rx0; serial in | D00 (Rx0, PWM)
Serial Monitor out |  |  | < | Tx0; serial out | D01 (Tx0, PWM)
 |  |  |  |  | D02 Int 0
 |  |  |  |  | D03 Int 1
 |  |  |  |  | D04
 |  |  |  |  | D05 PWM)
 |  |  |  |  | D06 PWM)
 |  |  |  |  | D07 PWM)
 |  |  |  |  | D08
 |  |  |  |  | D09
Shield |  |  |  | Chip Select | D10
Shield |  |  |  | MOSI | D11
Shield |  |  |  | MISO | D12
Shield |  |  |  | CLK | D13
 |  | (none) |  |  | P0 Reset
 |  | (none) |  |  | P1 3V3
F-1 | Orange | Black | < | Select Tx / chaining | P2 5V
F-4 | Blue | Black | < | Enable ranging | P2 5V
F-6 | Gray | Black | < | Vcc | P2 5V
FL-1 | Orange | Black | < | Select Tx / chaining | P2 5V
FL-4 | Blue | Black | < | Enable ranging | P2 5V
FL-6 | Gray | Black | < | Vcc | P2 5V
FR-1 | Orange | Black | < | Select Tx / chaining | P2 5V
FR-4 | Blue | Black | < | Enable ranging | P2 5V
FR-6 | Gray | Black | < | Vcc | P2 5V
F-7 | Black | Gray |  | Ground | P3 Gnd
FL-7 | Black | Gray |  | Ground | P3 Gnd
FR-7 | Black | Gray |  | Ground | P3 Gnd
(none) | (none) | Brown |  |  | P4 Gnd
(none) | (none) | Blue |  |  | P5 Vin
(none) | (none) | Green |  |  | P6 (none)
F-0 | Red | (none) |  | (none)
F-2 | Yellow | (none) | > | Pulse width
F-5 | Brown | (none) | > | Tx serial out
FL-0 | Red | (none) |  | (none)
FL-2 | Yellow | (none) | > | Pulse width
FL-5 | Brown | (none) | > | Tx serial out
FR-0 | Red | (none) |  | (none)
FR-2 | Yellow | (none) | > | Pulse width
FR-5 | Brown | (none) | > | Tx serial out
