lanfuli/Localization/elcano-master/Documentation/Wiring_C6Trio.xls

Sheet: C6 Navigator
Src/Dest | Dir | Signal | SGNL | Mega | C5
 |  | Front sonar range | F_RNG | A00
 |  | Front-left range | FL_RNG | A01
 |  | Front-right range | FR_RNG | A02
 |  | Left sonar range | L_RNG | A03
 |  | Right sonar range | R_RNG | A04
C2:7 | > | Cruise Brake | CRS_BRK | A05
C2:6 | > | Cruise Steer | CRS_STR | A06
C2:5 | > | Cruise Throttle | CRS_THR | A07
 |  | 2Front sonar range | F2RNG | A08
 |  | 2Front-left range | FL2RNG | A09
 |  | 2Front-right range | FR2RNG | A10
 |  | 2Left sonar range | L2RNG | A11
 |  | 2Right sonar range | R2RNG | A12
C3:A0 |  | Speed | SPEED | A13
C3:A1 |  | Spare | 4D5_6A14 | A14
 |  | Spare | 4D6_6A15 | A15
Serial Monitor in | > | Vision in | VIS_IN | D00 (Rx0, D0 PWM)
Serial Monitor out | < | Vision out | VIS_OUT | D01 (Tx0, D1 PWM)
Cylclometer | > | Odometer click | CLICK1 | D02 Int 0
 |  | Click2 | CLICK2 | D03 Int 1
C2:4;C3:12 | > | Move OK | MOV_OK | D04
 |  | Cruise Brake | CRS_BRK | D05 PWM)
 |  | Cruise Steer | CRS_STR | D06 PWM)
GPS J-11 2 |  | Spare | C6D7 | D07 PWM)
GPS J-11 5 |  | GPS LED1 | LED1 | D08
GPS J-11 6 |  | GPS Power | GPS_PWR | D09
Shield:D10 |  | Chip Select | C6D10 | D10
Shield:D11 |  | MOSI | MOSI | D11
Shield:D12 |  | MISO | MISO | D12
Shield:D13 |  | CLK | SCK | D13
GPS J-11 7, Rx | < | GPS control | GPS_CNTRL | D14 TX3
GPS J-11 8, Tx | > | GPS Location | GPS_LOC | D15 Rx3
C4:0 | < | Navigation Fix | NAV_FIX | D16 Tx2
C4:3 | > | C2 Status | C2STAT | D17 Rx2
INU:Rx | < | INU control | INU_CNTRL | D18 Int 2, Tx1
INU:Tx | > | INU Bearing | INU_BRN | D19 Int 3, Rx1
GPS J-11 3 |  | GPS_PPS | GPS_PPS | D20 Int 4
GPS J-11 4 |  | GPS LED2 | LED8 | D21 INT 5
 |  | LED7 | LED7 | D22
 |  | C6 Data Available | C6AVL | D23
 |  | LED6 | LED6 | D24
 |  | Vin | VIN | D25
 |  |  | DRV_CMD | D26, unused
 |  | INU Chip select | INU_SS | D27
 |  | Path | PATH | D28, unused
 |  | Spare | C6D29 | D29
 |  | Reset | RESET | D30, unused
 |  | Spare | C6D31 | D31
 |  |  | GND | D32, unused
 |  | Spare | C6D33 | D33
 |  | C4 Data available | C4AVL | D34
 |  | Spare | C6D35 | D35
 |  | Chaining 2 | CHN2 | D36
 |  | Spare | C6D37 | D37
 |  | Chaining 1 | CHN1 | D38
C2:D39 |  | Spare | D39 | D39
 |  | Cruise Brake | CRS_BRK | D40,D05
C2:D41 |  | Spare | D41 | D41
 |  | Cruise Steer | CRS_STR | D42,D06
 |  | Spare | 4D7_6D43 | D43
 |  | Power to sonar | PWR_SEL | D44
 |  | Cruise Throttle | CRS_THR | D45 (PWM)
 |  | Cruise Reverse | CRS_REV | D46
optical odometer |  | Mouse NPD | NPD | D47
 |  | Cruise Throttle | CRS_THR | D48,D45
optical odometer |  | Mouse LED | LED5 | D49 LED
optical odometer |  |  | MISO | D50 MISO
optical odometer |  |  | MOSI | D51 MOSI
optical odometer |  |  | SCK | D52 SCK
optical odometer |  | Mouse SS | MOUSE_SS | D53 SS
 |  |  |  | Vcc

Sheet: C7 Vision
Src/Dest | Wire color | Connector Color | Dir | Signal | Mega | Source pin
C4:9 |  |  | > | Expected horizontal | A00
C4:10 |  |  | > | Expected vertical | A01
C4:11 |  |  | > | Expected size | A02
 |  |  |  |  | A03
 |  |  |  |  | A04
 |  |  |  |  | A05
 |  |  |  |  | A06
 |  |  |  |  | A07
 |  |  |  |  | A08
 |  |  |  |  | A09
 |  |  |  |  | A10
 |  |  |  |  | A11
 |  |  |  |  | A12
 |  |  |  |  | A13
 |  |  |  |  | A14
 |  |  |  |  | A15
Web cam |  | USB | > | Camera | D00 (Rx0, D0 PWM)
Web cam |  | USB | < | Camera control | D01 (Tx0, D1 PWM)
 |  |  |  |  | D02 Int 0
 |  |  |  |  | D03 Int 1
C4:A0 |  |  | < | Horizontal | D04
C4:A1 |  |  | < | Vertical | D05 PWM)
C4:A2 |  |  | < | Size | D06 PWM)
C4:A3 |  |  | < | Coneness | D07 PWM)
 |  |  |  |  | D08
 |  |  |  |  | D09
 |  |  |  |  | D10
 |  |  |  |  | D11
 |  |  |  |  | D12
 |  |  |  |  | D13
 |  |  |  |  | D14 TX3
 |  |  |  |  | D15 Rx3
 |  |  |  |  | D16 Tx2
 |  |  |  |  | D17 Rx2
 |  |  |  |  | D18 Int 2
 |  |  |  |  | D19 Int 3
 |  |  |  |  | D20 Int 4
 |  |  |  |  | D21 INT 5
 |  |  |  |  | D22-D53
 |  |  |  |  | P0 Reset
 |  |  |  |  | P1 3V3
 |  |  |  |  | P2 5V
 |  |  |  |  | P3 Gnd
 |  |  |  |  | P4 Gnd
 |  |  |  |  | P5 Vin

Sheet: C4 Path
Src/Dest | Dir | Signal | SGNL | 2009 | Nano
C3:0 | < | Path | PATH | D01 J1:2 (Tx0) | L01
C6:16 | > | Navigation fix | NAV_FIX | D00 J1:1 (Rx0) | L02
 |  | Reset | RESET | RST | L03
 |  | Ground | GND | GND J3:7 | L04
C6:17 | > | C6 Data available | C6AVL | D02 J1:3 (INT0) | L05
C3:2 | < | C4 Data available | C4AVL | D03 J1:4 (INT1, PWM) | L06
 |  | Move OK | MOV_OK | D04 J1:5 | L07
 | < | Spare | 4D5_6A14 | D05 J1:6 (PWM) | L08
 | < | Spare | 4D6_6A15 | D06 J1:7 (PWM) | L09
 |  | Spare | 4D7_6D43 | D07 J1:8 | L10
 |  | Spare | D41 | D08 J3:1 | L11
 | < |  | SPD_LMT | D09 J3:2 (PWM) | L12
 |  | Spare | D39 | D10 J3:3 (PWM, SS) | L13
 |  |  |  | D11 J3:4 (PWM, MOSI) | L14
 |  |  |  | D12 J3:5 (MISO) | L15
 |  |  | VIN | VIN | R01
 |  | Ground | GND | GND | R02
 |  | Reset | RESET | RST | R03
 |  | 5 Volts | +5V | 5V | R04
F-3 | > | Front sonar range | F_RNG | A0 J2:1 | R05
FL-3 | > | Front-left range | FL_RNG | A1 J2:2 | R06
FR-3 | > | Front-right range | FR_RNG | A2 J2:3 | R07
 | > | Left sonar range | L_RNG | A3 J2:4 | R08
 | > | Right sonar range | R_RNG | A4 J2:5 | R09
 | > |  | F2RNG | A5 J2:6 | R10
 | > |  | L2RNG | A6 | R11
 | > |  | R2RNG | A7 | R12
 |  |  | AREF | AREF J3:8 | R13
 |  | 3.3 volts | 3.3V | 3.3V | R14
 |  |  | LED4 | D13 J3:6 (SCK, LED) | R15

Sheet: C5 Reverse
Src/Dest | Dir | Signal | SGNL | 2009 | Nano | MEGA
 | < |  | DRV_CMD | D01 J1:2 (Tx0) | L01 | D26, unused
C4:1 | > | Path | PATH | D00 J1:1 (Rx0) | L02 | D28, unused
 |  |  | RESET | RST | L03 | D30, unused
 |  |  | GND | GND J3:7 | L04 | D32, unused
C4:3 | > | C4 Data available | C4AVL | D02 J1:3 (INT0) | L05 | D34
 | < |  | CHN2 | D03 J1:4 (INT1, PWM) | L06 | D36
 | > | Chaining | CHN1 | D04 J1:5 | L07 | D38
C2:A10,C6:A10 | < | Cruise Brake | CRS_BRK | D05 J1:6 (PWM) | L08 | D40,D05
C2:A11,C6:A11 | < | Cruise Steer | CRS_STR | D06 J1:7 (PWM) | L09 | D42,D06
Relay | < | Power to sonar | PWR_SEL | D07 J1:8 | L10 | D44
 | < | Cruise Reverse | CRS_REV | D08 J3:1 | L11 | D46
C2:A9, C6:A9 | < | Cruise Throttle | CRS_THR | D09 J3:2 (PWM) | L12 | D48,D45
C2:4;C6:23 | > | Move OK | MOV_OK | D10 J3:3 (PWM, SS) | L13 | D50 (MISO)
 | < |  | SPEED | D11 J3:4 (PWM, MOSI) | L14 | D52 (SCK)
D41 |  | Spare | D41 | D12 J3:5 (MISO) | L15 | D54 (GND)
 |  |  | VIN | VIN | R01
 |  |  | GND | GND | R02
 |  |  | RESET | RST | R03
 |  |  | +5V | 5V | R04
 | > |  | F2RNG | A0 J2:1 | R05
 | > |  | FL2RNG | A1 J2:2 | R06
 | > |  | FR2RNG | A2 J2:3 | R07
 | > |  | L2RNG | A3 J2:4 | R08
 | > |  | R2RNG | A4 J2:5 | R09
 |  |  | F_RNG | A5 J2:6 | R10
 |  |  | L_RNG | A6 | R11
 |  |  | R_RNG | A7 | R12
 |  |  | AREF | AREF J3:8 | R13
 |  |  | 3.3V | 3.3V | R14
 |  |  | LED5 | D13 J3:6 (SCK, LED) | R15

Sheet: C3 Pilot
Src/Dest | Dir | Signal | SGNL | 2009 | Nano
 | < |  | DRV_CMD | D01 J1:2 (Tx0) | L01
C4:1 | > | Path | PATH | D00 J1:1 (Rx0) | L02
 |  |  | RESET | RST | L03
 |  |  | GND | GND J3:7 | L04
C4:3 | < | C4 Data available | C4AVL | D02 J1:3 (INT0) | L05
 | > |  | CHN2 | D03 J1:4 (INT1, PWM) | L06
 | < | Chaining | CHN1 | D04 J1:5 | L07
C2:A10,C6:A10 | < | Cruise Brake | CRS_BRK | D05 J1:6 (PWM) | L08
C2:A11,C6:A11 | < | Cruise Steer | CRS_STR | D06 J1:7 (PWM) | L09
Relay | < | Power to sonar | PWR_SEL | D07 J1:8 | L10
 | < | Cruise Reverse | CRS_REV | D08 J3:1 | L11
C2:A9, C6:A9 | < | Cruise Throttle | CRS_THR | D09 J3:2 (PWM) | L12
C2:4;C6:23 | > | Move OK | MOV_OK | D10 J3:3 (PWM, SS) | L13
 | < |  | SPEED | D11 J3:4 (PWM, MOSI) | L14
D39 |  | Spare | D39 | D12 J3:5 (MISO) | L15
 |  |  | VIN | VIN | R01
 |  |  | GND | GND | R02
 |  |  | RESET | RST | R03
 |  |  | +5V | 5V | R04
F-3 | > | Front sonar range | F_RNG | A0 J2:1 | R05
FL-3 | > | Front-left range | FL_RNG | A1 J2:2 | R06
FR-3 | > | Front-right range | FR_RNG | A2 J2:3 | R07
 | > | Left sonar range | L_RNG | A3 J2:4 | R08
 | > | Right sonar range | R_RNG | A4 J2:5 | R09
 | > |  | F2RNG | A5 J2:6 | R10
 | > |  | L2RNG | A6 | R11
 | > |  | R2RNG | A7 | R12
 |  |  | AREF | AREF J3:8 | R13
 |  |  | 3.3V | 3.3V | R14
 | < |  | LED3 | D13 J3:6 (SCK, LED) | R15
 |  |  |  | P0 Reset
 |  |  |  | P1 3V3
F-1 | < | Select Tx / chaining |  | P2 5V
F-4 | < | Enable ranging |  | P2 5V
F-6 | < | Vcc |  | P2 5V
FL-1 | < | Select Tx / chaining |  | P2 5V
FL-4 | < | Enable ranging |  | P2 5V
FL-6 | < | Vcc |  | P2 5V
FR-1 | < | Select Tx / chaining |  | P2 5V
FR-4 | < | Enable ranging |  | P2 5V
FR-6 | < | Vcc |  | P2 5V
F-7 |  | Ground |  | P3 Gnd
FL-7 |  | Ground |  | P3 Gnd
FR-7 |  | Ground |  | P3 Gnd
(none) |  |  |  | P4 Gnd
(none) |  |  |  | P5 Vin
(none) |  |  |  | P6 (none)
F-0 |  | (none)
F-2 | > | Pulse width
F-5 | > | Tx serial out
FL-0 |  | (none)
FL-2 | > | Pulse width
FL-5 | > | Tx serial out
FR-0 |  | (none)
FR-2 | > | Pulse width
FR-5 | > | Tx serial out
