lanfuli/Localization/elcano-master/Electronics/C1_Interface.brd

## EAGLE design elcano-master/Electronics/C1_Interface.brd (2016-07-03)

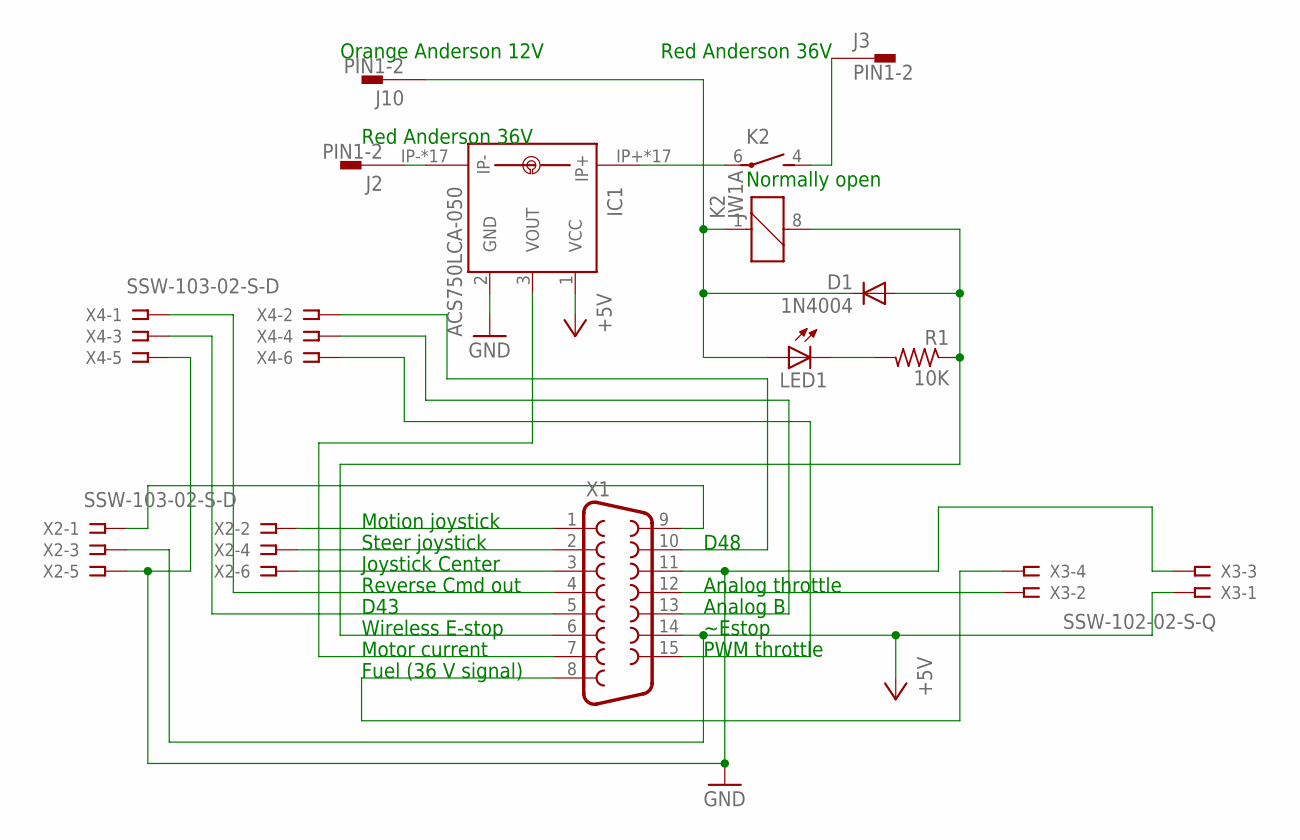
[picture p55: schematic C1_Interface.sch]

Parts:
D1: 1N4004; DO41-10
IC1: ACS750LCA-050; ACS75050
J2, J3, J10: PIN1-2; 62221
K2: JW1A
LED1: LED3MM
R1: 10K; 0204/5
X1: F15H
X2, X4: SSW-103-02-S-D
X3: SSW-102-02-S-Q

Connections:
+5V: IC1.1 (VCC), X1.14, X2.3, X3.1
GND: IC1.2 (GND), X1.11, X2.5, X3.3, X4.5
unnamed: D1.C, J10.1, K2.1, LED1.A
unnamed: X1.4, X4.1
unnamed: IC1.3 (VOUT), X1.7
unnamed: LED1.K (C), R1.2
unnamed: X1.8, X3.4
unnamed: J3.1, K2.4 (S)
unnamed: X1.10, X4.2
unnamed: X1.5, X4.3
unnamed: X1.13, X4.4
unnamed: D1.A, K2.8 (2), R1.1, X1.6
unnamed: X1.1, X2.2
unnamed: IC1.IP-, IC1.IP-@2 (IP-), IC1.IP-@3 (IP-), IC1.IP-@4 (IP-), IC1.IP-@5 (IP-), IC1.IP-@6 (IP-), IC1.IP-@7 (IP-), IC1.IP-@8 (IP-), IC1.IP-@9 (IP-), IC1.IP-@10 (IP-), IC1.IP-@11 (IP-), IC1.IP-@12 (IP-), IC1.IP-@13 (IP-), IC1.IP-@14 (IP-), IC1.IP-@15 (IP-), IC1.IP-@16 (IP-), IC1.IP-@17 (IP-), J2.1
unnamed: X1.2, X2.4
unnamed: X1.3, X2.6
unnamed: X1.9, X2.1
unnamed: X1.12, X3.2
unnamed: X1.15, X4.6
unnamed: IC1.IP+, IC1.IP+@2 (IP+), IC1.IP+@3 (IP+), IC1.IP+@4 (IP+), IC1.IP+@5 (IP+), IC1.IP+@6 (IP+), IC1.IP+@7 (IP+), IC1.IP+@8 (IP+), IC1.IP+@9 (IP+), IC1.IP+@10 (IP+), IC1.IP+@11 (IP+), IC1.IP+@12 (IP+), IC1.IP+@13 (IP+), IC1.IP+@14 (IP+), IC1.IP+@15 (IP+), IC1.IP+@16 (IP+), IC1.IP+@17 (IP+), K2.6

Notes on the sheet:
Motion joystick
Steer joystick
Joystick Center
Reverse Cmd out
D43
Wireless E-stop
Motor current
Fuel (36 V signal)
D48
Analog throttle
Analog B
~Estop
PWM throttle
Red Anderson 36V
Normally open
Orange Anderson 12V

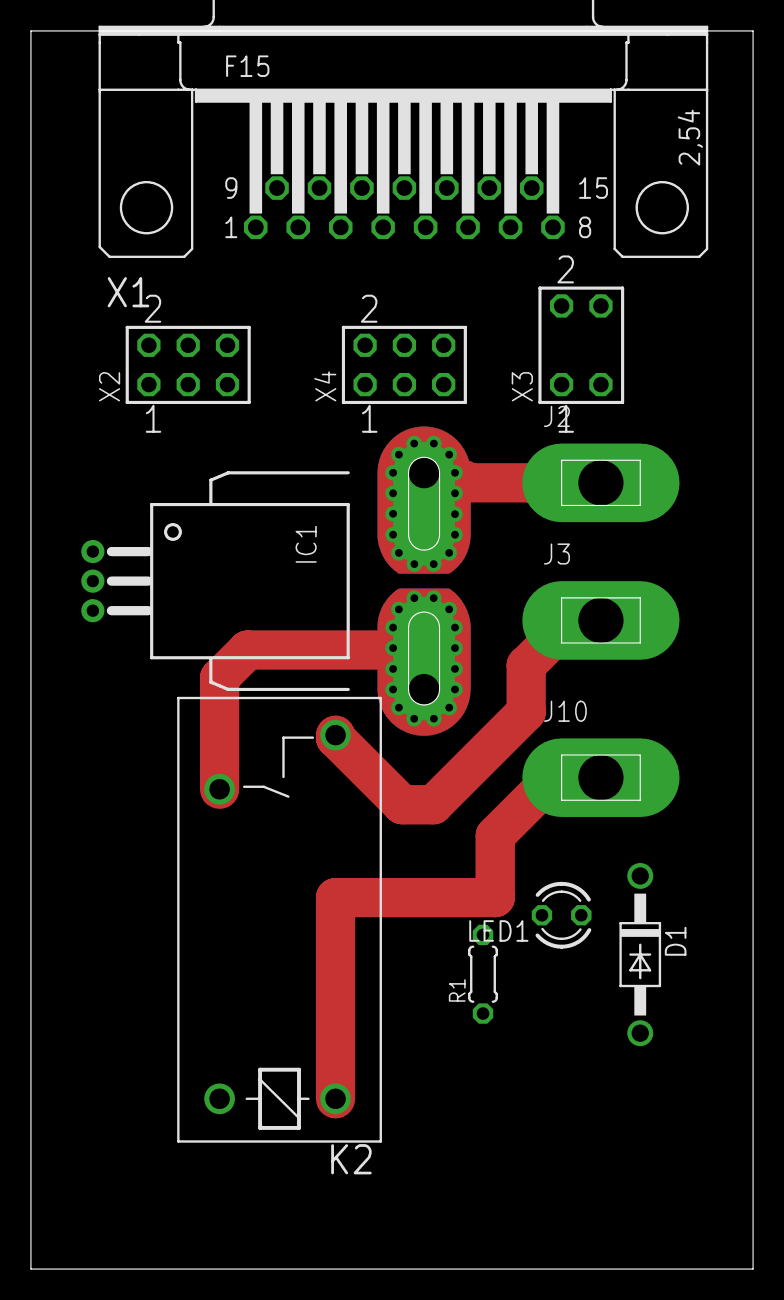
[picture p56: board C1_Interface.brd from above]

Board: 2 copper layers, 46.7 x 80.0 mm, 12 parts (0 on the bottom side), 20 nets.
