lanfuli/Localization/elcano-master/Electronics/MegaShieldDB.brd

## EAGLE design elcano-master/Electronics/MegaShieldDB.brd (2016-07-03)

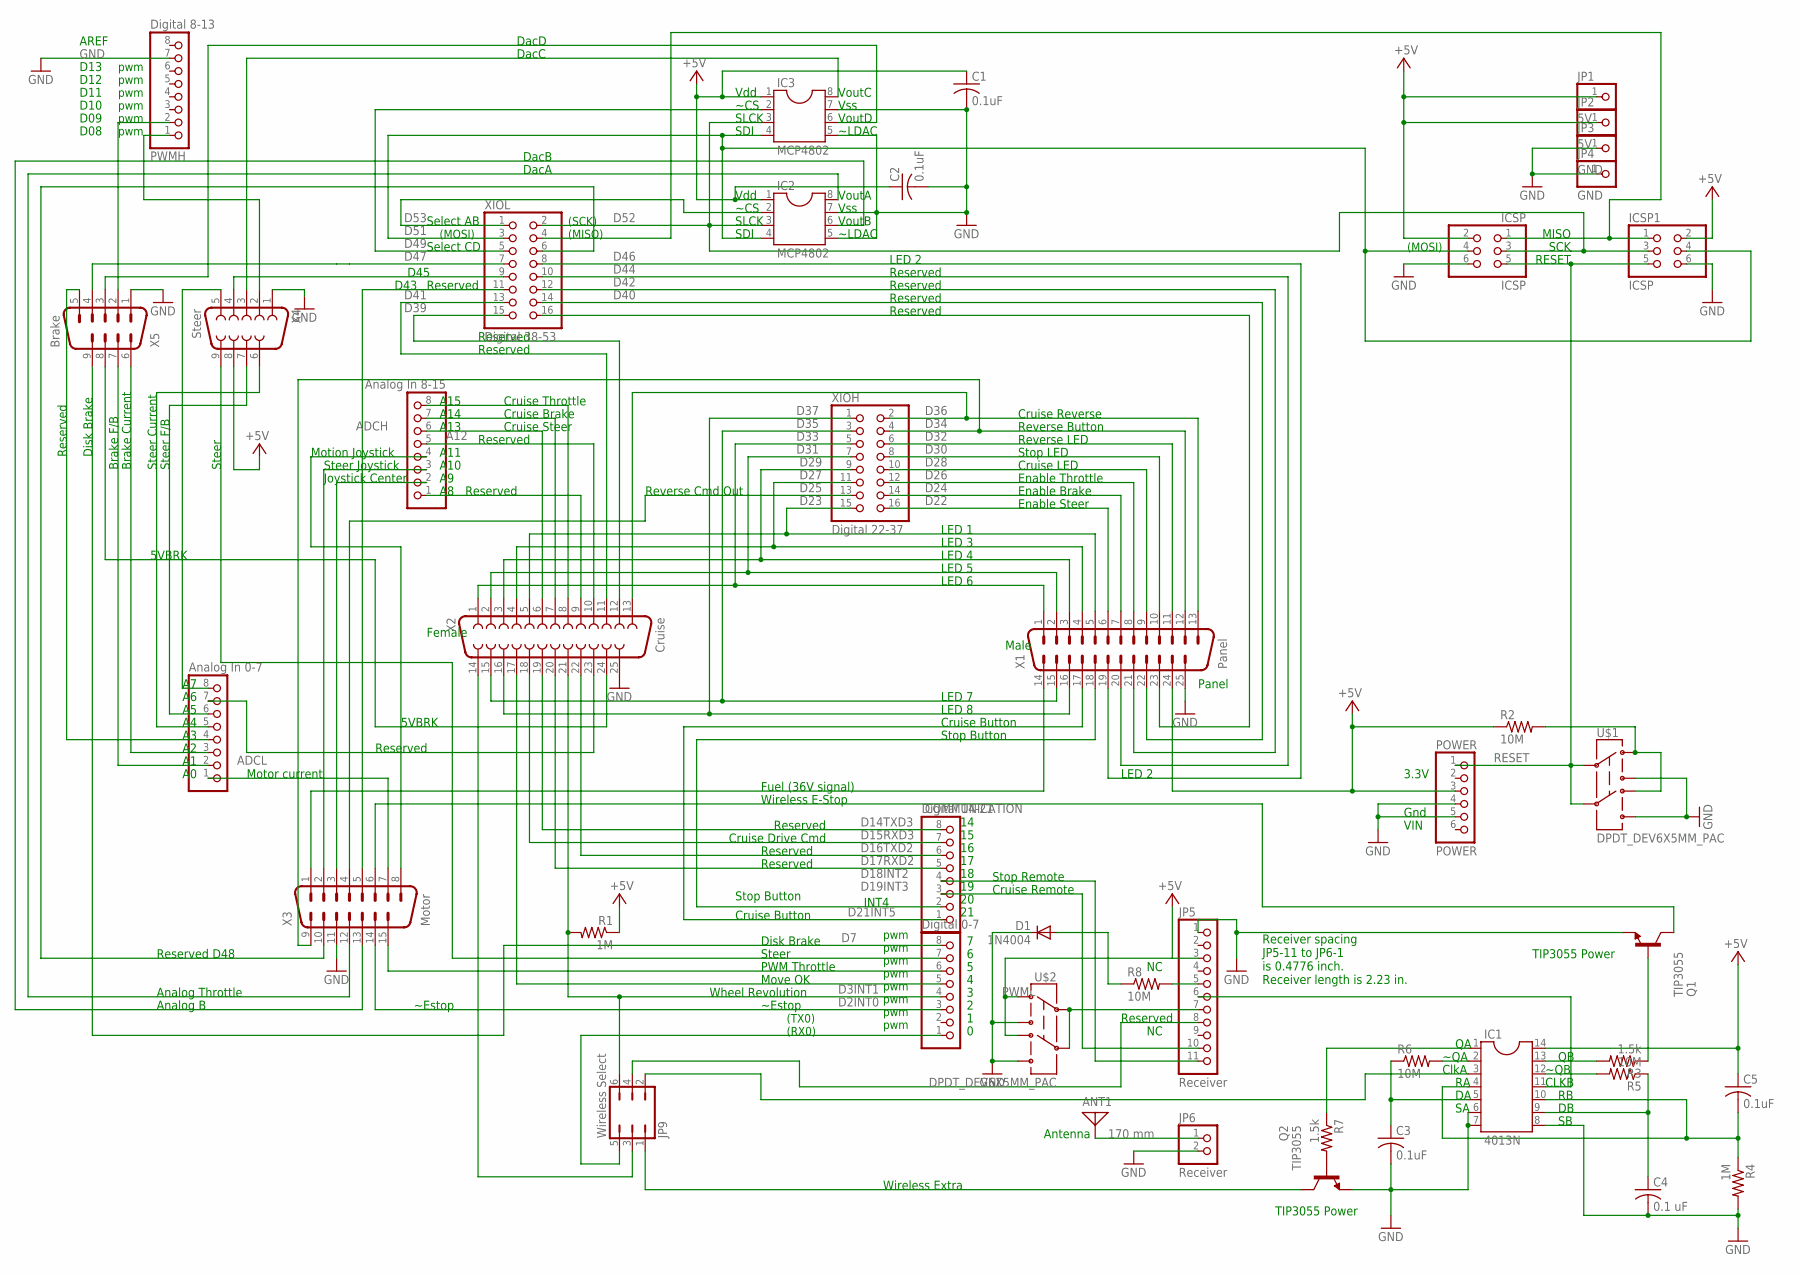
[picture p57: schematic MegaShieldDB.sch]

Parts:
ADCH: Analog In 8-15; 1X08
ADCL: Analog In 0-7; 1X08
ANT1: 170 mm; PAD-01
C1, C2, C3, C5: 0.1uF; C025-025X050
C4: 0.1 uF; C025-025X050
COMMUNICATION: Digital 14-21; 1X08
D1: 1N4004; DO41-10
IC1: 4013N; DIL14
IC2, IC3: MCP4802; DIL08
ICSP, ICSP1: ICSP; 2X03
JP1, JP2: 5V; 1X01
JP3, JP4: GND; 1X01
JP5: Receiver; 1X11
JP6: Receiver; 1X02
JP9: Wireless Select; JP3Q
POWER: POWER; 1X06
PWMH: Digital 8-13; 1X08
PWML: Digital 0-7; 1X08
Q1, Q2: TIP3055; TO220
R1, R4: 1M; 0204/5
R2, R5, R6, R8: 10M; 0204/5
R3, R7: 1.5k; 0204/5
U$1, U$2: DPDT_DEV6X5MM_PAC; NEWSWITCH2_PAC
X1: Panel; M25-HD-20
X2: Cruise; F25H
X3: Motor; 182-015-MALE
X4: Steer; F09H
X5: Brake; 182-009-MALE
XIOH: Digital 22-37; 2X08
XIOL: Digital 38-53; 2X08

Connections:
5VBRK: X2.24, X5.8
+5V: C1.1, C2.1, C5.1, IC1.14, IC2.1, IC3.1, ICSP.2, ICSP1.2, JP1.1, JP2.1, JP5.3, POWER.3, R1.1, R2.1, U$2.PIN1 (1), U$2.PIN4 (4), X1.24, X4.8
A0: ADCL.1, X3.7
A1: ADCL.2, X5.7
A4: ADCL.5, X4.6
A5: ADCL.6, X4.7
A6: ADCL.7, X2.23
A7: ADCL.8, X4.5
A9: ADCH.2, X3.3
A10: ADCH.3, X3.2
A11: ADCH.4, X3.8
A12: ADCH.5, X2.10
A13: ADCH.6, X2.6
A14: ADCH.7, X2.7
A15: ADCH.8, X2.8
CLKA: IC1.3, JP9.2
CLKB: IC1.11, JP5.6
D0RX0: JP9.5, PWML.1
D2INT0: PWML.3, X3.14
D3INT1: JP9.6, PWML.4, R1.2, X2.21
D4: PWML.5, X2.17
D5: PWML.6, X3.15
D6: PWML.7, X4.9
D7: PWML.8, X5.9
D8: PWMH.1, X4.2
D9: PWMH.2, X5.2
D14TXD3: COMMUNICATION.8, X2.19
D15RXD3: COMMUNICATION.7, X2.18
D16TXD2: COMMUNICATION.6, X2.22
D17RXD2: COMMUNICATION.5, X2.20
D18INT2: COMMUNICATION.4, JP5.11
D19INT3: COMMUNICATION.3, JP5.10
D20INT4: COMMUNICATION.2, X1.18
D21INT5: COMMUNICATION.1, X1.17
D22: X1.6, XIOH.16
D23: X1.5, X2.5, XIOH.15
D24: X1.7, XIOH.14
D25: X3.4, XIOH.13
D26: X1.8, XIOH.12
D27: X1.4, X2.4, XIOH.11
D28: X1.9, XIOH.10
D29: X1.3, X2.3, XIOH.9
D30: X1.10, XIOH.8
D31: X1.2, X2.2, XIOH.7
D32: X1.11, XIOH.6
D33: X1.1, X2.1, XIOH.5
D34: X1.12, X3.9, XIOH.4
D35: X1.15, X2.15, XIOH.3
D36: X1.13, X2.13, XIOH.2
D37: X1.16, X2.16, XIOH.1
D38: X1.23, XIOL.16
D39: X2.12, XIOL.15
D40: X1.22, XIOL.14
D41: X2.11, XIOL.13
D42: X1.21, XIOL.12
D43: X3.5, XIOL.11
D44: X1.20, XIOL.10
D45: X4.4, XIOL.9
D46: X1.19, XIOL.8
D47: X5.4, XIOL.7
D48: X3.10, XIOL.6
D49: IC3.2, XIOL.5
D51: IC2.4, IC3.4, ICSP.4, ICSP1.4, XIOL.3
D52: IC2.3, IC3.3, ICSP.3, ICSP1.3, XIOL.2
D53: IC2.2, XIOL.1
DA: C3.1, IC1.5, R6.1
DACA: IC2.8, X3.12
DACB: IC2.6, X3.13
DACC: IC3.8, X4.3
DACD: IC3.6, X5.3
DB: C4.1, IC1.9, R5.1
FUEL: X1.14, X3.1
GND: C1.2, C2.2, C3.2, C4.2, D1.C, IC1.6, IC1.7, IC1.8, IC2.5, IC2.7, IC3.5, IC3.7, ICSP.6, ICSP1.6, JP3.1, JP4.1, JP5.1, JP6.2, POWER.4, POWER.5, PWMH.7, Q1.3 (E), Q2.3 (E), R4.2, U$1.PIN3 (3), U$1.PIN6 (6), U$2.PIN3 (3), U$2.PIN6 (6), X1.25, X2.25, X3.11, X4.1, X5.1
unnamed: ADCL.3, X5.6
unnamed: IC1.1, R7.1
unnamed: Q2.1 (B), R7.2
unnamed: IC1.13, R3.2
unnamed: ADCH.1, X2.9
unnamed: R2.2, U$1.PIN1 (1), U$1.PIN4 (4)
unnamed: IC1.2, R6.2
unnamed: ADCL.4, X5.5
unnamed: ICSP.1, ICSP1.1, XIOL.4
unnamed: ANT1.1, JP6.1
unnamed: JP5.7, U$2.PIN2 (2), U$2.PIN5 (5)
unnamed: Q1.1 (B), R3.1
unnamed: D1.A, R8.1
RA: C5.2, IC1.4, IC1.10, R4.1
RCVR5: JP5.5, R8.2
RESET: ICSP.5, ICSP1.5, POWER.1, U$1.PIN2 (2), U$1.PIN5 (5)
WL2: JP5.8, JP9.4
WLES: Q1.2 (C), X3.6
WLXCOLL: JP9.1, Q2.2 (C)
X2-14: JP9.3, X2.14
~QB: IC1.12, R5.2

Notes on the sheet:
(MOSI)
pwm
(TX0)
(RX0)
(SCK)
(MISO)
Brake F/B
Joystick Center
Steer Joystick
Motion Joystick
Steer F/B
Cruise Brake
Cruise Throttle
Cruise Steer
~Estop
Move OK
Steer
Disk Brake
Cruise Button
Stop Button
Cruise Remote
Stop Remote
Enable Steer
LED 1
Enable Brake
Enable Throttle
Cruise LED
Stop LED
Reverse LED
Reverse Button
Cruise Reverse
Reverse Cmd Out
LED 3
LED 4
LED 5
LED 6
LED 7
LED 8
Gnd
Cruise Drive Cmd
Wireless E-Stop
Panel
Brake Current
Steer Current
Reserved
Antenna
Male
Female
A10
A11
A13
A14
A15
INT4
Vdd
~CS
SLCK
VoutA
Vss
VoutB
~LDAC
VoutC
VoutD
Select AB
Select CD
PWM Throttle
Reserved D48
Analog B
Analog Throttle
SDI
DacC
DacD
DacA
DacB
Wireless Extra
5VBRK
Fuel (36V signal)
Motor current
D45
D43
3.3V
D10
D11
D12
D13
D09
D08
AREF
~QA
ClkA
~QB
CLKB
MISO
SCK
RESET
VIN
Receiver spacing JP5-11 to JP6-1 is 0.4776 inch. Receiver length is 2.23 in.
Wheel Revolution
TIP3055 Power
LED 2

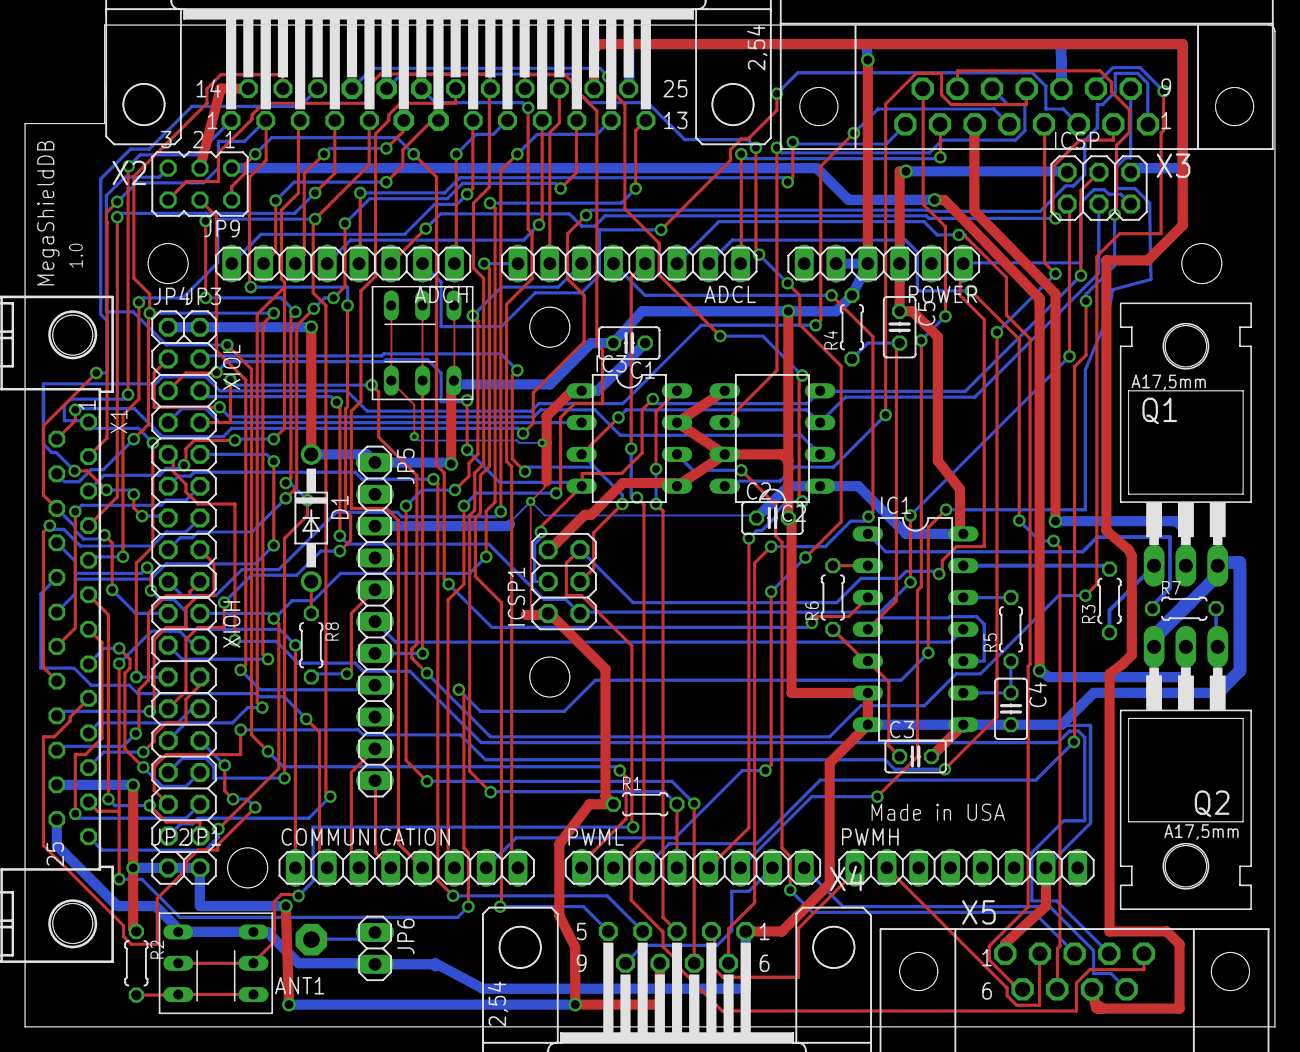
[picture p58: board MegaShieldDB.brd from above]

Board: 2 copper layers, 99.8 x 80.0 mm, 44 parts (0 on the bottom side), 94 nets.
