lanfuli/Localization/elcano-master/Electronics/RC_shieldV2.brd

## EAGLE design elcano-master/Electronics/RC_shieldV2.brd (2016-07-03)

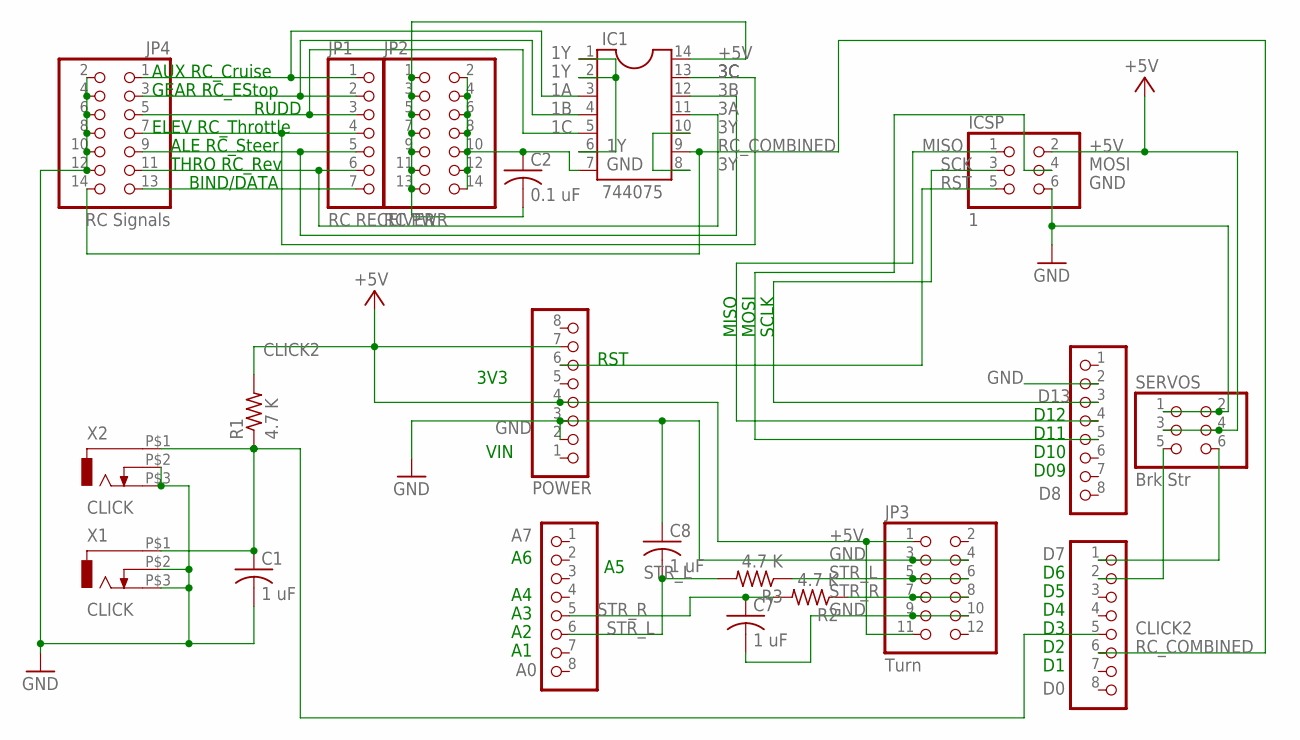
[picture p59: schematic RC_shieldV2.sch]

Parts:
A0: A7; 1X08
C1, C7, C8: 1 uF; C025-030X050
C2: 0.1 uF; C025-030X050
D0: D7; 1X08
D8: D13; 1X08
IC1: 744075; DIL14
ICSP: 1; 2X03
JP1: RC RECEIVER; 1X07
JP2: RC PWR; 2X07
JP3: Turn; 2X06
JP4: RC Signals; 2X07
POWER: GND; 1X08
R1, R2, R3: 4.7 K; 0207/10
SERVOS: Brk Str; 2X03
X1, X2: CLICK; ODO_JACK

Connections:
1A: IC1.3, JP1.1, JP4.1
1B: IC1.4, JP1.2, JP4.3
1C: IC1.5, JP1.3, JP4.5
1Y: IC1.1, IC1.2, IC1.6
3A: IC1.11, JP1.6, JP4.11
3B: IC1.12, JP1.5, JP4.9
3C: IC1.13, JP1.4, JP4.7
3Y: IC1.8, IC1.10
+5V: C2.2, IC1.14, ICSP.2, JP2.1, JP2.3, JP2.5, JP2.7, JP2.9, JP2.11, JP2.13, JP3.1, JP3.11, POWER.4, POWER.7, R1.2, SERVOS.3, SERVOS.4
CLICK2: C1.1, D0.5, R1.1, X1.P$1 (1), X2.P$1 (1)
GND: C1.2, C2.1, C7.2, C8.1, D8.2, IC1.7, ICSP.6, JP2.2, JP2.4, JP2.6, JP2.8, JP2.10, JP2.12, JP2.14, JP3.3, JP3.4, JP3.9, JP3.10, JP4.2, JP4.4, JP4.6, JP4.8, JP4.10, JP4.12, POWER.2, POWER.3, SERVOS.1, SERVOS.2, X1.P$2 (2), X1.P$3 (3), X2.P$2 (2), X2.P$3 (3)
MISO: D8.4, ICSP.1
MOSI: D8.5, ICSP.4
unnamed: JP3.7, JP3.8, R2.1
unnamed: JP3.5, JP3.6, R3.1
unnamed: JP1.7, JP4.13
unnamed: D0.2, SERVOS.5
unnamed: D0.1, SERVOS.6
RC_COMBINED: D0.6, IC1.9, JP4.14
RST: ICSP.5, POWER.6
SCK: D8.3, ICSP.3
STR_L: A0.6, C8.2, R3.2
STR_R: A0.5, C7.1, R2.2

Notes on the sheet:
D10
D11
D12
D09
VIN
MISO
MOSI
SCLK
RST
3V3
AUX RC_Cruise
GEAR RC_EStop
RUDD
ELEV RC_Throttle
ALE RC_Steer
THRO RC_Rev
BIND/DATA

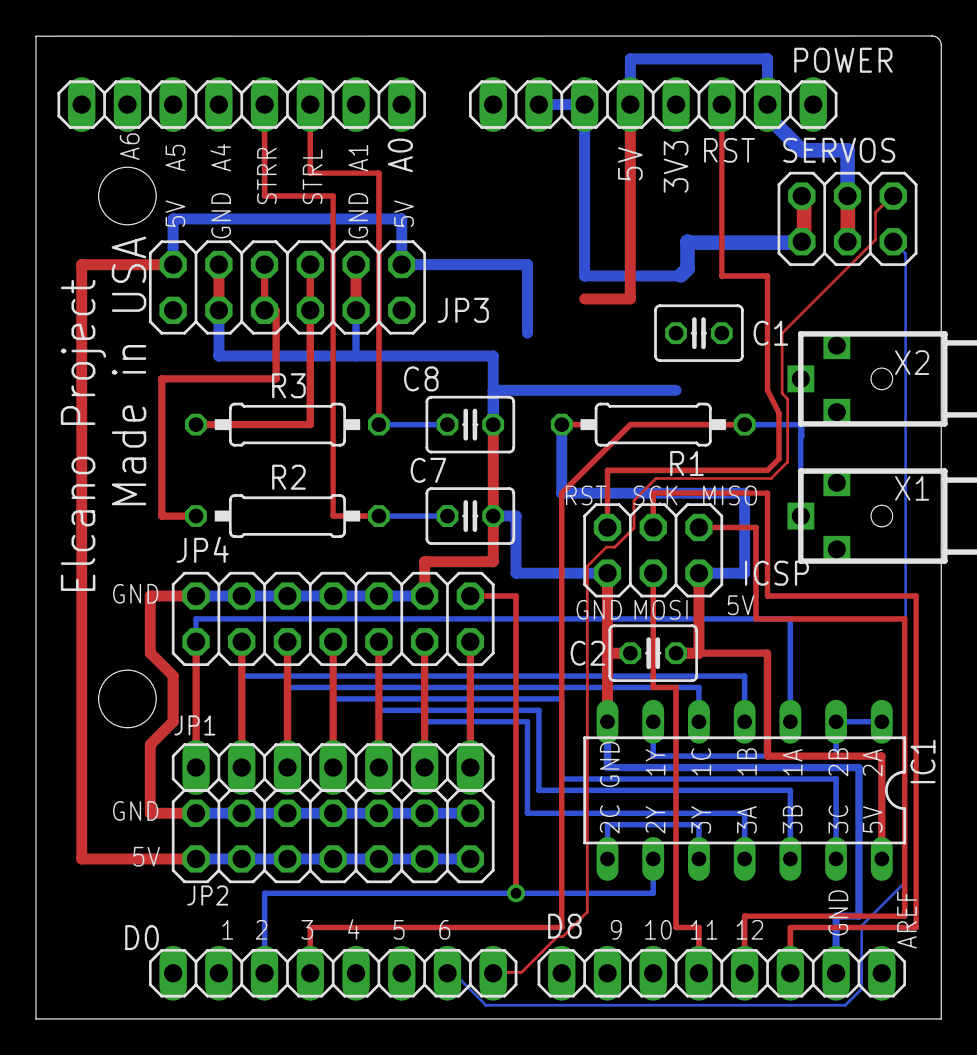
[picture p60: board RC_shieldV2.brd from above]

Board: 2 copper layers, 50.3 x 54.6 mm, 20 parts (0 on the bottom side), 23 nets.
