lanfuli/Localization/elcano-master/Electronics/MegaShieldTrio.brd

## EAGLE design elcano-master/Electronics/MegaShieldTrio.brd (2016-07-03)

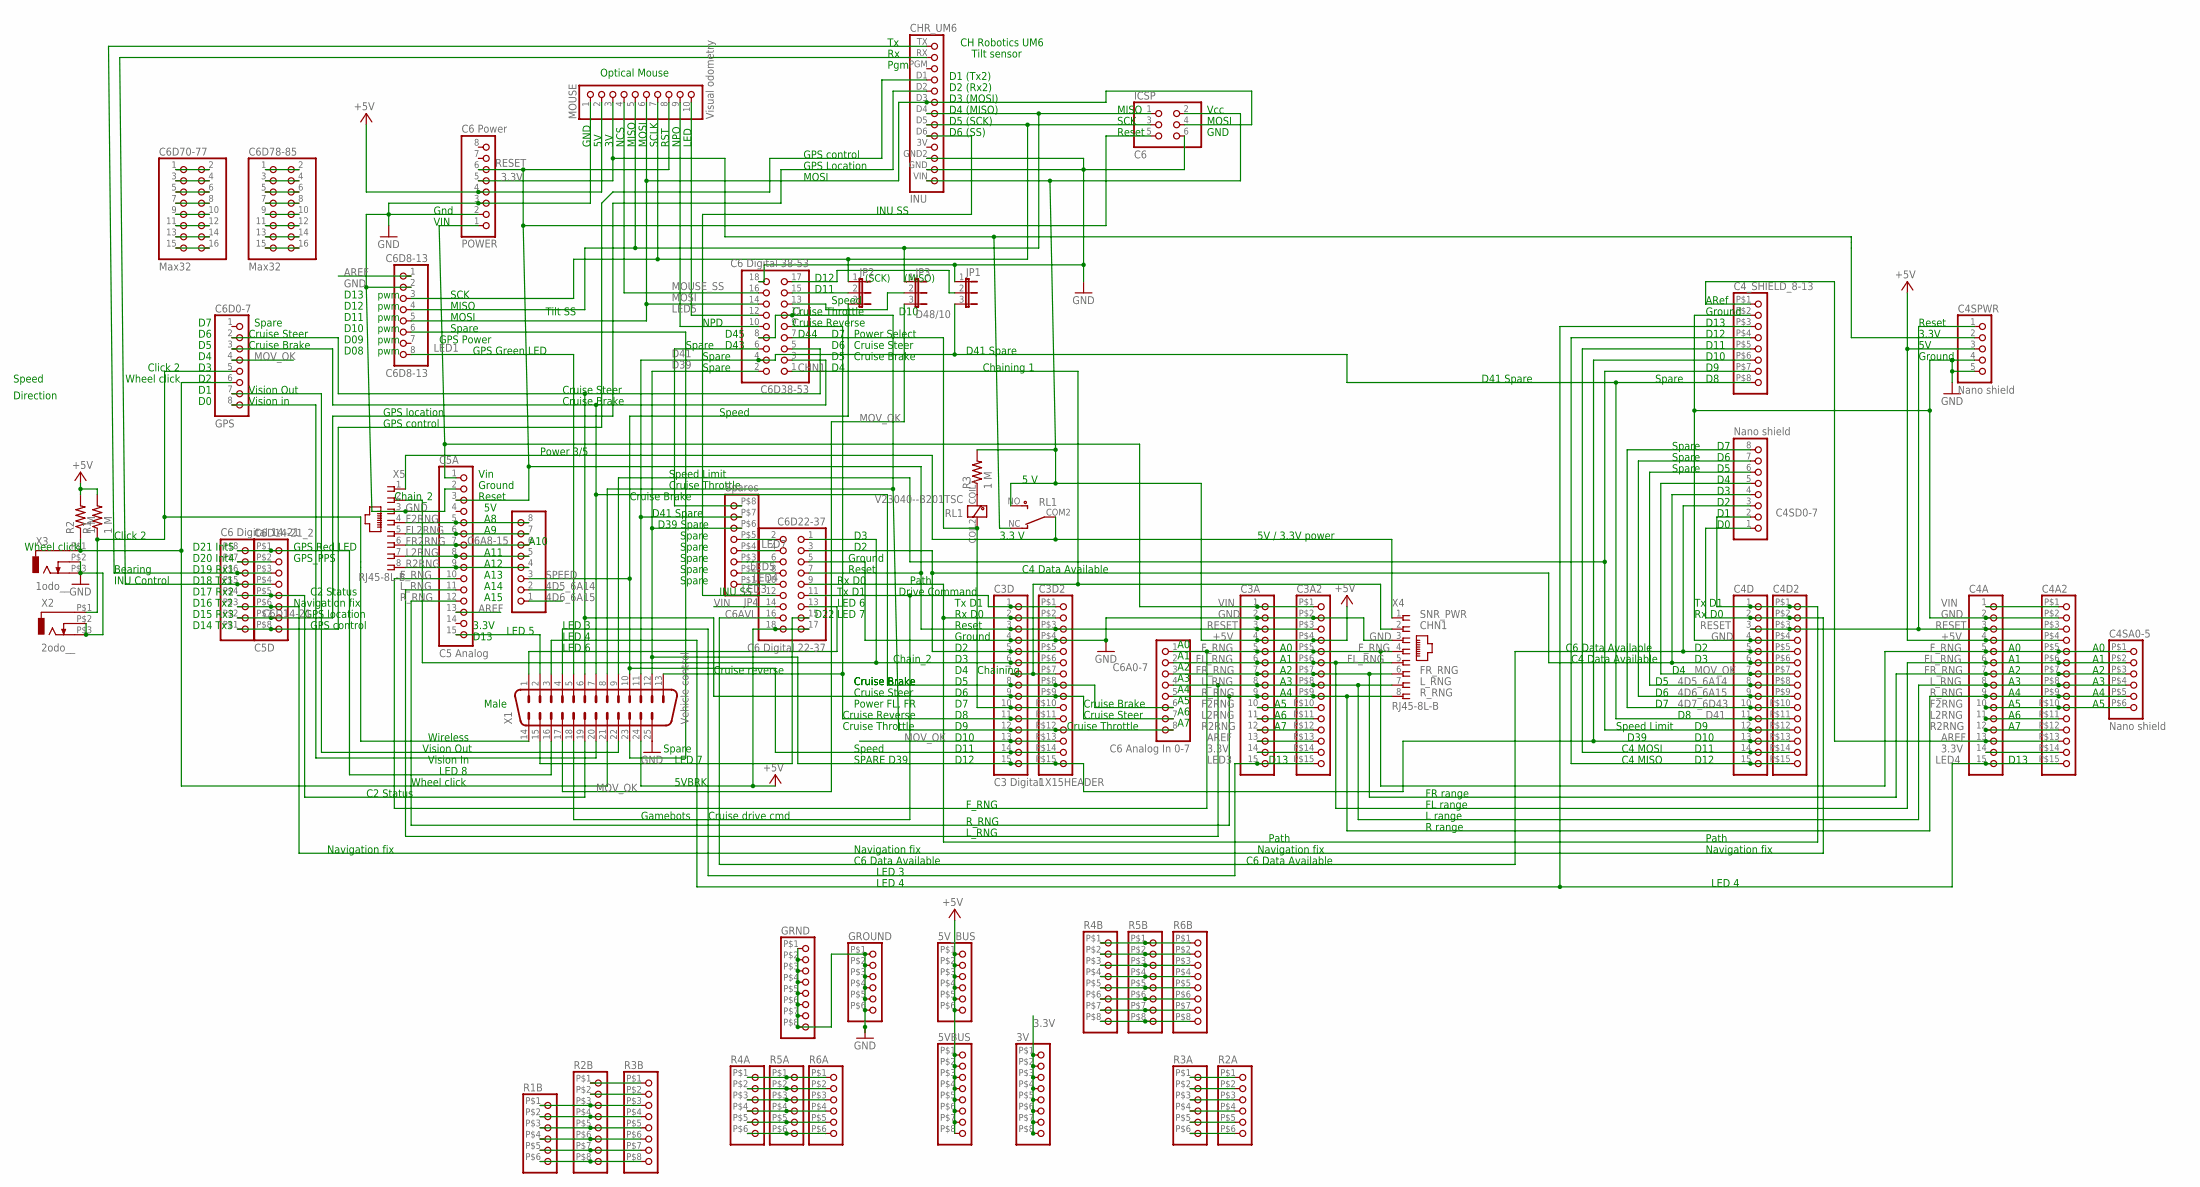
[picture p61: schematic MegaShieldTrio.sch]

Parts:
3V: 1X8HEADER
5VBUS: PINHD-1X8SMALL8; 1X8HEADER
5V_BUS: 1X6HEADER
C3A, C4A, C4D: 1X15
C3A2, C4A2, C4D2: 1X15HEADER
C3D: C3 Digital; 1X15
C3D2: 1X15HEADER
C4SA0-5: Nano shield; 1X6HEADER
C4SD0-7: Nano shield; 1X08
C4SPWR: Nano shield; 1X05
C4_SHIELD_8-13: 1X8HEADER
C5A: C5 Analog; 1X15
C6A0-7: C6 Analog In 0-7; 1X08
C6A8-15: 1X08
C6D0-7: GPS; 1X08
C6D8-13: C6D8-13; 1X08
C6D14-21: C6 Digital 14-21; 1X8HEADER
C6D14-21_2: C5D; 1X8HEADER
C6D22-37: C6 Digital 22-37; 2X09
C6D38-53: C6 Digital 38-53; 2X09
C6D70-77, C6D78-85: Max32; 2X08
GRND: PINHD-1X8SMALL8; 1X8HEADER
GROUND: 1X6HEADER
ICSP: C6; 2X03
INU: CHR_UM6
JP1, JP2: JP2
JP3: D48/10; JP2
JP4: Spares; 1X8HEADER
MOUSE: Visual odometry; 1X10
POWER: C6 Power; 1X08
R1, R2, R3: 1 M; 0207/10
R1B, R2A, R3A, R4A, R5A: 1X6HEADER
R2B, R3B, R4B, R5B, R6B: PINHD-1X8SMALL8; 1X8HEADER
R6A: 1X6HEADER
RL1: V23040--B201TSC; TSC-112L3H
X1: Vehicle control; M25H
X2: 2odo__; ODO_JACK
X3: 1odo__; ODO_JACK
X4, X5: RJ45-8L-B; RJ45-NO-SHIELD

Connections:
3.3V: 3V.P$1 (1), 3V.P$2 (2), 3V.P$3 (3), 3V.P$4 (4), 3V.P$5 (5), 3V.P$6 (6), 3V.P$7 (7), 3V.P$8 (8), C3A.14, C3A2.P$14 (14), C4A.14, C4A2.P$14 (14), C4SPWR.2, MOUSE.3, POWER.5, RL1.NC (4)
4D5_6A14: C4D.8, C4D2.P$8 (8), C4SD0-7.6, C6A8-15.2
4D6_6A15: C4D.9, C4D2.P$9 (9), C4SD0-7.7, C6A8-15.1
4D7_6D43: C4D.10, C4D2.P$10 (10), C4SD0-7.8
6D10_2A6: C6D8-13.6, X1.23
+5V: 5VBUS.P$1 (1), 5VBUS.P$2 (2), 5VBUS.P$3 (3), 5VBUS.P$4 (4), 5VBUS.P$5 (5), 5VBUS.P$6 (6), 5VBUS.P$7 (7), 5VBUS.P$8 (8), 5V_BUS.P$1 (1), 5V_BUS.P$2 (2), 5V_BUS.P$3 (3), 5V_BUS.P$4 (4), 5V_BUS.P$5 (5), 5V_BUS.P$6 (6), C3A.4, C3A2.P$4 (4), C4A.4, C4A2.P$4 (4), C4SPWR.3, C6D22-37.17, C6D22-37.18, ICSP.2, INU.VIN (1), MOUSE.2, POWER.4, R1.2, R2.2, R3.2, RL1.NO (6), X1.24
AREF: C3A.13, C3A2.P$13 (13), C4A.13, C4A2.P$13 (13), C4_SHIELD_8-13.P$1 (1), C5A.13, C6D8-13.1
C2STAT: C6D14-21.P$4 (4), C6D14-21_2.P$5 (5), X1.19
C4AVL: C3D.5, C3D2.P$5 (5), C4D.6, C4D2.P$6 (6), C4SD0-7.4, C6D22-37.3
C4D11: C4D.14, C4D2.P$14 (14), C4_SHIELD_8-13.P$5 (5)
C4D12: C4D.15, C4D2.P$15 (15), C4_SHIELD_8-13.P$4 (4)
C6AVL: C4D.5, C4D2.P$5 (5), C4SD0-7.3, C6D22-37.16
C6D29: C6D22-37.10, JP4.P$1 (1)
C6D31: C6D22-37.8, JP4.P$2 (2)
C6D33: C6D22-37.6, JP4.P$3 (3)
C6D35: C6D22-37.4, JP4.P$4 (4)
C6D37: C6D22-37.2, JP4.P$5 (5)
CHN1: C3D.7, C3D2.P$7 (7), C6D38-53.1, X4.2
CHN2: C3D.6, C3D2.P$6 (6), C6D22-37.1, X5.2
CLICK1: C6D0-7.6, R2.1, X1.21, X3.P$1 (1)
CLICK2: C6D0-7.5, R1.1, X1.14, X2.P$1 (1)
CRS_BRK: C3D.8, C3D2.P$8 (8), C6A0-7.6, C6D0-7.3, C6D38-53.3, X1.7
CRS_REV: C3D.11, C3D2.P$11 (11), C6D38-53.9, X1.13
CRS_STR: C3D.9, C3D2.P$9 (9), C6A0-7.7, C6D0-7.2, C6D38-53.5, X1.6
CRS_THR: C3D.12, C3D2.P$12 (12), C6A0-7.8, C6D38-53.8, C6D38-53.11, X1.8
D39: C3D.15, C3D2.P$15 (15), C4D.13, C4D2.P$13 (13), C4_SHIELD_8-13.P$6 (6), C6D38-53.2, JP4.P$6 (6), X1.12
D41: C4D.11, C4D2.P$11 (11), C4_SHIELD_8-13.P$8 (8), C6D38-53.4, JP1.3, JP4.P$7 (7), X1.11
DRV_CMD: C3D.1, C3D2.P$1 (1), C6D22-37.11, X1.18
F2RNG: C3A.10, C3A2.P$10 (10), C4A.10, C4A2.P$10 (10), C4SA0-5.P$6 (6), C5A.5, C6A8-15.8, X5.4
FL2RNG: C5A.6, C6A8-15.7, X5.5
FL_RNG: C3A.6, C3A2.P$6 (6), C4A.6, C4A2.P$6 (6), C4SA0-5.P$2 (2), C6A0-7.2, X4.5
FR2RNG: C5A.7, C6A8-15.6, X5.6
FR_RNG: C3A.7, C3A2.P$7 (7), C4A.7, C4A2.P$7 (7), C4SA0-5.P$3 (3), C6A0-7.3, X4.6
F_RNG: C3A.5, C3A2.P$5 (5), C4A.5, C4A2.P$5 (5), C4SA0-5.P$1 (1), C5A.10, C6A0-7.1, X4.4
GND: C3A.2, C3A2.P$2 (2), C3D.4, C3D2.P$4 (4), C4A.2, C4A2.P$2 (2), C4D.4, C4D2.P$4 (4), C4SPWR.4, C4SPWR.5, C4_SHIELD_8-13.P$2 (2), C5A.2, C6D8-13.2, C6D22-37.5, C6D38-53.18, GRND.P$1 (1), GRND.P$2 (2), GRND.P$3 (3), GRND.P$4 (4), GRND.P$5 (5), GRND.P$6 (6), GRND.P$7 (7), GRND.P$8 (8), GROUND.P$1 (1), GROUND.P$2 (2), GROUND.P$3 (3), GROUND.P$4 (4), GROUND.P$5 (5), GROUND.P$6 (6), ICSP.6, INU.GND (2), INU.GND2 (3), JP1.1, MOUSE.1, POWER.2, POWER.3, X1.25, X2.P$2 (2), X2.P$3 (3), X3.P$2 (2), X3.P$3 (3), X4.3, X5.3
GPS_CNTRL: C6D14-21.P$1 (1), C6D14-21_2.P$8 (8), INU.D1 (10)
GPS_LOC: C6D14-21.P$2 (2), C6D14-21_2.P$7 (7), INU.D2 (9)
INU_BRN: C6D14-21.P$6 (6), C6D14-21_2.P$3 (3), INU.TX (13)
INU_CNTRL: C6D14-21.P$5 (5), C6D14-21_2.P$4 (4), INU.RX (12)
INU_SS: C6D22-37.12, INU.D6 (5)
L2RNG: C3A.11, C3A2.P$11 (11), C4A.11, C4A2.P$11 (11), C5A.8, C6A8-15.5, X5.7
LED1: C6D8-13.8, X1.5
LED3: C3A.15, C3A2.P$15 (15), X1.4
LED4: C4A.15, C4A2.P$15 (15), C4_SHIELD_8-13.P$3 (3), X1.3
LED5: C5A.15, C6D38-53.12, MOUSE.10, X1.2
LED6: C6D22-37.13, X1.1
LED7: C6D22-37.15, X1.15
LED8: C6D14-21.P$8 (8), C6D14-21_2.P$1 (1), X1.16
L_RNG: C3A.8, C3A2.P$8 (8), C4A.8, C4A2.P$8 (8), C4SA0-5.P$4 (4), C5A.11, C6A0-7.4, X4.7
MISO: C6D8-13.4, ICSP.1, INU.D4 (7), JP3.1, MOUSE.5
MOSI: C6D8-13.5, C6D38-53.14, ICSP.4, INU.D3 (8), MOUSE.6
MOUSE_SS: C6D38-53.16, MOUSE.4
MOV_OK: C3D.13, C3D2.P$13 (13), C4D.7, C4D2.P$7 (7), C4SD0-7.5, C6D0-7.4, JP3.3, X1.17
unnamed: R2B.P$1 (1), R3B.P$1 (1)
unnamed: R2B.P$2 (2), R3B.P$2 (2)
unnamed: C6D38-53.6, JP4.P$8 (8)
unnamed: C6D38-53.15, JP2.2
unnamed: C6D38-53.13, JP3.2
unnamed: C6D38-53.17, JP1.2
unnamed: C6D14-21.P$7 (7), C6D14-21_2.P$2 (2)
unnamed: R3.1, RL1.COIL1 (1)
unnamed: R1B.P$1 (1), R2B.P$3 (3), R3B.P$3 (3)
unnamed: R1B.P$2 (2), R2B.P$4 (4), R3B.P$4 (4)
unnamed: R1B.P$3 (3), R2B.P$5 (5), R3B.P$5 (5)
unnamed: R1B.P$4 (4), R2B.P$6 (6), R3B.P$6 (6)
unnamed: R1B.P$5 (5), R2B.P$7 (7), R3B.P$7 (7)
unnamed: R1B.P$6 (6), R2B.P$8 (8), R3B.P$8 (8)
unnamed: R4A.P$1 (1), R5A.P$1 (1), R6A.P$1 (1)
unnamed: R4A.P$2 (2), R5A.P$2 (2), R6A.P$2 (2)
unnamed: R4A.P$3 (3), R5A.P$3 (3), R6A.P$3 (3)
unnamed: R4A.P$4 (4), R5A.P$4 (4), R6A.P$4 (4)
unnamed: R4A.P$5 (5), R5A.P$5 (5), R6A.P$5 (5)
unnamed: R4A.P$6 (6), R5A.P$6 (6), R6A.P$6 (6)
unnamed: R4B.P$1 (1), R5B.P$1 (1), R6B.P$1 (1)
unnamed: C6D78-85.1, C6D78-85.2
unnamed: C6D78-85.3, C6D78-85.4
unnamed: R4B.P$2 (2), R5B.P$2 (2), R6B.P$2 (2)
unnamed: R4B.P$3 (3), R5B.P$3 (3), R6B.P$3 (3)
unnamed: C6D78-85.5, C6D78-85.6
unnamed: R4B.P$5 (5), R5B.P$5 (5), R6B.P$5 (5)
unnamed: C6D78-85.7, C6D78-85.8
unnamed: C6D78-85.9, C6D78-85.10
unnamed: R4B.P$6 (6), R5B.P$6 (6), R6B.P$6 (6)
unnamed: R4B.P$7 (7), R5B.P$7 (7), R6B.P$7 (7)
unnamed: R4B.P$8 (8), R5B.P$8 (8), R6B.P$8 (8)
unnamed: R2A.P$1 (1), R3A.P$1 (1)
unnamed: R2A.P$2 (2), R3A.P$2 (2)
unnamed: C6D78-85.11, C6D78-85.12
unnamed: C6D78-85.13, C6D78-85.14
unnamed: C6D78-85.15, C6D78-85.16
unnamed: R2A.P$3 (3), R3A.P$3 (3)
unnamed: C6D70-77.1, C6D70-77.2
unnamed: R2A.P$4 (4), R3A.P$4 (4)
unnamed: R2A.P$5 (5), R3A.P$5 (5)
unnamed: C6D70-77.3, C6D70-77.4
unnamed: C6D70-77.5, C6D70-77.6
unnamed: C6D70-77.7, C6D70-77.8
unnamed: C6D70-77.9, C6D70-77.10
unnamed: C6D70-77.11, C6D70-77.12
unnamed: C6D70-77.13, C6D70-77.14
unnamed: C6D70-77.15, C6D70-77.16
unnamed: R2A.P$6 (6), R3A.P$6 (6)
NAV_FIX: C4D.2, C4D2.P$2 (2), C4SD0-7.1, C6D14-21.P$3 (3), C6D14-21_2.P$6 (6)
NPD: C6D38-53.10, MOUSE.9
PATH: C3D.2, C3D2.P$2 (2), C4D.1, C4D2.P$1 (1), C4SD0-7.2, C6D22-37.9
PWR_SEL: C3D.10, C3D2.P$10 (10), C6D38-53.7, RL1.COIL2 (2)
R2RNG: C3A.12, C3A2.P$12 (12), C4A.12, C4A2.P$12 (12), C5A.9, C6A8-15.4, X5.8
R5B: R4B.P$4 (4), R5B.P$4 (4), R6B.P$4 (4)
RESET: C3A.3, C3A2.P$3 (3), C3D.3, C3D2.P$3 (3), C4A.3, C4A2.P$3 (3), C4D.3, C4D2.P$3 (3), C4SPWR.1, C5A.3, C6D22-37.7, ICSP.5, MOUSE.8, POWER.6
R_RNG: C3A.9, C3A2.P$9 (9), C4A.9, C4A2.P$9 (9), C4SA0-5.P$5 (5), C5A.12, C6A0-7.5, X4.8
SCK: C6D8-13.3, ICSP.3, INU.D5 (6), JP2.1, MOUSE.7
SNR_PWR: RL1.COM2 (5), X4.1, X5.1
SPD_LMT: C4D.12, C4D2.P$12 (12), C4_SHIELD_8-13.P$7 (7), X1.9
SPEED: C3D.14, C3D2.P$14 (14), C6A8-15.3, JP2.3, X1.10
VIN: C3A.1, C3A2.P$1 (1), C4A.1, C4A2.P$1 (1), C5A.1, C6D22-37.14, POWER.1
VIS_IN: C6D0-7.8, X1.20
VIS_OUT: C6D0-7.7, X1.22

Notes on the sheet:
pwm
(SCK)
(MISO)
Cruise Brake
Cruise Throttle
Cruise Steer
Gnd
Male
A10
A11
A13
A14
A15
5VBRK
D45
D43
D10
D11
D12
D13
D09
D08
VIN
Rx D0
Tx D1
Reset
Ground
3.3V
ARef
Path
Navigation fix
D14 Tx3
D15 Rx3
D16 Tx2
D17 Rx2
D18 Tx1
D19 Rx1
D20 Int4
D21 Int5
C6 Data Available
C4 Data Available
Tilt sensor
Wheel click
FR range
L range
Chaining
Power FL, FR
Cruise Reverse
Speed Limit
Speed
LED 7
LED 8
Cruise drive cmd
Gamebots
LED 3
LED 4
Direction
D22
INU Control
Bearing
GPS control
GPS location
GPS Power
GPS Green LED
GPS Red LED
GPS_PPS
Optical Mouse
GND
NCS
MISO
MOSI
SCLK
RST
NPO
LED
Pgm
D1 (Tx2)
D2 (Rx2)
D3 (MOSI)
D4 (MISO)
D5 (SCK)
D6 (SS)
R range
FL range
5V / 3.3V power
NPD
Tilt SS
GPS Location
3.3 V
5 V
Wireless
CH Robotics UM6
Chain_2
Power 3/5
Vin
SCK
Vcc
SPARE D39
D39
C4 MOSI
C4 MISO
A12
D44
Power Select
Chaining 1
Drive Command
C2 Status
Spare
Click 2
Vision in
Vision Out
LED 6
INU SS
LED 5
Vision In
Cruise reverse
D39 Spare
D41 Spare
R_RNG
L_RNG
F_RNG

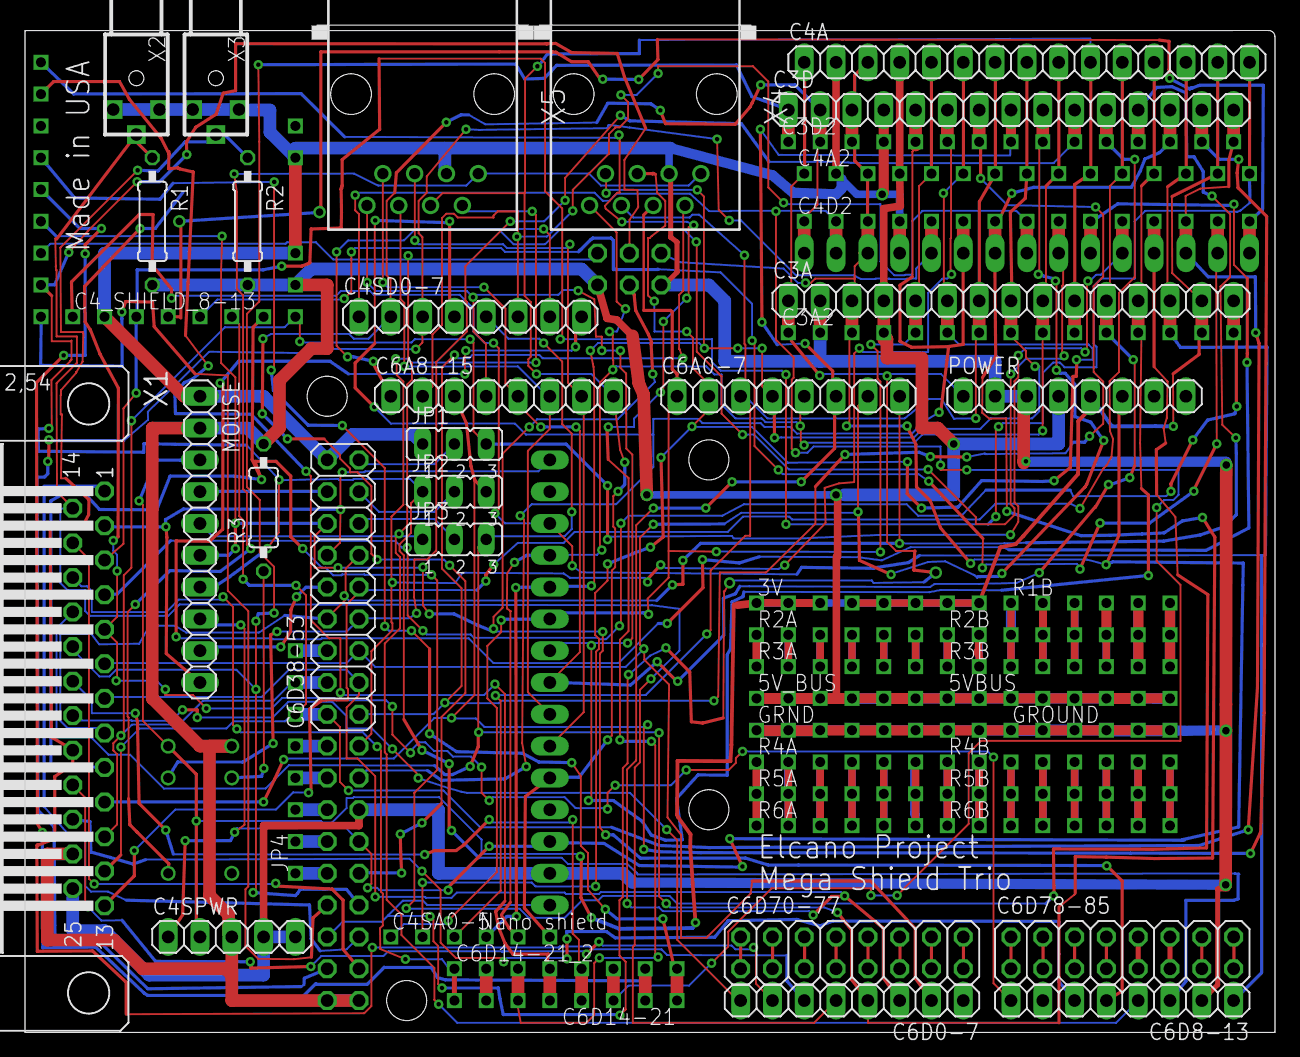
[picture p62: board MegaShieldTrio.brd from above]

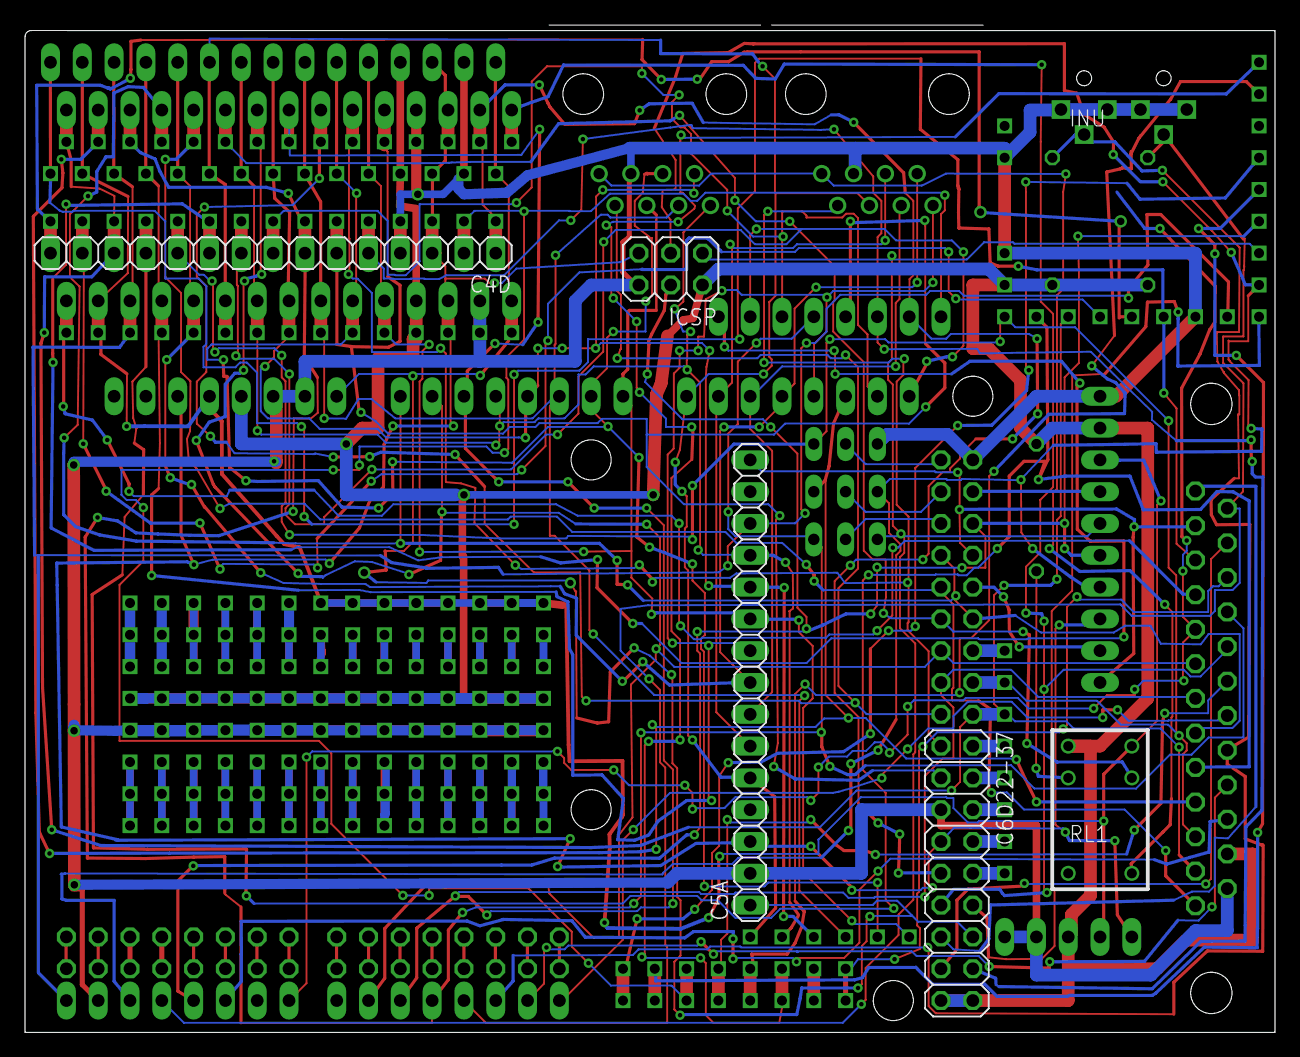
[picture p63: board MegaShieldTrio.brd from below]

Board: 2 copper layers, 99.8 x 80.0 mm, 56 parts (6 on the bottom side), 117 nets.
