lanfuli/Localization/elcano-master/Electronics/MegaShieldTrioV2.brd

## EAGLE design elcano-master/Electronics/MegaShieldTrioV2.brd (2016-07-03)

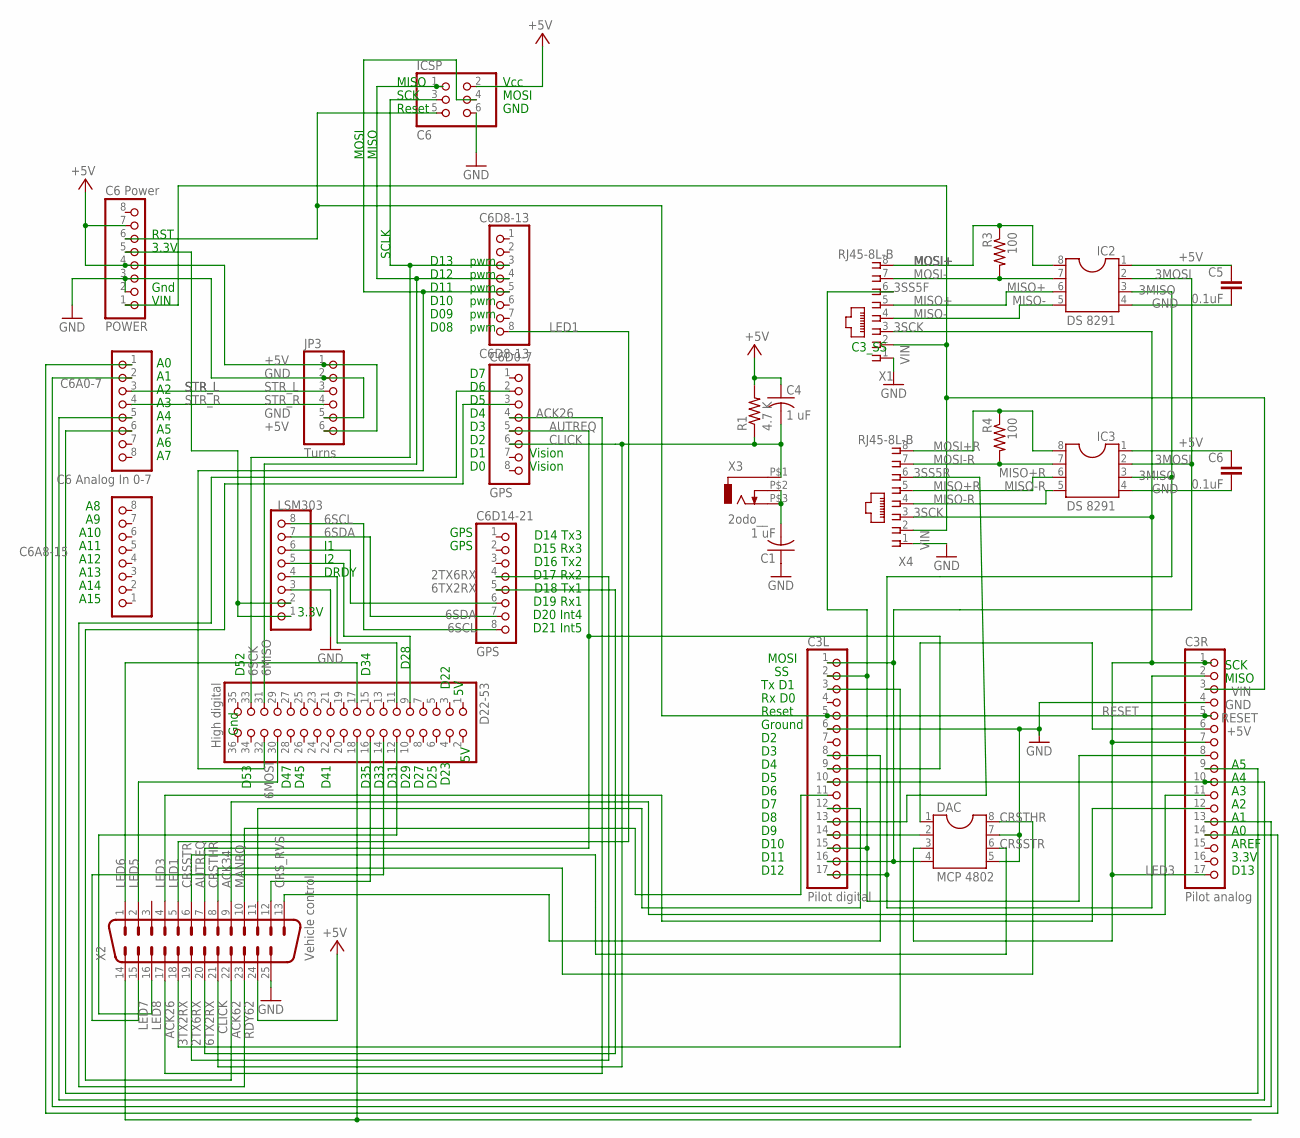
[picture p66: schematic MegaShieldTrioV2.sch]

Parts:
C1, C4: 1 uF; C025-030X050
C3L: Pilot digital; 1X17
C3R: Pilot analog; 1X17
C5, C6: 0.1uF; C2.5-2
C6A0-7: C6 Analog In 0-7; 1X08
C6A8-15: 1X08
C6D0-7, C6D14-21: GPS; 1X08
C6D8-13: C6D8-13; 1X08
D22-53: High digital; 2X18
DAC: MCP 4802; DIL08
IC2, IC3: DS 8291; DIL08
ICSP: C6; 2X03
JP3: Turns; 1X06
LSM303: 1X08
POWER: C6 Power; 1X08
R1: 4.7 K; 0207/10
R3, R4: 100; 0204/5
X1, X4: RJ45-8L-B; RJ45-NO-SHIELD
X2: Vehicle control; M25H
X3: 2odo__; ODO_JACK

Connections:
2TX6RX: C6D14-21.4, X2.19
3MISO: C3L.17, C3R.2, IC2.3, IC3.3
3MOSI: C3L.1, C3L.16, DAC.4, IC2.2, IC3.2
3SCK: C3R.1, C3R.7, C3R.17, DAC.3, X1.3, X4.3
3SS5F: C3L.2, C3L.15, C3R.8, X1.6
3SS5R: C3L.13, X4.6
3SS_DAC: C3L.14, DAC.2
3TX2RX: C3L.3, X2.18
3V3: LSM303.1, LSM303.2, POWER.5
5V_C3: C3R.6, DAC.1
6MISO: C6D8-13.4, D22-53.31, ICSP.1
6MOSI: C6D8-13.5, D22-53.32, ICSP.4
6SCK: C6D8-13.3, D22-53.33, ICSP.3
6SCL: C6D14-21.8, LSM303.8
6SDA: C6D14-21.7, LSM303.7
6TX2RX: C6D14-21.5, X2.20
+5V: C4.1, C5.1, C6.1, IC2.1, IC3.1, ICSP.2, JP3.1, JP3.6, POWER.4, POWER.7, R1.2, X2.24
A0: C3R.14, C6A0-7.1
A1: C3R.13, C6A0-7.2
A5: C3R.9, C6A0-7.6
ACK26: C6D0-7.4, X2.17
ACK34: C3R.11, X2.9
ACK43: C3L.10, C3R.10, C6A0-7.5
ACK62: C6D0-7.3, X2.22
AUTREQ: C3L.9, C6D0-7.5, X2.7
CLICK: C4.2, C6D0-7.6, R1.1, X2.21, X3.P$1 (1)
CRSSTR: DAC.6, X2.6
CRSTHR: DAC.8, X2.8
CRS_RVS: C3L.8, X2.13
D09: D22-53.18, X2.14
DRDY: D22-53.11, LSM303.4
GND: C1.1, C3L.6, C3R.4, C5.2, C6.2, DAC.5, DAC.7, IC2.4, IC3.4, ICSP.6, JP3.2, JP3.5, LSM303.3, POWER.2, POWER.3, X1.1, X2.25, X4.1
I1LSM: C6D14-21.6, LSM303.6
I2LSM: D22-53.9, LSM303.5
LED1: C6D8-13.8, X2.5
LED3: C3R.12, X2.4
LED5: D22-53.30, X2.2
LED6: D22-53.17, X2.1
LED7: D22-53.14, X2.15
LED8: D22-53.12, X2.16
MANRQ: C3L.11, X2.10
MISO+: IC2.6, X1.5
MISO+R: IC3.6, X4.5
MISO-: IC2.5, X1.4
MISO-R: IC3.5, X4.4
MOSI+: IC2.8, R3.1, X1.8
MOSI+R: IC3.8, R4.1, X4.8
MOSI-: IC2.7, R3.2, X1.7
MOSI-R: IC3.7, R4.2, X4.7
unnamed: C1.2, X3.P$2 (2), X3.P$3 (3)
RDY26: D22-53.16, X2.12
RDY32: C3L.12, X2.11
RDY62: C6D0-7.2, X2.23
RESET: C3L.5, C3R.5, ICSP.5, POWER.6
STR_L: C6A0-7.3, JP3.3
STR_R: C6A0-7.4, JP3.4
VIN: C3R.3, POWER.1, X1.2, X4.2

Notes on the sheet:
pwm
Gnd
A10
A11
A13
A14
A15
D10
D11
D12
D13
D09
D08
VIN
Rx D0
Tx D1
Reset
Ground
D14 Tx3
D15 Rx3
D16 Tx2
D17 Rx2
D18 Tx1
D19 Rx1
D20 Int4
D21 Int5
MISO
MOSI
SCLK
SCK
Vcc
GND
A12
D52
D22
RST
D23
C3_SS
3.3V
AREF
DRDY
GPS
Vision
D27
D29
D31
D25
D33
D35
D53
D47
D45
D41
D34
D28

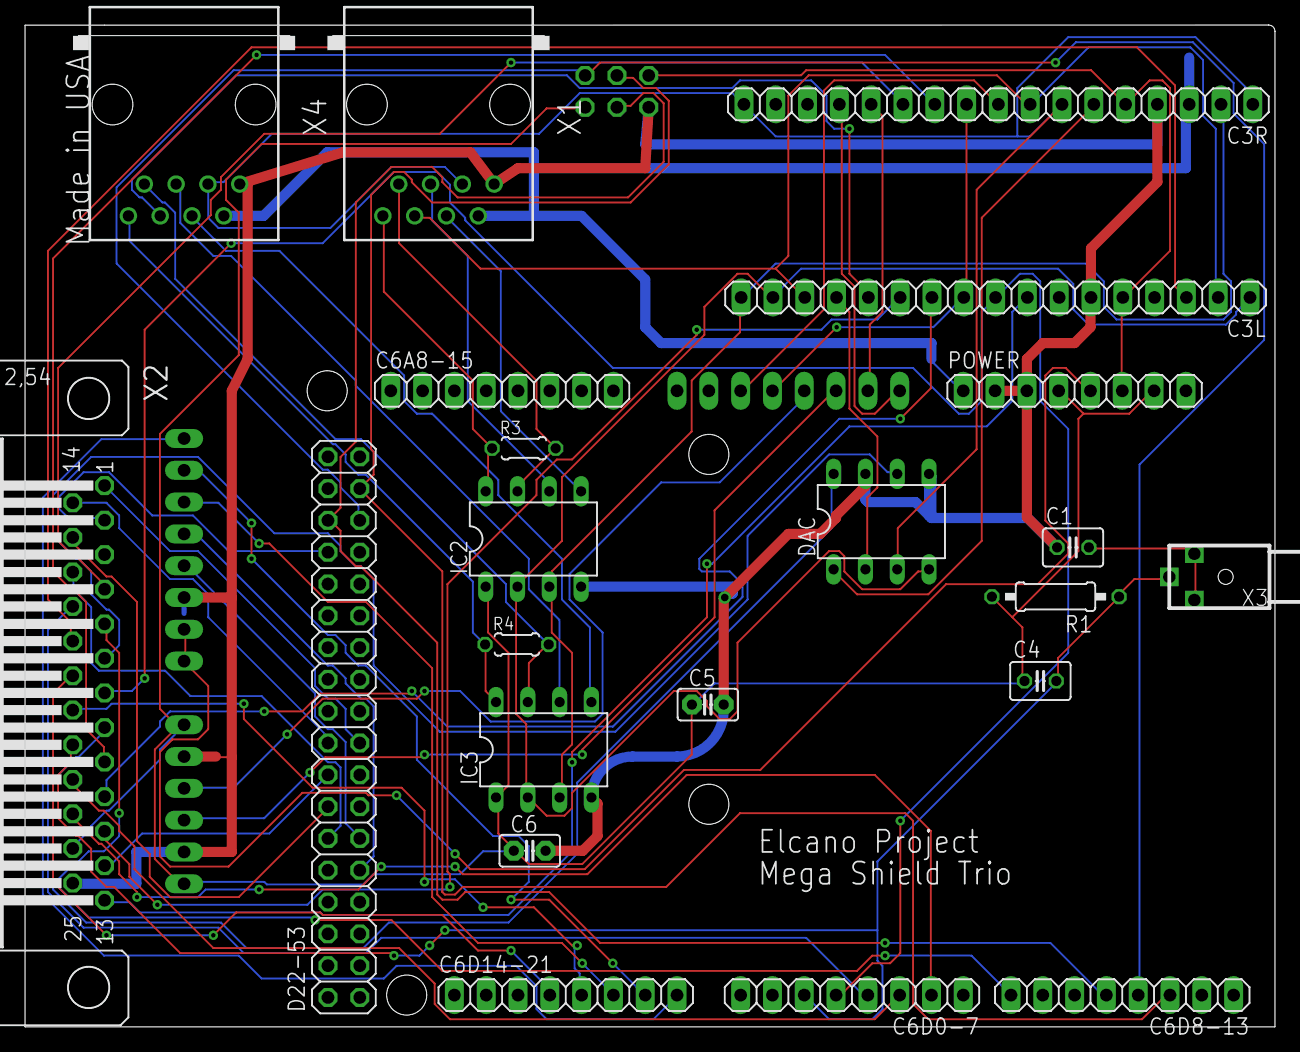
[picture p67: board MegaShieldTrioV2.brd from above]

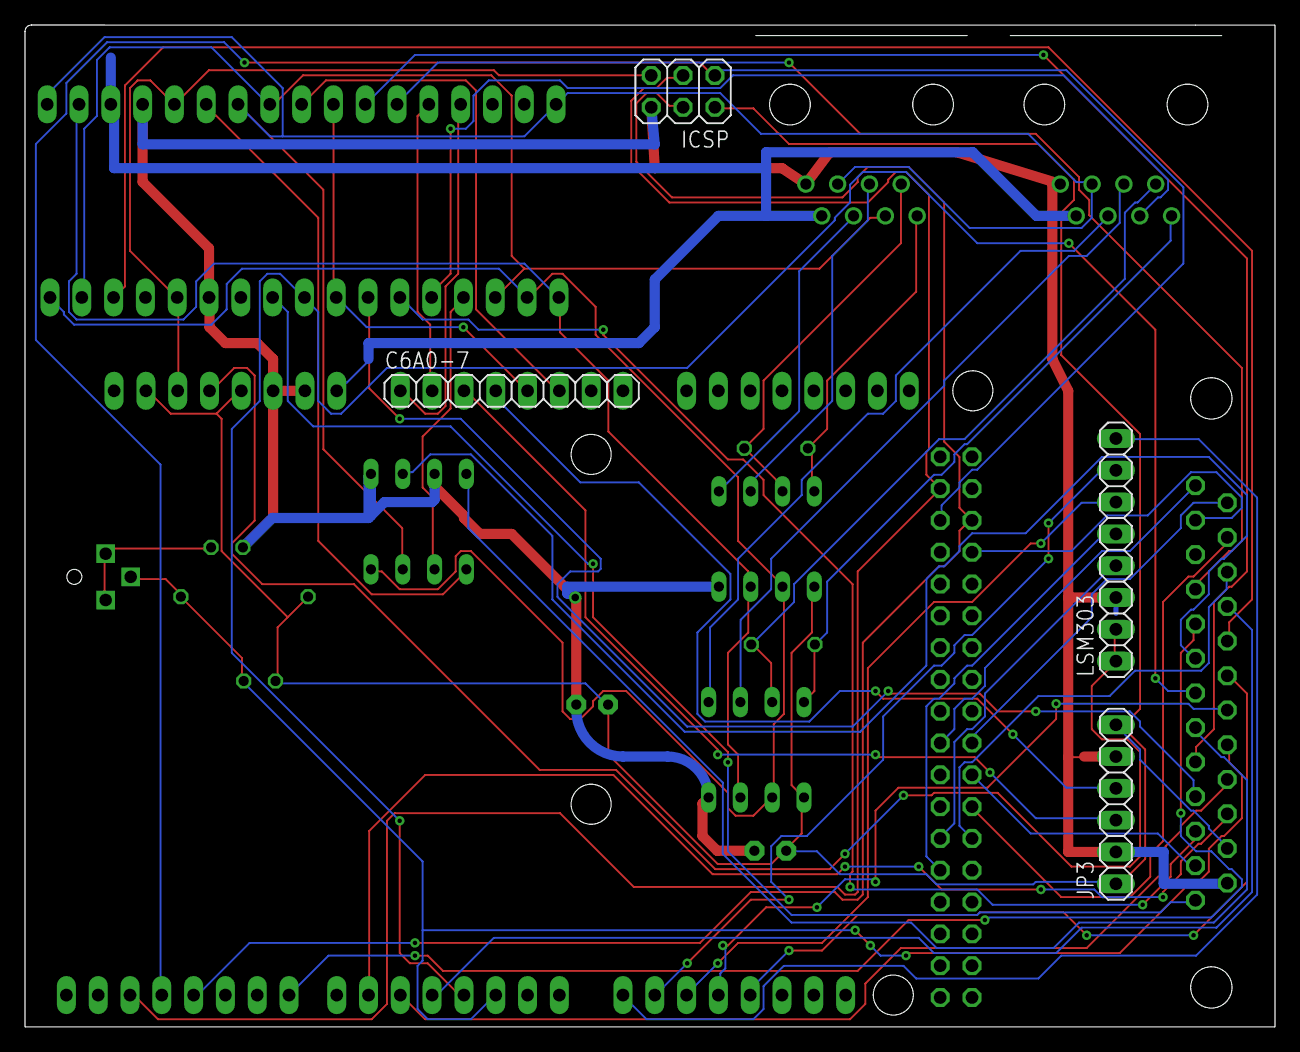
[picture p68: board MegaShieldTrioV2.brd from below]

Board: 2 copper layers, 99.8 x 80.0 mm, 26 parts (4 on the bottom side), 57 nets.
