lanfuli/Localization/elcano-master/Electronics/panelDoc.brd

## EAGLE design elcano-master/Electronics/panelDoc.brd (2016-07-03)

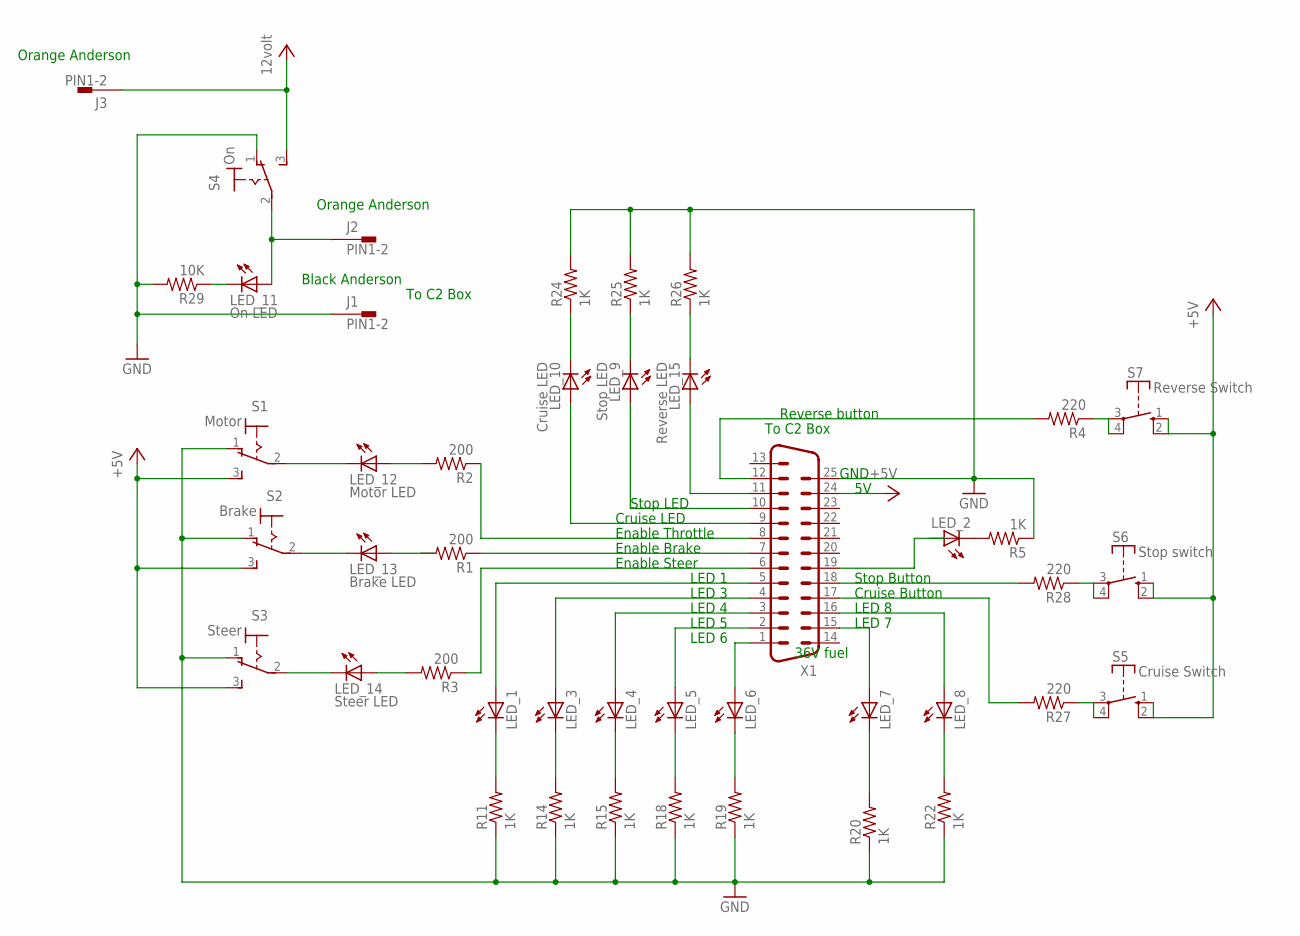
[picture p69: schematic panelDoc.sch]

Parts:
J1, J2, J3: PIN1-2; 62221
LED_1, LED_2, LED_3, LED_4, LED_5, LED_6, LED_7, LED_8: LEDB156; Q62902-B156
LED_9: Stop LED; Q62902-B156
LED_10: Cruise LED; Q62902-B156
LED_11: On LED; Q62902-B156
LED_12: Motor LED; Q62902-B156
LED_13: Brake LED; Q62902-B156
LED_14: Steer LED; Q62902-B156
LED_15: Reverse LED; Q62902-B156
R1, R2, R3: 200; 0204/7
R4, R27, R28: 220; 0204/7
R5, R11, R14, R15, R18, R19, R20, R22, R24, R25, R26: 1K; 0204/7
R29: 10K; 0204/7
S1: Motor; M9040P
S2: Brake; M9040P
S3: Steer; M9040P
S4: On; M9040P
S5: Cruise Switch; DTE6K
S6: Stop switch; DTE6K
S7: Reverse Switch; DTE6K
X1: M25-182; 182-025-MALE

Connections:
+5V: J3.1, S1.3 (S), S2.3 (S), S3.3 (S), S4.3 (S), S5.1 (S), S5.2 (S), S6.1 (S), S6.2 (S), S7.1 (S), S7.2 (S), X1.24
GND: J1.1, R5.1, R11.1, R14.1, R15.1, R18.1, R19.1, R20.1, R22.1, R24.2, R25.2, R26.2, R29.2, S1.1 (O), S2.1 (O), S3.1 (O), S4.1 (O), X1.25
unnamed: R3.1, X1.6
unnamed: LED_8.K (C), R22.2
unnamed: LED_10.K (C), R24.1
unnamed: LED_3.K (C), R14.2
unnamed: LED_3.A, X1.4
unnamed: LED_4.K (C), R15.2
unnamed: LED_4.A, X1.3
unnamed: LED_1.A, X1.5
unnamed: LED_8.A, X1.16
unnamed: LED_5.K (C), R18.2
unnamed: LED_5.A, X1.2
unnamed: LED_6.K (C), R19.2
unnamed: LED_6.A, X1.1
unnamed: LED_7.K (C), R20.2
unnamed: LED_10.A, X1.9
unnamed: LED_1.K (C), R11.2
unnamed: J2.1, LED_11.A, S4.2
unnamed: LED_11.K (C), R29.1
unnamed: R27.2, X1.17
unnamed: LED_7.A, X1.15
unnamed: LED_12.A, R2.2
unnamed: LED_15.A, X1.11
unnamed: LED_12.K (C), S1.2
unnamed: LED_13.K (C), S2.2
unnamed: LED_9.K (C), R25.1
unnamed: LED_9.A, X1.10
unnamed: LED_14.A, R3.2
unnamed: R2.1, X1.8
unnamed: LED_13.A, R1.2
unnamed: LED_14.K (C), S3.2
unnamed: R4.2, X1.12
unnamed: R1.1, X1.7
unnamed: R4.1, S7.3, S7.4
unnamed: R27.1, S5.3, S5.4
unnamed: R28.2, X1.18
unnamed: R28.1, S6.3, S6.4
unnamed: LED_2.K (C), R5.2
REVERSE: LED_15.K (C), R26.1

Notes on the sheet:
Orange Anderson
Black Anderson
To C2 Box
LED 1
LED 3
LED 4
LED 5
LED 6
LED 7
LED 8
GND
Enable Throttle
Enable Brake
Enable Steer
Cruise LED
Stop LED
Cruise Button
Stop Button
Reverse button
36V fuel

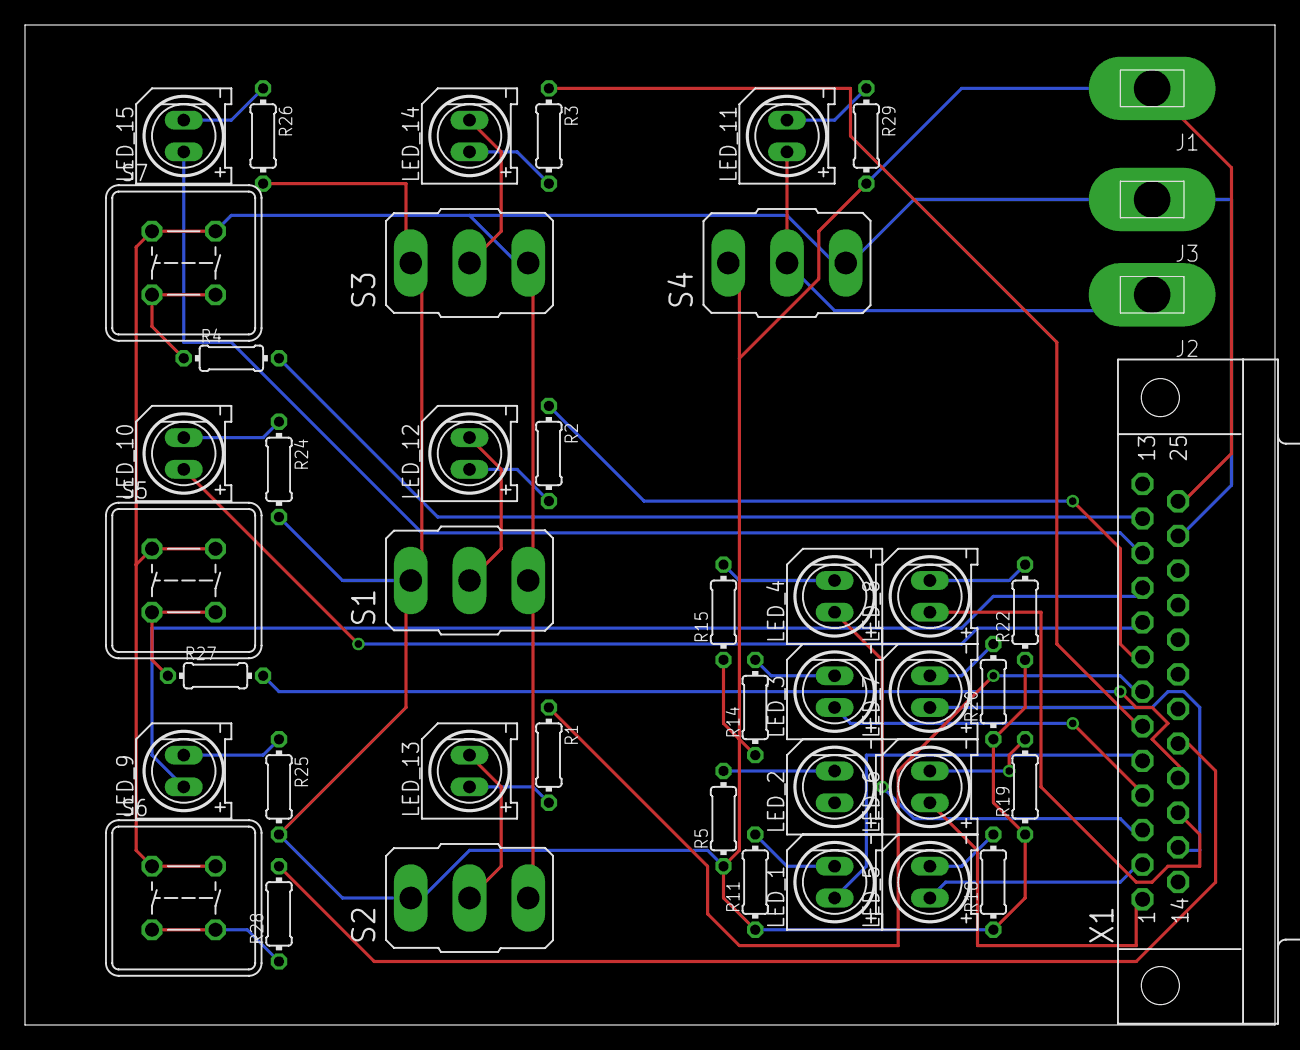
[picture p70: board panelDoc.brd from above]

Board: 2 copper layers, 100.0 x 80.0 mm, 44 parts (0 on the bottom side), 40 nets.
