lanfuli/Localization/elcano-master/Electronics/sonars.brd

## EAGLE design elcano-master/Electronics/sonars.brd (2016-07-03)

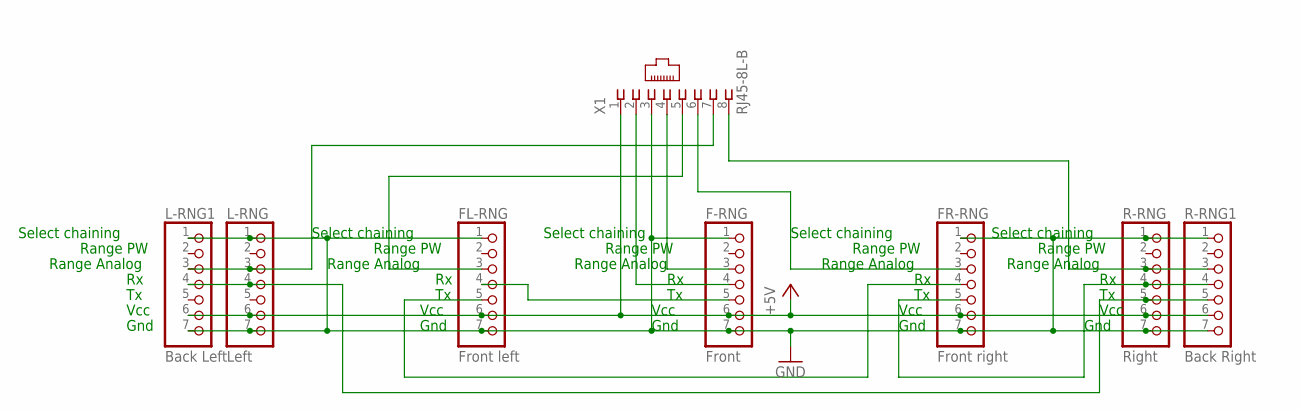
[picture p71: schematic sonars.sch]

Parts:
F-RNG: Front; 1X07
FL-RNG: Front left; 1X07
FR-RNG: Front right; 1X07
L-RNG: Left; 1X07
L-RNG1: Back Left; 1X07
R-RNG: Right; 1X07
R-RNG1: Back Right; 1X07
X1: RJ45-8L-B; RJ45-NO-SHIELD

Connections:
+5V: F-RNG.6, FL-RNG.6, FR-RNG.6, L-RNG.6, L-RNG1.6, R-RNG.6, R-RNG1.6, X1.1
CHN: F-RNG.4, X1.2
F>FL: F-RNG.5, FL-RNG.4
FL>FR: FL-RNG.5, FR-RNG.4
FL_RNG: FL-RNG.3, X1.5
FR>R: FR-RNG.5, R-RNG.4, R-RNG1.4
FR_RNG: FR-RNG.3, X1.6
F_RNG: F-RNG.3, X1.4
GND: F-RNG.1, F-RNG.7, FL-RNG.1, FL-RNG.7, FR-RNG.1, FR-RNG.7, L-RNG.1, L-RNG.7, L-RNG1.1, L-RNG1.7, R-RNG.1, R-RNG.7, R-RNG1.1, R-RNG1.7, X1.3
L_RNG: L-RNG.3, L-RNG1.3, X1.7
R>L: L-RNG.4, L-RNG1.4, R-RNG.5, R-RNG1.5
R_RNG: R-RNG.3, R-RNG1.3, X1.8

Notes on the sheet:
Select chaining
Range PW
Range Analog
Vcc
Gnd

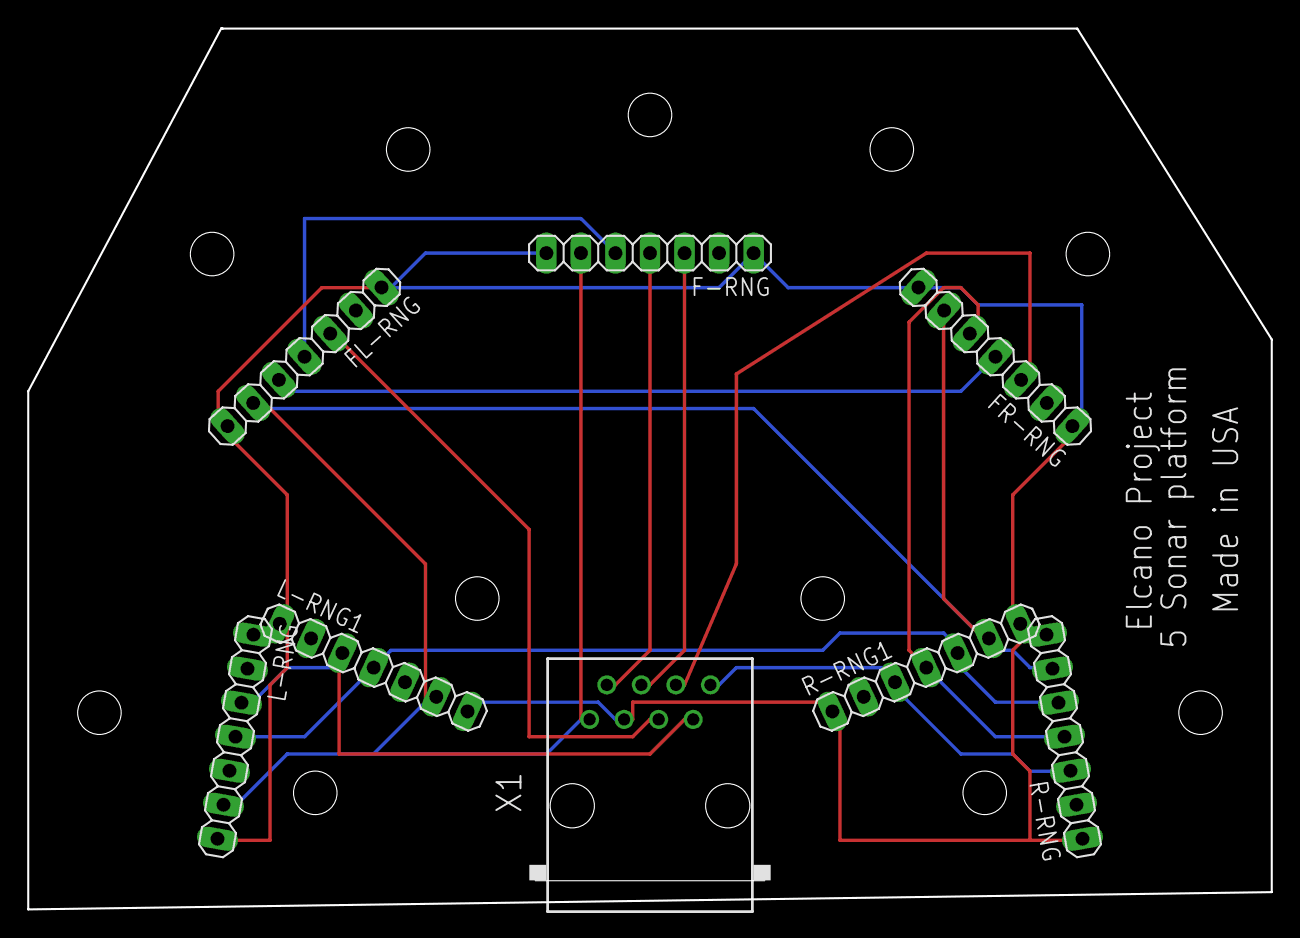
[picture p72: board sonars.brd from above]

Board: 2 copper layers, 91.4 x 64.8 mm, 8 parts (0 on the bottom side), 12 nets.
