lanfuli/Localization/elcano-master/MoveActuator/MoveActuator.ino

/*
 Move Actuator: Reduced version of Elcano_C2_Base for testing actuators
 
 Elcano Contol Module C2 Basic: Bare bones low level control of vehicle.
 
 Outputs are
 1) Analog 0-4 V signal for traction motor speed
 2) Pulse wave Modulated (PWM) signal for brakes.
 3) PWM signal for steering.
 
 7/1/15 TCF: Added ThrottleChannel
 */

// Input/Output (IO) pin names for the MegaShieldDB printed circuit board (PCB)
// #include <IOPCB.h>
/*==========================================================================*/
// Temporary fix 10/7/15:   IOPCB.h is here
/*==========================================================================*/
/* IO_PCB.h:  I/O pin assignments for Arduino Mega 2560 on MegaShieldDB
*/

#include <Settings.h>

// Define the tests to do.
#define BRAKE_RAMP
#define STEER_RAMP
#define MOTOR_RAMP
// If operating with the MegaShieldDB, we can use the Digital Analog Converter to move the vehicle
#define DAC

/*
The Mega is designed to be used with a data-logging shield.
The nonMega shield uses A4 and A5 for RTC and D10,11,12,and 13 for MOSI data logging.
*/

// @ToDo: There are declarations here that are per-trike, and some that are common.
// Parameters have been added to Settings.h for the per-trike values.
// Should the common parameters also be defined in Settings.h?

// DIGITAL I/O ----------------------------------------------

// D0-7 Connector -------------------------------
// On the Mega, any of D0 to D13 can be PWM.
/* D0 is (Rx0) Read Serial Data. */
const int Rx0 = 0;      // external input
/* [out] Digital Signal 1: (Tx0). Transmit Serial Data.  */
const int Tx0 = 1;      // external output

// This is the 5V supply produced by the E-bike controller.
//  If it goes away, 36V power has been turned off (presumably by the rider's key switch).
const int EStop =   2;         // external input
const int WheelClick = 3;      //  interrupt; Reed switch generates one pulse per rotation.

/*  Actuator A1. Traction motor throttle. */
const int Throttle =  5;  // external PWM output  DEPRICATED: Use MOSI
/* Actuator A3: Steering Motor. 
  Turns left or right. Default is wheels locked to a straight ahead position. */

const int Steer =  7;    // external PWM output
const int DiskBrake = DISK_BRAKE;
const int ThrottleChannel = THROTTLE_CHANNEL;

// D8-13 Connector ----------------------
// The shield does not provide a socket for D8-13
// D8 is spare on X4-2;  D9 is spare on X5-2.
// Signals D10-13 are not brought out on connectors, and may be used by a shield.
const int SDchipSelect = 10;  // for some shields
const int LED = 13;

// D14 - 21 Connector -------------------------------------
const int RxD2 = 14;      // reserved external input on X2-19
// Message in Gamebots format giving wheel spin rate and steering angle.
const int TxD2 = 15;      // Cruise Drive Command
const int RxD3 = 16;      // available on X2-22
const int TxD3 = 17;      // available on X2-20
/*  
The Stop signal is a momentary button push from either the console or remote.
A rising edge produces an interrupt.
The Cruise button works the same way.
The ~Estop signal is the 5V supply produced by the motor controller.
This supply goes away when either the key switch is turned off or RC4 is pressed.
Lack of 5V from the motor controller is an emergency stop.
Interrupts are on 2,3,18,19,20 and 21.
*/
// A remote stop button generates an interrupt to stop the vehicle.
const int StopRC2 =   18;      // wireless input
// A remote cruise button starts enabled cruise systems
const int CruiseRC1 = 19;       // wireless input
// Panel stop button generates an interrupt to stop the vehicle.
const int StopButton = 20;      // panel input
// Panel cruise button starts enabled cruise systems
const int CruiseButton = 21;    // panel input

// D22-53 Connector ----------------------------

const int LED1 = 23;      // external output
const int Reverse = 25;   // external output; reserved
const int LED3 = 27;      // external output
const int LED4 = 29;      // external output
const int LED5 = 31;      // external output
const int LED6 = 33;      // external output
const int LED7 = 35;      // external output
const int LED8 = 37;      // external output
#define redLEDpin 35
#define greenLEDpin 37

// Panel switch: Whether steering can be autonomous.
const int EnableSteer = 22;     // panel input
// Whether brakes can be autonomous.
const int EnableBrake = 24;     // panel input
// Whether the throttle can be autonomous.
const int EnableThrottle = 26;  // panel input
// Panel LED lights when under autonomous control.
const int CruiseLED = 28;       // panel output
// Panel LED lights when vehicle stop is commanded.
const int StopLED = 30;         // panel output 
// Vehicle is in reverse (not implemented)
const int ReverseLED = 32;      // panel output
// Button requesting reverse (not implemented)
const int ReverseButton = 34;   // external input; reserved
// Autonomous request for reverse (not implemented)
const int CruiseReverse = 36;   // external input; reserved
// D38 - D48 are available and brought out on various connectors


const int SelectCD     = 49;  // Select IC 3 DAC (channels C and D)
const int ThrottleMISO = 50;
const int ThrottleMOSI = 51;
const int ThrottleSCK  = 52;
const int SelectAB     = 53;  // Select IC 2 DAC (channels A and B)

// ANALOG Input ----------------------------------------------

// A8-15 Connector ----------------------------
const int SpeedLimit = 8;  // not implemented
/* Joystick is what the driver wants to do. */
const int JoystickCenter = 9;      // Center voltage from joystick is normally 2.5 V
const int SteerJoystick = 10;       // Left-right joystick motion turns vehicle
const int AccelerateJoystick = 11;  // Joystick up is throttle; down is brake.

/* These are what the autonomous vehicle wants to do */
const int Speed = 12;           // Actual speed (not implemented; Use WheelClick instead.)
const int CruiseSteer = 13;     // Position of steering commanded by AI
const int CruiseBrake = 14;     // Position of brake commanded by AI
const int CruiseThrottle = 15;  // Position of throttle commanded by AI
/*==========================================================================*/
// End of IOPCB.h
/*==========================================================================*/

// When setting up the project, select
//   Sketch  |  Import Library ... |  SPI
// include the Serial Periferal Interface (SPI) library:
#include <SPI.h>
// The MegaShieldDB has a four channel Digital to Analog Converter (DAC).
// Basic Arduino cannot write a true analog signal, but only PWM.
// Many servos take PWM.
// An electric bicycle (E-bike) throttle expects an analog signal.
// We have found that feeding a pwm signal to an e-bike controller makes the motor chug at low speed.

#ifndef TRUE
#define TRUE 1
#define FALSE 0
#endif


// Values to send over DAC
const int FullThrottle =  227;   // 3.63 V
const int MinimumThrottle = 40;  // Throttle has no effect until 1.2 V
// Values to send on PWM to get response of actuators
// Vehicles #1 and #2 are reversed.
// On #1. the actuator pushes the brake lever to bake.
// On #2, the actuator pulls on the brake cable to brake.
const int FullBrake = 210;//167;  // start with a conservative value; could go as high as 255;  
const int NoBrake = 244; // 207; // start with a conservative value; could go as low as 127;
// Steering
const int HardLeft = 240; //187; //  could go as high as 255;
const int Straight = 195;// 187;
const int HardRight = 150;  //126;

// set the initial positions
int ThrottlePosition = MinimumThrottle;
int BrakePosition = FullBrake;
int SteerPosition = Straight;

int BrakeIncrement = 1;
int SteerIncrement = 1;
int ThrottleIncrement = 1;


/*  Elcano #1 Servo range is 50 mm for brake, 100 mm for steering.

    Elcano servo has a hardware controller that moves to a
    particular position based on an input PWM signal from Arduino.
    The Arduino PWM signal is a square wave at a base frequency of 490 Hz or 2.04 ms.
    PWM changes the duty cycle to encode   
    0 is always off; 255 always on. One step is 7.92 us.
    
    Elcano servo is fully retracted on a pulse width of 2 ms;
    fully extended at 1 ms and centered at 1.5 ms.
    There is a deadband of 8 us.
    At 12v, servo operating speed is 56mm/s with no load or
    35 mm/s at maximum load.
    
    Output from hardware servo controller to either servo has five wires, with observed bahavior of:
    White: 0V
    Yellow: 5V
    Blue: 0-5V depending on position of servo.
    Black: 12V while servo extends; 0V at rest or retracting.
    Red:   12V while retracting; 0V at rest or extending.
    The reading on the Blue line has hysteresis when Elcano sends a PWM signal; 
    there appear to be different (PWM, position) pairs when retracting or extending.
    Motor speed is probably controlled by the current on the red or black line.   
*/

/*---------------------------------------------------------------------------------------*/
void setup()
{
    //Set up pin modes and interrupts, call serial.begin and call initialize.
    Serial.begin(9600);
    
    // SPI: set the slaveSelectPin as an output:
    pinMode (SelectAB, OUTPUT);
    pinMode (SelectCD, OUTPUT);
    pinMode (10, OUTPUT);
    SPI.setDataMode( SPI_MODE0);
    SPI.setBitOrder( MSBFIRST);
    // initialize SPI:
    // The following line should not be neccessary. It uses a system library.
//    PRR0 &= ~4;  // turn off PRR0.PRSPI bit so power isn't off
    SPI.begin(); 
    for (int channel = 0; channel < 4; channel++)
        DAC_Write (channel, 0);   // reset did not clear previous states
 
    pinMode(Throttle, OUTPUT);
    pinMode(DiskBrake, OUTPUT);
    pinMode(Steer, OUTPUT);

    moveBrake(BrakePosition);   // release brake
    moveSteer(SteerPosition);
    moveVehicle(MinimumThrottle); 
    Serial.println("Initialized");  
}
/*---------------------------------------------------------------------------------------*/
void loop()
{
  // Apply actuators no faster than MinTimeStep_usec
  const unsigned long MinTimeStep_usec = 100000;
  static unsigned long time_us;
  unsigned long timeNow_us = micros();
  if (timeNow_us < time_us)
  {      // roll-over
    time_us = 0;
  }
  if (timeNow_us - time_us < MinTimeStep_usec)
    return;
  time_us = timeNow_us;  
 
  // apply throttle
#ifdef MOTOR_RAMP
    ThrottlePosition += ThrottleIncrement;
    if (ThrottlePosition > FullThrottle || ThrottlePosition < MinimumThrottle)
        ThrottleIncrement = -ThrottleIncrement;
    moveVehicle(ThrottlePosition);
#endif  // MOTOR_RAMP  
  
  // apply brakes
#ifdef BRAKE_RAMP
    BrakePosition += BrakeIncrement;
    if (BrakePosition > NoBrake || BrakePosition < FullBrake)
        BrakeIncrement = -BrakeIncrement;
    moveBrake(BrakePosition);
#endif  // BRAKE_RAMP  
  
 // apply steering
#ifdef STEER_RAMP
    SteerPosition += SteerIncrement;
    if (SteerPosition > HardLeft || SteerPosition < HardRight)
        SteerIncrement = -SteerIncrement;
    moveSteer(SteerPosition);
#endif  // Steer_RAMP
}
/*---------------------------------------------------------------------------------------*/
void moveBrake(int i)
{
     Serial.print ("Brake "); Serial.print(i);
     Serial.print (" on ");   Serial.println (DiskBrake);
     analogWrite(DiskBrake, i);
}
/*---------------------------------------------------------------------------------------*/
void moveSteer(int i)
{
     analogWrite(Steer, i);
}
/*---------------------------------------------------------------------------------------*/
void moveVehicle(int counts)
{
    /* Observed behavior on ElCano #1 E-bike no load (May 10, 2013, TCF)
      0.831 V at rest       52 counts
      1.20 V: nothing       75
      1.27 V: just starting 79
      1.40 V: slow, steady  87
      1.50 V: brisker       94
      3.63 V: max          227 counts     
      255 counts = 4.08 V      
      */
#ifdef DAC      
   DAC_Write(ThrottleChannel, counts);
#endif
}
/*---------------------------------------------------------------------------------------*/
/* DAC_Write applies value to address, producing an analog voltage.
// address: 0 for chan A; 1 for chan B; 2 for chan C; 3 for chan D
// value: digital value converted to analog voltage
// Output goes to mcp 4802 Digital-Analog Converter Chip via SPI
// There is no input back from the chip.
*/
void DAC_Write(int address, int value)

/*
REGISTER 5-3: WRITE COMMAND REGISTER FOR MCP4802 (8-BIT DAC)
A/B  —  GA  SHDN  D7 D6 D5 D4 D3 D2 D1 D0 x x x x
bit 15                                       bit 0

bit 15   A/B: DACA or DACB Selection bit
         1 = Write to DACB
         0 = Write to DACA
bit 14   — Don’t Care
bit 13   GA: Output Gain Selection bit
         1 = 1x (VOUT = VREF * D/4096)
         0 = 2x (VOUT = 2 * VREF * D/4096), where internal VREF = 2.048V.
bit 12   SHDN: Output Shutdown Control bit
         1 = Active mode operation. VOUT is available. 
         0 = Shutdown the selected DAC channel. Analog output is not available at the channel that was shut down.
         VOUT pin is connected to 500 k (typical)
bit 11-0 D11:D0: DAC Input Data bits. Bit x is ignored.


With 4.95 V on Vcc, observed output for 255 is 4.08V.
This is as documented; with gain of 2, maximum output is 2 * Vref

*/

{
  int byte1 = ((value & 0xF0)>>4) | 0x10; // acitve mode, bits D7-D4
  int byte2 = (value & 0x0F)<<4;           // D3-D0
  if (address < 2)
  {
      // take the SS pin low to select the chip:
      digitalWrite(SelectAB,LOW);
      if (address >= 0)
      { 
        if (address == 1)
          byte1 |= 0x80;  // second channnel
        SPI.transfer(byte1);
        SPI.transfer(byte2);
       }
      // take the SS pin high to de-select the chip:
      digitalWrite(SelectAB,HIGH);
  }
  else
  {
      // take the SS pin low to select the chip:
      digitalWrite(SelectCD,LOW);
      if (address <= 3)
      {
        if (address == 3)
          byte1 |= 0x80;  // second channnel
        SPI.transfer(byte1);
        SPI.transfer(byte2);
      }
       // take the SS pin high to de-select the chip:
      digitalWrite(SelectCD,HIGH);
  }
}
/*---------------------------------------------------------------------------------------*/ 
