lanfuli/Localization/elcano-master/Elcano_C2_LowLevel/Elcano_C2_LowLevel.ino

#include <SPI.h> 
#include <Elcano_Serial.h>
//#include <SoftwareSerial.h>

// Read in VEHICLE_NUMBER, which specifies which trike is being used.
// Also provides definitions specific to that trike, under
// VEHICLE_NUMBER conditionals. See README.txt for how to use and
// modify Settings.h.
#include <Settings.h>

// On Mega, TX must use d10-15, d50-53, or a8-a15 (62-69)
const int softwareTx = 10;  // to 7 segment LED display
const int softwareRx = 7;   // not used
//SoftwareSerial s7s(softwareRx, softwareTx);
#define s7s Serial3

#define LOOP_TIME_MS 400
#define ERROR_HISTORY 20

// Distance the wheel outer circumference moves during one phase cycle.
const float WHEEL_PHASE_DISTANCE_MM = WHEEL_DIAMETER_MM * PI / MOTOR_POLE_PAIRS;
// Conversion factor from 1 / (motor phase cycle time in microseconds) to speed
// in km/h:
// There are MOTOR_POLE_PAIRS phase cycles per wheel rotation, so the time for
// one wheel rotation (based on a single phase cycle) is the duration of that
// phase cycle times the number of pole pairs.  Also, we want km / h rather
// than mm / usec.  Units conversion:
// speed measured in km / hr
// = (speed measured in mm / usec) * (km / 10^6 mm) * (3600 * 10^6 usec / hr)
// = (speed in mm / usec) * 3600
// = (wheel phase distance in mm / motor feedback cycle time in usec) * 3600
// = (wheel phase distance in mm * 3600) / (motor feedback cycle time in usec)
// The first part is a constant for a given motor and wheel diameter:
const float HUB_PHASE_TO_KMPH = WHEEL_PHASE_DISTANCE_MM * 3600;
// For a motor with 23 pole pairs and a 500 mm diameter drive wheel, this is
// about 245863.8.

/*================ReadTurnAngle ================*/
// Value measured at analog input A2 from right steering column when wheels pointed straight ahead.
// An analog voltage can be 0 to 5V, which correspond to angles from 0 to 360 degrees.
// Analog input reads this as a value form 0 to 1024.
// We may want to mount the sensors so that straight is close to 500.
// This number is not critical, since actual wheel turn range is much less than 360
int RightStraight_A2 = 750; // Original value 181
// Value measured at analog input A3 from left steering column when wheels pointed straight ahead.
int LeftStraight_A3  = 914; // Original value 181
// Calibration constants
// Aangle (degrees) = (Value - RightStraight_A2) * RIGHT_DEGx1000pCOUNT / 1000
#define RIGHT_DEGx1000pCOUNT  333
#define LEFT_DEGx1000pCOUNT  333
// A correct sensor will produce a reading between these values
int Left_Min_Count = 850; // Real values are in setup().
int Left_Max_Count = 980; 
int Right_Min_Count = 698; 
int Right_Max_Count = 808; 

// Channel order differs for differernt vehicles
// Indices for information stored in arrays RC_rise, RC_elapsed, local_results,...
// Right joystick left/right to D21
#define RC_TURN 1
#define RC_AUTO 2
// Right joystick up/down to D19
#define RC_GO   3
// Red (Gear) Switch to D18
#define RC_ESTP 4
// Left joystick left/right to D20 
#define RC_RDR  5
// Left joystick up/down to D2
#define RC_RVS  6
// There are six channels, but we are limited to five interrupts
#define NUMBER_CHANNELS 6

// RC_rise contains the time value collected in the rising edge interrupts.
// RC_elapsed contains the width of the pulse. The rise and fall interrupts
// should alternate.
#define ProcessFallOfINT(Index)  RC_elapsed[Index]=(micros()-RC_rise[Index])
#define ProcessRiseOfINT(Index) RC_rise[Index]=micros()


const int SelectCD = 49; // Select IC 3 DAC (channels C and D)
const int SelectAB = 53; // Select IC 2 DAC (channels A and B)

const unsigned long INVALID_DATA = 0;
volatile int rc_index = 0;
volatile unsigned long RC_rise[7];
volatile unsigned long RC_elapsed[7];
volatile boolean synced = false;
volatile unsigned long last_fallingedge_time = 4294967295; // max long
volatile int RC_Done[7] = {0,0,0,0,0,0,0};

// interrupt number handling a function depends on the RC controller.

#ifdef RC_SPEKTRUM
const int IRPT_RVS  = 0; // D2  = Int 0 
const int IRPT_TURN = 2; // D21 = Int 2
const int IRPT_GO   = 3; // D20 = Int 3 
const int IRPT_RDR  = 5; // D18 = Int 5
// RDR (rudder) is not used. Instead, use this interrupt for the motor phase feedback, which gives speed.
const int IRPT_ESTOP = 4; // D19 = Int 4
//RC input values - pulse widths in microseconds
const int DEAD_ZONE = 75;
const int MIDDLE = 1500;  // was 1322; new stable value = 1510
// extremes of RC pulse width
const int MIN_RC = 1090;  // was 911;
const int MAX_RC = 1930; // was 1730;
#endif

#ifdef RC_HITEC
const int IRPT_RVS = 0;   // D2  = Int 0 
const int IRPT_TURN = 2;  // D21 = Int 2 
const int IRPT_GO = 3;   //  D20 = Int 3 
// RDR (rudder) is not used. Instead, use this interrupt for the motor phase
// feedback, which gives speed.
const int IRPT_RDR = 5;   // D18 = Int 5
const int IRPT_ESTOP = 4; // D19 = Int 4
//RC input values - pulse widths in microseconds
const int DEAD_ZONE = 75;
const int MIDDLE = 1380; 
// extremes of RC pulse width
const int MIN_RC = 960;
const int MAX_RC = 1800;
#endif
//  D3 = Int 1  Wheel Click

// Currently different interrupts are used for the motor phase feedback.
#if (VEHICLE_NUMBER == 1)
#define RC_MOTOR_FEEDBACK RC_RVS
const int IRPT_MOTOR_FEEDBACK = IRPT_RVS;
#endif
#if (VEHICLE_NUMBER == 2)
#define RC_MOTOR_FEEDBACK RC_RDR
const int IRPT_MOTOR_FEEDBACK = IRPT_RDR;
#endif

long speed_errors[ERROR_HISTORY];
long old_turn_degx1000;
unsigned long calibrationTime_ms;
unsigned long stoppedTime_ms;
unsigned long straightTime_ms;
int  throttle_control = MIN_ACC_OUT;
int  brake_control = MAX_BRAKE_OUT;
int  steer_control = STRAIGHT_TURN_OUT;
float Odometer_m = 0;
float HubSpeed_kmPh;
const float  HubSpeed2kmPh = 13000000;
const unsigned long HubAtZero = 1159448;
//==========================================================================================
void ISR_TURN_rise() {
  noInterrupts();
  ProcessRiseOfINT(RC_TURN);
  attachInterrupt(IRPT_TURN, ISR_TURN_fall, FALLING);
  interrupts();
}

// RDR (rudder) is currently not used.
void ISR_RDR_rise() {
  noInterrupts();
  unsigned long old_phase_rise = RC_rise[RC_RDR];
  ProcessRiseOfINT(RC_RDR);
  RC_elapsed[RC_RDR] = RC_rise[RC_RDR] - old_phase_rise;
  interrupts();
}

void ISR_GO_rise() {
  noInterrupts();
  ProcessRiseOfINT(RC_GO);
  attachInterrupt(IRPT_GO, ISR_GO_fall, FALLING);
  interrupts();
}

void ISR_ESTOP_rise() {
  noInterrupts();
  ProcessRiseOfINT(RC_ESTP);
  attachInterrupt(IRPT_ESTOP, ISR_ESTOP_fall, FALLING);
  interrupts();
}

void ISR_RVS_rise() {
  noInterrupts();
  ProcessRiseOfINT(RC_RVS);
  attachInterrupt(IRPT_RVS, ISR_RVS_fall, FALLING);
  interrupts();
}

void ISR_TURN_fall() {  
  noInterrupts();
  ProcessFallOfINT(RC_TURN);
  RC_Done[RC_TURN] = 1;
  attachInterrupt(IRPT_TURN, ISR_TURN_rise, RISING);
  interrupts();
}

void ISR_GO_fall() {
  noInterrupts();
  ProcessFallOfINT(RC_GO);
  RC_Done[RC_GO] = 1;
  attachInterrupt(IRPT_GO, ISR_GO_rise, RISING);
  interrupts();
}
void ISR_ESTOP_fall() {  
  noInterrupts();
  ProcessFallOfINT(RC_ESTP);
  RC_Done[RC_ESTP] = 1;
//  if (RC_elapsed[RC_ESTP] > MIDDLE)
//     E_Stop();
  attachInterrupt(IRPT_ESTOP, ISR_ESTOP_rise, RISING);
  interrupts();
}

void ISR_RVS_fall() {
  noInterrupts();
  ProcessFallOfINT(RC_RVS);
  RC_Done[RC_RVS] = 1;
  attachInterrupt(IRPT_RVS, ISR_RVS_rise, RISING);
  interrupts();
}

// An e-bike hub motor is powered by giving it 3 phase power. This is supplied
// by the motor controller. The controller needs feeback from the hub.  It
// receives three feedback signals from the motor, one for each phase.  These
// are the *actual* phase rotation of the motor, not the phases supplied by the
// controller, which differ from what the motor is currently doing whenever the
// controller is attempting to speed up or slow down or change direction of the
// motor. The motor phase feedback pulse rate is an integer multiple of wheel
// rotation rate. The factor is the number of pole pairs in the motor. Note
// that the controller has no idea how many pole pairs the motor has, so it
// only controls the phase rate, not the actual rotation rate.  It is "someone
// else's problem" to limit the actual rotation rate or speed. The feedback
// signals are 5V square waves.  They have some noise -- spikes of several
// volts, which exceeds the maximum voltage allowed for Arduino inputs, which
// is 5.5V.  The signal is cleaned up by an RC low pass filter with R = 1K,
// C = 100 nF.
void ISR_MOTOR_FEEDBACK_rise() {
  noInterrupts();
  // This differs from the other interrupt routines since we need the *cycle*
  // duration, not the width of the high pulse.  So here, we get the time from
  // the previous rising edge to the current rising edge.  Q: Are we properly
  // ignoring the first value from all of these interval computations?
  unsigned long old_phase_rise = RC_rise[RC_MOTOR_FEEDBACK];
  ProcessRiseOfINT(RC_MOTOR_FEEDBACK);
  RC_elapsed[RC_MOTOR_FEEDBACK] = RC_rise[RC_MOTOR_FEEDBACK] - old_phase_rise;
  interrupts();
}

//----------------------------------------------------------------------------
void setup()
{ //Set up pins
      pinMode(BRAKE_OUT_PIN, OUTPUT);
      pinMode(STEER_OUT_PIN, OUTPUT);
      // SPI: set the slaveSelectPin as an output:
      pinMode (SelectAB, OUTPUT);
      pinMode (SelectCD, OUTPUT);
      pinMode (10, OUTPUT);
      SPI.setDataMode( SPI_MODE0);
      SPI.setBitOrder( MSBFIRST);
      // initialize SPI:
      // The following line should not be neccessary. It uses a system library.
      // Note PRR0 and PRR1 are defined for the Mega 2560 but smaller boards have just PRR.
      PRR0 &= ~4; // turn off PRR0.PRSPI bit so power isn't off
      SPI.begin();
      for (int channel = 0; channel < 4; channel++)
      DAC_Write (channel, 0); // reset did not clear previous states
      // put vehicle in initial state
      steer(STRAIGHT_TURN_OUT);
      brake(MAX_BRAKE_OUT);
      moveVehicle(MIN_ACC_OUT);
      setup7seg();    // Initialize 7 segment display for speedometer
      delay(500);   // let vehicle stabilize
      
      Serial.begin(9600);
      rc_index = 0;
      for (int i = 0; i < 8; i++)
      {
          RC_rise[i] = INVALID_DATA;
          RC_elapsed[i] = INVALID_DATA;
      }
      for (int i = 0; i < ERROR_HISTORY; i++)
      {
          speed_errors[i] = 0;
      }
      setupWheelRev(); // WheelRev4 addition
      CalibrateTurnAngle(32, 20);
      calibrationTime_ms = millis();
      attachInterrupt(IRPT_TURN,  ISR_TURN_rise,  RISING);
      //attachInterrupt(IRPT_RDR,   ISR_RDR_rise,   RISING);
      attachInterrupt(IRPT_GO,    ISR_GO_rise,    RISING);
      attachInterrupt(IRPT_ESTOP, ISR_ESTOP_rise, RISING);
      //attachInterrupt(IRPT_RVS,   ISR_RVS_rise,   RISING);
      attachInterrupt(IRPT_MOTOR_FEEDBACK, ISR_MOTOR_FEEDBACK_rise, RISING);
      Print7headers(false);
      PrintHeaders();
}

void loop() {
    SerialData Results;

    // Save start time for performance report.
    unsigned long startTime = micros();
    // Get the next loop start time.
    unsigned long nextTime = startTime + LOOP_TIME_MS;
    
    startCapturingRCState();
    
    unsigned long local_results[7];
//  PrintDone();

  // ToDo: Refactor this to not have a spinloop.
  // We get three signals from the RC controller in turn, one each for RC_ESTP,
  // RC_GO, and RC_TURN. The three signals are sent separately. We get triples of
  // new RC values at about 30Hz, which is faster than the loop runs. It doesn't
  // really matter if we are using exactly the latest value, as there isn't much
  // change between one an the next, except for ESTP, and if we wait til the next
  // loop pass for that, it should be ok. So just have the interrupt routines read
  // the RC information and store it, then the loop can use the latest values.
  // It should check that it has received any values, since the Arduino may be
  // started before the RC controller is turned on.
  while (micros() < nextTime &&
    ~((RC_Done[RC_ESTP] == 1) && (RC_Done[RC_GO] == 1) && (RC_Done[RC_TURN] == 1) ))
    ;  //wait
  
    // got data;    
    for (int i = 0; i < 8; i++)
        local_results[i] = RC_elapsed[i];
    Print7(false, local_results);
    processRC(local_results);
//    Print7( true, local_results);
  
    Results.Clear();
    Results.kind = MSG_SENSOR;
    Results.angle_deg = TurnAngle_degx10() / 10;
    show_speed (&Results);
    
    // Report how long the loop took.
    unsigned long endTime = micros();
    unsigned long elapsedTime = endTime - startTime;  
    //Serial.print("loop elapsed time = ");
    //Serial.println(elapsedTime);
    
    LogData(local_results, &Results);  // data for spreadsheet
    
    calibrationTime_ms += LOOP_TIME_MS;
    straightTime_ms = (steer_control == STRAIGHT_TURN_OUT)? straightTime_ms + LOOP_TIME_MS: 0;
    stoppedTime_ms = (throttle_control == MIN_ACC_OUT)? stoppedTime_ms + LOOP_TIME_MS: 0;
    if (calibrationTime_ms > 40000 && straightTime_ms > 3000 && stoppedTime_ms > 3000)
    {
//       int oldBrake = brake_control;
//       brake(MAX_BRAKE_OUT);  // put on brakes
         CalibrateTurnAngle(16, 10);  // WARNING: No response to controls while calibrating
//       brake(oldBrake);       // restore brake state
         calibrationTime_ms = 0;
    }
    
    // Did we spend long enough in the loop that we should immediately
    // start the next pass?
    if (nextTime > endTime) {
        // No, pause til the next loop start time.
        delay(nextTime - endTime);
    } else {
        // Yes, we overran the expected loop interval. Extend the time.
        nextTime = endTime + 1000 * LOOP_TIME_MS;
    }
}
void PrintDone()
{
  Serial.print("RC_Done values: RC_ESTP "); Serial.print(RC_Done[RC_ESTP]);
  Serial.print(" RC_GO "); Serial.print(RC_Done[RC_GO]);
  Serial.print(" RC_TURN "); Serial.print(RC_Done[RC_TURN]);
  //Serial.print(" RC_RVS "); Serial.print(RC_Done[RC_RVS]);
  // Not currently using RC_RVS, and it is always zero.

}

void Print7headers (bool processed)
{
    processed? Serial.print("processed data \t") : Serial.print("received data \t");
 #ifdef RC_SPEKTRUM
    Serial.print("Time\t");
    Serial.print("TURN\t");
    Serial.print("AUTO\t");
    Serial.print("GO\t");
    Serial.print("Rudder\t");
    Serial.print("E-Stop\t");
    Serial.println("Reverse\t"); 
#endif

#ifdef RC_HITEC
    Serial.print("Time\t");
    Serial.print("TURN\t");
    Serial.print("AUTO\t");
    Serial.print("GO\t");
    Serial.print("E-Stop\t");
    Serial.print("Rudder\t");
    Serial.println("Reverse\t"); 
#endif
}
void Print7 (bool processed, unsigned long results[7])
{
    processed? Serial.print("processed data \t") : Serial.print("received data \t");
    Serial.print(results[0]); Serial.print("\t");
    Serial.print(results[1]); Serial.print("\t");
    Serial.print(results[2]); Serial.print("\t");
    Serial.print(results[3]); Serial.print("\t");
    Serial.print(results[4]); Serial.print("\t");
    Serial.print(results[5]); Serial.print("\t");
    Serial.println(results[6]);
}
void LogData(unsigned long commands[7], SerialData *sensors)  // data for spreadsheet
{
     Serial.print(millis()); Serial.print("\t");
     Serial.print(sensors->speed_cmPs); Serial.print("\t");
     Serial.print(sensors->speed_cmPs*36.0/1000.); Serial.print("\t"); // km/hr
     Serial.print(HubSpeed_kmPh); Serial.print("\t");
     Serial.print(sensors->angle_deg); Serial.print("\t");
     int right = analogRead(A2);
     int left = analogRead(A3);
     Serial.print(right); Serial.print("\t");
     Serial.print(left); Serial.print("\t");
     Serial.print(throttle_control); Serial.print("\t");
     Serial.print(brake_control); Serial.print("\t");
     Serial.print(steer_control); Serial.print("\t");
     Serial.println(Odometer_m);
//     Print7 (true, commands);
}
void PrintHeaders (void)
{
    Serial.print("(ms) Time\t");
    Serial.print("(cm/s) Speed\t");
    Serial.print("(km/h) Speed\t");
    Serial.print("(km/h) Hub Speed\t");
    Serial.print("(deg) Angle\t");
    Serial.print("Right\t");
    Serial.print("Left\t");
    Serial.print("Throttle\t");
    Serial.print("Brake\t");
    Serial.print("Steer\t");
    Serial.println("(m) Distance");
}
void startCapturingRCState()
{
  for (int i = 1; i < 7; i++) {
    RC_Done[i] = 0;
  }
}

// processRC modified by TCF  9/17/15
void processRC (unsigned long *results)
{   
    // 1st pulse is aileron (position 5 on receiver; controlled by Right left/right joystick on transmitter)
    //     used for Steering
    int aileron = results[RC_TURN];
//    Serial.print("\tTurn input "); Serial.print(aileron);
    results[RC_TURN] = convertTurn(aileron);
//    Serial.print("\tTurn Cmd "); Serial.println(results[RC_TURN]);   
    /* 2nd pulse is aux (position 1 on receiver; controlled by flap/gyro toggle on transmitter) 
       will be used for selecting remote control or autonomous control. */
//    Serial.print("In processRC, received results[RC_AUTO] = "); Serial.println(results[RC_AUTO]);
    if (NUMBER_CHANNELS > 5) 
        results[RC_AUTO] = (results[RC_AUTO] > MIDDLE? HIGH: LOW);
//    Serial.print("processed results[RC_AUTO] = "); Serial.println(results[RC_AUTO]);

    /* 4th pulse is gear (position 2 on receiver; controlled by gear/mode toggle on transmitter) 
    will be used for emergency stop. D38 */
    results[RC_ESTP] = (results[RC_ESTP] > MIDDLE? HIGH: LOW);
    
    if (results[RC_ESTP] == HIGH)
    {
        E_Stop();  // already done at interrupt level
        if ((results[RC_AUTO] == LOW)  && (NUMBER_CHANNELS > 5)) // under RC control
            steer(results[RC_TURN]);
        Serial.println("Exiting processRC due to E-stop.");
        return;
    }
    
    
    if ((results[RC_AUTO] == HIGH)  && (NUMBER_CHANNELS > 5))
    {
        Serial.println("Exiting processRC as not under RC control.");
        return;  // not under RC control
    } else {
//        Serial.println("Continuing processRC as under RC control.");
    }
    /*  6th pulse is marked throttle (position 6 on receiver; controlled by Left up/down joystick on transmitter). 
    It will be used for shifting from Drive to Reverse . D40
    */
    results[RC_RVS] = (results[RC_RVS] > MIDDLE? HIGH: LOW);
        
// TO DO: Select Forward / reverse based on results[RC_RVS]
       
    /*   3rd pulse is elevator (position 4 on receiver; controlled by Right up/down.  
       will be used for throttle/brake: RC_Throttle
    */
    // Braking or Throttle
    if (liveBrake(results[RC_GO]))
         convertBrake (&(results[RC_GO]));

    //Accelerating
    else if(liveThrottle(results[RC_GO]))
    {
        results[RC_GO] = convertThrottle(results[RC_GO]);
        moveVehicle(results[RC_GO]);
    }
    else
        moveVehicle(MIN_ACC_OUT);
        
    steer(results[RC_TURN]); 
    
    /* 5th pulse is rudder (position 3 on receiver; controlled by Left left/right joystick on transmitter) 
    Not used */
//    results[RC_RDR] = (results[RC_RDR] > MIDDLE? HIGH: LOW);  // could be analog
    Serial.println(results[RC_MOTOR_FEEDBACK]);
    if (results[RC_MOTOR_FEEDBACK] >= HubAtZero)
        HubSpeed_kmPh = 0;
    else
        HubSpeed_kmPh = HubSpeed2kmPh / results[RC_MOTOR_FEEDBACK];
    
//  Serial.println("");  // New line

}
//Converts RC values to corresponding values for the PWM output
int convertTurn(int input)
{
     long int steerRange, rcRange;
     long output;
     int trueOut;
//     Serial.print("\tconvertTurn: input = \t"); Serial.print(input);
     //  Check if Input is in steer dead zone
     if ((input <= MIDDLE + DEAD_ZONE) && (input >= MIDDLE - DEAD_ZONE))
       return STRAIGHT_TURN_OUT;
       // On SPEKTRUM, MIN_RC = 1 msec = stick right; MAX_RC = 2 msec = stick left
       // On HI_TEC, MIN_RC = 1 msec = stick left; MAX_RC = 2 msec = stick right
      // LEFT_TURN_OUT > RIGHT_TURN_OUT
#ifdef RC_HITEC
  input = MAX_RC - (input - MIN_RC);
#endif
      
      if (input > MIDDLE + DEAD_ZONE)
      {  // left turn
         steerRange = LEFT_TURN_OUT - STRAIGHT_TURN_OUT;
         rcRange = MAX_RC - (MIDDLE + DEAD_ZONE);
        input = input - MIDDLE - DEAD_ZONE; // originally input = middle + dead_zone
        output = STRAIGHT_TURN_OUT + input * steerRange / rcRange;
        //set max and min values if out of range
        trueOut = (int)output;
        if(trueOut > LEFT_TURN_OUT)
            trueOut = LEFT_TURN_OUT;
        if(trueOut < STRAIGHT_TURN_OUT)
            trueOut = STRAIGHT_TURN_OUT;
        return trueOut;
    }
      if (input < MIDDLE - DEAD_ZONE)
      {  // right turn
         steerRange = STRAIGHT_TURN_OUT - RIGHT_TURN_OUT;
         rcRange = MIDDLE - DEAD_ZONE - MIN_RC;
        input = input - DEAD_ZONE - MIDDLE;  // input is negative
        output = STRAIGHT_TURN_OUT + input * steerRange / rcRange;
        //set max and min values if out of range
        trueOut = (int)output;
        if(trueOut < RIGHT_TURN_OUT)
            trueOut = RIGHT_TURN_OUT;
        if(trueOut > STRAIGHT_TURN_OUT)
            trueOut = STRAIGHT_TURN_OUT;
        return trueOut;
    }
}

int convertThrottle(int input)
{
      //full throttle = 227, min = 40
      const int dacRange = MAX_ACC_OUT - MIN_ACC_OUT;
      const int rcRange = MAX_RC - (MIDDLE + DEAD_ZONE);
      input -= (MIDDLE + DEAD_ZONE);
      double output = (double)input /(double)rcRange;
      output *= dacRange;
      output += MIN_ACC_OUT;
      //set max values if out of range
      int trueOut = (int)output;
      if(trueOut > MAX_ACC_OUT)
          trueOut = MAX_ACC_OUT;
      return trueOut;
}
//Tests for inputs
// Input not in throttle dead zone
boolean liveThrottle(int acc)
{
      return (acc > MIDDLE + DEAD_ZONE);
}
// Input is not in brake dead zone
boolean liveBrake(int brake)
{
      return (brake < MIDDLE - DEAD_ZONE);
}
// Emergency stop
void E_Stop()
{
    brake(MAX_BRAKE_OUT);
    moveVehicle(MIN_ACC_OUT);
    delay (2000);   // inhibit output
    // TO DO: disable 36V power
}
//Send values to output pin
void steer(int pos)
{
      analogWrite(STEER_OUT_PIN, pos);
//      Serial.print("\tSteering to: \t"); Serial.print(pos);
     steer_control = pos;
}
void convertBrake(long unsigned *amount)
{
      if (*amount < (MIDDLE + MIN_RC)/2)
          *amount = MAX_BRAKE_OUT;
      else
           *amount = MIN_BRAKE_OUT; 
      brake (*amount);     
}
void brake (int amount)
{
      analogWrite(BRAKE_OUT_PIN, amount);
 //     Serial.print("\tBraking to: \t"); Serial.print(*amount);
      brake_control = amount;
}
/*---------------------------------------------------------------------------------------*/
/* DAC_Write applies value to address, producing an analog voltage.
// address: 0 for chan A; 1 for chan B; 2 for chan C; 3 for chan D
// value: digital value converted to analog voltage
// Output goes to mcp 4802 Digital-Analog Converter Chip via SPI
// There is no input back from the chip.
*/
void DAC_Write(int address, int value)
/*
REGISTER 5-3: WRITE COMMAND REGISTER FOR MCP4802 (8-BIT DAC)
A/B — GA SHDN D7 D6 D5 D4 D3 D2 D1 D0 x x x x
bit 15 bit 0
bit 15 A/B: DACA or DACB Selection bit
1 = Write to DACB
0 = Write to DACA
bit 14 — Don’t Care
bit 13 GA: Output Gain Selection bit
1 = 1x (VOUT = VREF * D/4096)
0 = 2x (VOUT = 2 * VREF * D/4096), where internal VREF = 2.048V.
bit 12 SHDN: Output Shutdown Control bit
1 = Active mode operation. VOUT is available.
0 = Shutdown the selected DAC channel. Analog output is not available at the channel that was shut down.
VOUT pin is connected to 500 k (typical)
bit 11-0 D11:D0: DAC Input Data bits. Bit x is ignored.
With 4.95 V on Vcc, observed output for 255 is 4.08V.
This is as documented; with gain of 2, maximum output is 2 * Vref
*/
{
      int byte1 = ((value & 0xF0)>>4) | 0x10; // acitve mode, bits D7-D4
      int byte2 = (value & 0x0F)<<4; // D3-D0
      if (address < 2)
      {
          // take the SS pin low to select the chip:
          digitalWrite(SelectAB,LOW);
          if (address >= 0)
          {
              if (address == 1)
                  byte1 |= 0x80; // second channnel
              SPI.transfer(byte1);
              SPI.transfer(byte2);
          }
          // take the SS pin high to de-select the chip:
          digitalWrite(SelectAB,HIGH);
      }
      else
      {
          // take the SS pin low to select the chip:
          digitalWrite(SelectCD,LOW);
          if (address <= 3)
          {
              if (address == 3)
                  byte1 |= 0x80; // second channnel
              SPI.transfer(byte1);
              SPI.transfer(byte2);
          }
          // take the SS pin high to de-select the chip:
          digitalWrite(SelectCD,HIGH);
      }
}
void moveVehicle(int acc)
{
      /* Observed behavior on ElCano #1 E-bike no load (May 10, 2013, TCF)
      0.831 V at rest 52 counts
      1.20 V: nothing 75
      1.27 V: just starting 79
      1.40 V: slow, steady 87
      1.50 V: brisker 94
      3.63 V: max 227 counts
      255 counts = 4.08 V
      */
      DAC_Write(DAC_CHANNEL, acc);
      throttle_control = acc;    // post most recent throttle.
}

/*========================================================================/
 *============================WheelRev4 code==============================/
 *=======================================================================*/
 
/* Wheel Revolution Interrupt routine
   Ben Spencer 10/21/13
   Modified by Tyler Folsom 3/16/14; 3/3/16
   
   A cyclometer gives a click once per revolution. 
   This routine computes the speed.
*/

#define SerialOdoOut  Serial3
#define SerialMonitor Serial

#define MEG 1000000
#define MAX_SPEED_KPH 50
#define MAX_SPEED_mmPs   ((MAX_SPEED_KPH * MEG) / 3600)
// MAX_SPEED_mmPs = 13,888 mm/s = 13.888 m/s
unsigned long MinTickTime_ms;
// ((WHEEL_DIAMETER_MM * 3142) / MAX_SPEED_mmPs)
// MinTickTime_ms = 89 ms
#define MIN_SPEED_mPh 3000
// A speed of less than 0.3 KPH is zero.
unsigned long MaxTickTime_ms;
// ((WHEEL_DIAMETER_MM * 3142) / MIN_SPEED_mmPs)
// MinTickTime_ms = 9239 ms = 9 sec

long SpeedCyclometer_mmPs = 0;
// Speed in revolutions per second is independent of wheel size.
float SpeedCyclometer_revPs = 0.0;//revolutions per sec

#define IRQ_NONE 0
#define IRQ_FIRST 1
#define IRQ_SECOND 2
#define IRQ_RUNNING 3
#define NO_DATA 0x7FFFFFFF
volatile byte InterruptState = IRQ_NONE;  // Tells us if we have initialized.
volatile byte ClickNumber = 0;         // Used to distinguish old data from new.
volatile unsigned long TickTime = 0;  // Time from one wheel rotation to the next gives speed.
volatile unsigned long OldTick = 0;

   static struct hist {
     long olderSpeed_mmPs;  // older data
     unsigned long olderTime_ms;   // time stamp of older speed
     
     long oldSpeed_mmPs;  // last data from the interrupt
     byte oldClickNumber;
     unsigned long oldTime_ms;  // time stamp of old speed
     
     byte nowClickNumber;  // situation when we want to display the speed
     byte InterruptState;
     unsigned long nowTime_ms;
     unsigned long TickTime_ms;  // Tick times are used to compute speeds
     unsigned long OldTick_ms;   // Tick times may not match time stamps if we don't process
                                 // results of every interrupt
   } history;

/*---------------------------------------------------------------------------------------*/ 
// WheelRev is called by an interrupt.
void WheelRev()
{
    static int flip = 0;
    unsigned long tick;   
    noInterrupts();
    tick = millis();
    if (InterruptState != IRQ_RUNNING)
    // Need to process 1st two interrupts before results are meaningful.
        InterruptState++;

    if (tick - TickTime > MinTickTime_ms)
    {
        OldTick = TickTime;
        TickTime = tick;
        ++ClickNumber;
    }
    if (flip)
        digitalWrite(13, LOW);
    else
        digitalWrite(13, HIGH);
    flip =!flip;  
    
    interrupts();
}
/*---------------------------------------------------------------------------------------*/ 

void setupWheelRev() 
{ 

    SerialOdoOut.begin(115200); // C6 to C4        
    pinMode(13, OUTPUT); //led
    digitalWrite(13, LOW);//turn LED off
    
    pinMode(3, INPUT);//pulls input HIGH
    float MinTick = WHEEL_DIAMETER_MM * PI;
//    SerialMonitor.print (" MinTick = ");
//    SerialMonitor.println (MinTick);
    MinTick *= 1000.0;
    MinTick /= MAX_SPEED_mmPs;
//    SerialMonitor.print (MinTick);
    MinTickTime_ms = MinTick;
    SerialMonitor.print (" MinTickTime_ms = ");
    SerialMonitor.println (MinTickTime_ms);

//    SerialMonitor.print (" MIN_SPEED_mPh = ");
//    SerialMonitor.print (MIN_SPEED_mPh);
    float MIN_SPEED_mmPs =  ((MIN_SPEED_mPh * 1000.0) / 3600.0);
    // MIN_SPEED_mmPs = 135 mm/s
//    SerialMonitor.print (" MIN_SPEED_mmPs = ");
//    SerialMonitor.print (MIN_SPEED_mmPs);
    float MaxTick = (WHEEL_DIAMETER_MM * PI * 1000.0) / MIN_SPEED_mmPs;
//    SerialMonitor.print (" MaxTick = ");
//    SerialMonitor.print (MaxTick);
    MaxTickTime_ms = MaxTick;
//    SerialMonitor.print (" MaxTickTime = ");
//    SerialMonitor.println (MaxTickTime_ms);
    TickTime = millis();
    // OldTick will normally be less than TickTime.
    // When it is greater, TickTime - OldTick is a large positive number,
    // indicating that we have not moved.
    // TickTime would overflow after days of continuous operation, causing a glitch of
    // a display of zero speed.  It is unlikely that we have enough battery power to ever see this.
    OldTick = TickTime;
    InterruptState = IRQ_NONE;
    ClickNumber = 0;
    history.oldSpeed_mmPs = history.olderSpeed_mmPs = NO_DATA;

    attachInterrupt (1, WheelRev, RISING);//pin 3 on Mega
    SerialMonitor.print("TickTime: ");
    SerialMonitor.print(TickTime);
    SerialMonitor.print(" OldTick: ");
    SerialMonitor.println(OldTick);
     
    SerialMonitor.println("WheelRev setup complete");

}
/*---------------------------------------------------------------------------------------*/ 
void ComputeSpeed( struct hist *data)
{
    if (data->InterruptState == IRQ_NONE || data->InterruptState == IRQ_FIRST)
    {  // No data
       SpeedCyclometer_mmPs = 0;
       SpeedCyclometer_revPs = 0;
       return;
    }
    float Circum_mm = (WHEEL_DIAMETER_MM * PI);
    long WheelRev_ms = data->TickTime_ms - data->OldTick_ms;
    if (data->InterruptState >= IRQ_SECOND && data->oldSpeed_mmPs == NO_DATA && WheelRev_ms > 0)
    {   //  first computed speed
        SpeedCyclometer_revPs = 1000.0 / WheelRev_ms;
        SpeedCyclometer_mmPs  = 
        data->oldSpeed_mmPs = Circum_mm * SpeedCyclometer_revPs;
        data->oldTime_ms = data->TickTime_ms;  // time stamp for oldSpeed_mmPs
        data->oldClickNumber = data->nowClickNumber;
        return;
    }
    if (data->InterruptState == IRQ_RUNNING && data->olderSpeed_mmPs == NO_DATA && WheelRev_ms > 0
       && data->nowClickNumber != data->oldClickNumber)
    {   //  new data for second computed speed
        data->olderSpeed_mmPs = data->oldSpeed_mmPs;
        data->olderTime_ms = data->oldTime_ms;
    
        SpeedCyclometer_revPs = 1000.0 / WheelRev_ms;
        SpeedCyclometer_mmPs  = 
        data->oldSpeed_mmPs = Circum_mm * SpeedCyclometer_revPs;
        data->oldTime_ms = data->TickTime_ms;  // time stamp for oldSpeed_mmPs
        data->oldClickNumber = data->nowClickNumber;
        return;
    }
    if (data->InterruptState == IRQ_RUNNING && data->olderSpeed_mmPs != NO_DATA && WheelRev_ms > 0)
    {  // Normal situation after initialization
        if (data->nowClickNumber == data->oldClickNumber)
        {  // No new information; extrapolate the speed if decelerating; else keep old speed
            if (data->olderSpeed_mmPs > data->oldSpeed_mmPs)
            {   // decelerrating
                float deceleration = (float) (data->olderSpeed_mmPs - data->oldSpeed_mmPs) /
                (data->oldTime_ms - data->olderTime_ms);
                SpeedCyclometer_mmPs = data->oldSpeed_mmPs - deceleration * 
                (data->nowTime_ms - data->oldTime_ms);
                if (SpeedCyclometer_mmPs < 0)
                    SpeedCyclometer_mmPs = 0;
                SpeedCyclometer_revPs = SpeedCyclometer_mmPs / Circum_mm;
            }
            else
            {  // accelerating; should get new data soon
               
            }
            if(data->nowTime_ms - data->oldTime_ms > MaxTickTime_ms)
            {  // too long without getting a tick
                SpeedCyclometer_mmPs = 0;
                SpeedCyclometer_revPs = 0;
                if(data->nowTime_ms - data->oldTime_ms > 2 * MaxTickTime_ms)
                {
                    InterruptState = IRQ_FIRST;  //  Invalidate old data
                    data->oldSpeed_mmPs = NO_DATA;
                    data->olderSpeed_mmPs = NO_DATA;
                }
            }
        }
        else
        {  // moving; use new data to compute speed
            data->olderSpeed_mmPs = data->oldSpeed_mmPs;
            data->olderTime_ms = data->oldTime_ms;
    
            SpeedCyclometer_revPs = 1000.0 / WheelRev_ms;
            SpeedCyclometer_mmPs  = 
          data->oldSpeed_mmPs = Circum_mm * SpeedCyclometer_revPs;
            data->oldTime_ms = data->TickTime_ms;  // time stamp for oldSpeed_mmPs
            data->oldClickNumber = data->nowClickNumber;
        }
    }
    if(data->nowTime_ms - data->TickTime_ms > WheelRev_ms)
    {  // at this speed, should have already gotten a tick?; If so, we are slowing.
        float SpeedSlowing_revPs = 1000.0 / (data->nowTime_ms - data->TickTime_ms);
        long SpeedSlowing_mmPs  = Circum_mm * SpeedCyclometer_revPs;                 
        SpeedCyclometer_revPs = min(SpeedCyclometer_revPs, SpeedSlowing_revPs);
        SpeedCyclometer_mmPs  = min(SpeedCyclometer_mmPs, SpeedSlowing_mmPs);
   }
    return;
}
/*---------------------------------------------------------------------------------------*/ 
void PrintSpeed( struct hist *data)
{
      Serial.print(SpeedCyclometer_mmPs); Serial.print("\t");
      Serial.print(data->InterruptState); Serial.print("\t");
      Serial.print(data->oldSpeed_mmPs); Serial.print("\t");
      Serial.print(data->olderSpeed_mmPs); Serial.print("\t");
      Serial.print(data->oldClickNumber); Serial.print("\t");
      Serial.print(data->nowClickNumber); Serial.print("\t");
      Serial.print(data->olderTime_ms); Serial.print("\t");
      Serial.print(data->oldTime_ms); Serial.print("\t");      
      Serial.print(data->nowTime_ms); Serial.print("\t");
      Serial.print(data->TickTime_ms); Serial.print("\t");
      Serial.println(data->OldTick_ms);
}
/*---------------------------------------------------------------------------------------*/ 
void show_speed(SerialData *Results)
{
   history.nowTime_ms = millis();       
   noInterrupts();
   history.TickTime_ms = TickTime;
   history.OldTick_ms = OldTick;
   history.nowClickNumber = ClickNumber;
   history.InterruptState = InterruptState;
   interrupts();
   
   ComputeSpeed (&history);
//   PrintSpeed(&history);
    
    Odometer_m += (float)(LOOP_TIME_MS * SpeedCyclometer_mmPs) / MEG;
// Since Results have not been cleared, angle information will also be sent.
    Results->speed_cmPs = SpeedCyclometer_mmPs / 10;
    writeSerial(&Serial3, Results);  // Send speed to C6
    
    show7seg( SpeedCyclometer_mmPs);   // Show speed on 7 segment LEDs

}
/*========================CalibrateTurnAngle======================*/
/*  This routine should only be called when
          - Wheels are pointed straight ahead, and have been for a while.
          - Trike is not moving, and is stable.
    Calibration will block any response to controls; there will be no turning or movemnet during calibration.
    Angle sensors can drift, and should periodically be zeroed.    
*/
void CalibrateTurnAngle(int count, int pause)
{
    int totalRight = 0;
    int totalLeft = 0;
    int i, left, right;
    for (i = 0; i < count; i++)
    {
          totalRight += analogRead(A2);
          totalLeft += analogRead(A3);
          delay(pause);
    }
    right = totalRight / count;
    left  = totalLeft  / count;
    // Only recalibrate when instruments are reasonable
    // Do not make garbage readings the new normal.
    if(RIGHT_MIN_COUNT <= right && right <= RIGHT_MAX_COUNT)
    {
         RightStraight_A2 = right; 
         Right_Min_Count = RightStraight_A2 - 60;   // 60 counts is 20 degrees
         Right_Max_Count = RightStraight_A2 + 60;
     }
    else
    {
         RightStraight_A2 = RIGHT_MIN_COUNT + (RIGHT_MAX_COUNT - RIGHT_MIN_COUNT)/2 ;
         Right_Min_Count = RIGHT_MIN_COUNT;
         Right_Max_Count = RIGHT_MAX_COUNT;
    } 
    if  (LEFT_MIN_COUNT  <= left  && left  <= LEFT_MAX_COUNT)
    {
        LeftStraight_A3  = left;
        Left_Min_Count  = LeftStraight_A3  - 60; 
        Left_Max_Count  = LeftStraight_A3  + 60;
    }
    else
    {
        LeftStraight_A3  = LEFT_MIN_COUNT + (LEFT_MAX_COUNT - LEFT_MIN_COUNT)/2 ;
        Left_Min_Count = LEFT_MIN_COUNT;
        Left_Max_Count = LEFT_MAX_COUNT;
    }
//    Serial.print("\tCALIBRATE: Left Straight\t"); Serial.print(LeftStraight_A3);
//    Serial.print("\tRight Straight\t"); Serial.println(RightStraight_A2);
    old_turn_degx1000 = 0; // straight
}
/*======================ReadTurnAngle======================*/
int TurnAngle_degx10()
{
    long new_turn_degx1000;
    long expected_turn_degx1000;
    int new_turn_degx10;
    long min_ang, max_ang;
    bool OK_right = false;
    bool OK_left = false;
    int right = analogRead(A2);
    int left = analogRead(A3);
//    Serial.print("Left"); Serial.print("\t"); Serial.print(left);
//    Serial.print("\tRight"); Serial.print("\t"); Serial.print(right);
//    Serial.print("LeftStraight_A3"); Serial.print("\t"); Serial.print(LeftStraight_A3);
//    Serial.print("\tRightStraight_A2"); Serial.print("\t"); Serial.print(RightStraight_A2);
    if ((Right_Min_Count <= right) && (right <= Right_Max_Count))
       OK_right = true;    
    if ((Left_Min_Count <= left) && (left <= Left_Max_Count))
       OK_left = true;    
    long right_degx1000 = (right - RightStraight_A2) * RIGHT_DEGx1000pCOUNT;  
    long left_degx1000  = (left -  LeftStraight_A3) *  LEFT_DEGx1000pCOUNT;  
//    Serial.print("Left"); Serial.print("\t"); Serial.print(left_degx1000);
//    Serial.print("\tRight"); Serial.print("\t"); Serial.print(right_degx1000);
 
    expected_turn_degx1000 = old_turn_degx1000; 
    if (OK_left && OK_right)
    {  // use the median
        if (right_degx1000 < left_degx1000)
        {
            min_ang = right_degx1000;
            max_ang = left_degx1000;
        }
        else
        {
            min_ang = left_degx1000;
            max_ang = right_degx1000;
        }
        if (expected_turn_degx1000 < min_ang)
            new_turn_degx1000 = min_ang;
        else if (expected_turn_degx1000 > max_ang)
            new_turn_degx1000 = max_ang;
        else  
            new_turn_degx1000 = expected_turn_degx1000;
    }
    else if (OK_left)
    {
        new_turn_degx1000 = (left_degx1000 + expected_turn_degx1000)/2;
    }
    else if (OK_right)
    {
        new_turn_degx1000 = (right_degx1000 + expected_turn_degx1000)/2;
    }
    else
    {   // No sensors; use last valid measurement
        new_turn_degx1000 = old_turn_degx1000;
    }
    new_turn_degx10 = (int) (new_turn_degx1000 / 100);
    old_turn_degx1000 = new_turn_degx1000;
//  Serial.print("\tnew_turn_degx10"); Serial.print("\t"); Serial.println(new_turn_degx10);
    return new_turn_degx10;
}
/*---------------------------------------------------------------------------------------*/
void Throttle_PID(long error_speed_mmPs)

/* Use throttle and brakes to keep vehicle at a desired speed.
   A PID controller uses the error in the set point to increase or decrease the juice.
   P = proportional; change based on present error
   I = integra;  change based on recent sum of errors
   D = derivative: change based on how error is changing.
   The controller needs to avoid problems of being too sluggish or too skittery.
   A sluggish control (overdamped) takes too long to reach the set-point. 
   A skitterish control (underdamped) can overshoot, then undershoot, producing 
   oscillations and jerky motion.
   Getting the right control is a matter of tuning right parts of P, I, and D,
   which is something of a black art.
   For more information, search for:
   VanDoren Proportional Integral Derivative Control
*/
{ 
  static int  throttle_control = MIN_ACC_OUT;
  static int  brake_control = MAX_BRAKE_OUT;
  static int error_index = 0;
  int i;
  static long error_sum = 0;
  long mean_speed_error = 0;
  long extrapolated_error = 0;
  long PID_error;
  const float P_tune = 0.4;
  const float I_tune = 0.5;
  const float D_tune = 0.1;
  const long speed_tolerance_mmPs = 75;  // about 0.2 mph
  // setting the max_error affacts control: anything bigger gets maximum response
  const long max_error_mmPs = 2500; // about 5.6 mph

  error_sum -= speed_errors[error_index];
  speed_errors[error_index] = error_speed_mmPs;
  error_sum += error_speed_mmPs;
  mean_speed_error = error_sum / ERROR_HISTORY;
  i = (error_index -1) % ERROR_HISTORY;
  if (++error_index >= ERROR_HISTORY)
      error_index = 0;
  extrapolated_error = 2 * error_speed_mmPs - speed_errors[i];
    PID_error = P_tune * error_speed_mmPs
            + I_tune * mean_speed_error
            + D_tune * extrapolated_error;
  if (PID_error > speed_tolerance_mmPs)
  {  // too fast
    long throttle_decrease = (MAX_ACC_OUT - MIN_ACC_OUT) * PID_error / max_error_mmPs;
    throttle_control -= throttle_decrease;
    if (throttle_control < MIN_ACC_OUT)
        throttle_control = MIN_ACC_OUT;
    moveVehicle(throttle_control);
    
    long brake_increase = (MAX_BRAKE_OUT - MIN_BRAKE_OUT) * PID_error / max_error_mmPs;
    // MIN_BRAKE_OUT = 180; MAX_BRAKE_OUT = 250; 
    brake_control -= brake_increase;
    if (brake_control > MAX_BRAKE_OUT)
        brake_control = MAX_BRAKE_OUT;
    brake(brake_control);
  }
  else if (PID_error < speed_tolerance_mmPs)
  {  // too slow
    long throttle_increase = (MAX_ACC_OUT - MIN_ACC_OUT) * PID_error / max_error_mmPs;
    throttle_control += throttle_increase;
    if (throttle_control > MAX_ACC_OUT)
        throttle_control = MAX_ACC_OUT;
    moveVehicle(throttle_control);
    
    // release brakes
    long brake_decrease = (MAX_BRAKE_OUT - MIN_BRAKE_OUT) * PID_error / max_error_mmPs;
    // MIN_BRAKE_OUT = 180; MAX_BRAKE_OUT = 250; 
    brake_control += brake_decrease;
    if (brake_control < MIN_BRAKE_OUT)
        brake_control = MIN_BRAKE_OUT;
    brake(brake_control);
  }
  // else maintain current speed
  Serial.print("\tThrottle Brake \t");  // csv for spreadsheet
  Serial.print(throttle_control);
  Serial.print("\t");
  Serial.print(brake_control);
  Serial.print("\t");
//  Serial.print(drive_speed_mmPs);  Serial.print("\t");
//  Serial.println(sensor_speed_mmPs); 
}

/*---------------------------------------------------------------------------------------*/
/* Serial 7-Segment Display Example Code
    Serial Mode Stopwatch
   by: Jim Lindblom
     SparkFun Electronics
   date: November 27, 2012
   license: This code is public domain.

   This example code shows how you could use software serial
   Arduino library to interface with a Serial 7-Segment Display.

   There are example functions for setting the display's
   brightness, decimals and clearing the display.

   The print function is used with the SoftwareSerial library
   to send display data to the S7S.

   Circuit:
   Arduino -------------- Serial 7-Segment
     3.3V   --------------------  VCC
     GND  --------------------  GND
      10   --------------------  RX
*/

void setup7seg()
{
  // Must begin s7s software serial at the correct baud rate.
  //  The default of the s7s is 9600.
  s7s.begin(9600);

  // Clear the display, and then turn on all segments and decimals
  clearDisplay();  // Clears display, resets cursor
  setBrightness(127);  // Medium brightness
//  setBrightness(255);  // High brightness
}

void show7seg(int speed_mmPs)
{
  char tempString[10];  // Will be used with sprintf to create strings
  // convert mm/s to km/h
  int speed_kmPhx10 = (speed_mmPs*.036);
  // Magical sprintf creates a string for us to send to the s7s.
  //  The %4d option creates a 4-digit integer.
  sprintf(tempString, "%4d", speed_kmPhx10);
//  Serial.println(tempString);
  // This will output the tempString to the S7S
  s7s.print(tempString);
  setDecimals(0b00000100);  // Sets digit 3 decimal on
}

// Send the clear display command (0x76)
//  This will clear the display and reset the cursor
void clearDisplay()
{
  s7s.write(0x76);  // Clear display command
}

// Set the displays brightness. Should receive byte with the value
//  to set the brightness to
//  dimmest------------->brightest
//     0--------127--------255
void setBrightness(byte value)
{
  s7s.write(0x7A);  // Set brightness command byte
  s7s.write(value);  // brightness data byte
}

// Turn on any, none, or all of the decimals.
//  The six lowest bits in the decimals parameter sets a decimal 
//  (or colon, or apostrophe) on or off. A 1 indicates on, 0 off.
//  [MSB] (X)(X)(Apos)(Colon)(Digit 4)(Digit 3)(Digit2)(Digit1)
void setDecimals(byte decimals)
{
  s7s.write(0x77);
  s7s.write(decimals);
}
