lanfuli/Localization/elcano-master/Elcano_C6_Navigator/Elcano_C6_Navigator.ino

//#include <GPS.h>

/*
Elcano Module C6: Navigator.
  Includes C5 Obstacle detection.

Documentation:
  NavigationSystem (TO DO: Write document, based on these comments).
  Wiring_C6Mega.xls
  Navigation sheet of Elcano_BOM  (TO DO: Reorganize Elcano BOM).

The Navigator has the job of making the best estimate of current vehicle
position, attitude, velocity and acceleration.

It uses a variety of sensors, some of which may not be present or reliable.

Yes: S1: Hall Odometer.  This unit gives wheel spin speed feedback.
TO DO: Connect hardware and integrate into Kalman Filter

Future: Visual Odometry from S4 (Smart camera) as passed though C7 (Visual Data
Management). Visual Odometry could also come from an optical mouse.

Future: S3: Digital Compass

Future: S9: Inertial Navigation Unit.

Yes, from KF: Dead reckoning based on prior state estimate.
TO DO: Integrate Kalman Filter with GPS and Odometry.

Yes: Distance and bearing to landmarks / obstacles.

Yes: S7: GPS.  GPS should not the primary navigation sensor and the robot should be
able to operate indoors, in tunnels or other areas where GPS is not available
or accurate.

Sensed navigation information is passed to C3/C4, which use prexisting or SLAM
digital maps, intended path to refine the estimated position.
C3/C4 may use a particle filter.
C3/C4 may also receive lateral lane deviation from a camera (C7).

The odometry sensor is one dimensional and gives the position along the
intended path. Lane deviation is also one dimensional and gives position
normal to the intended path. Odometry, lane following and a digital map
should be sufficient for localization.  An odometer will drift. This drift
can be nulled out by landmark recognition or GPS.

An alternative to the Kalman Filter (KF) is fuzzy numbers.
The position estimate from most sensors is a pair of fuzzy numbers.
[Milan Mares, Computation Over Fuzzy Quantities, CRC Press.]
A fuzzy number can be thought of as a triangle whose center point
is the crisp position and whose limits are the tolerances to which
the position is known.

GPS provides a pyramid aligned north-south and east-west, in contrast to
odometry / lane deviation, which is a pyramid oriented in the direction of
vehicle motion. The intersection of two fuzzy sets is their minimum.
By taking the minima of all position estimate pyramids, we get a surface
describing the possible positions of the vehicle, whichcan be used by a
particle filter.

Serial lines:
0: Monitor
1: INU
2: Tx: Estimated state;
      $C6EST,<east_mm>,<north_mm>,<speed_mmPs>,<bearing>,<time_ms><positionStndDev_mm>*CKSUM
      $C6OBS,<number>,<obstacle1_range_mm>,<obstacle1_bearing>, ...*CKSUM
   Rx: Desired course
      $C4XPC,<east_mm>,<north_mm>,<speed_mmPs>,<bearing>,<time_ms>*CKSUM
      // at leat 18 characters
3: GPS
  Rx: $GPRMC,...  typically 68 characters
      $GPGSA,...
      $GPGGA,... typically 68 characters
  Tx: $PSRF103,...
*/

/*---------------------------------------------------------------------------------------*/

#define MEGA
#include <Common.h>
#include <SPI.h>
#include <SD.h>
#include <IO.h>
#include <Matrix.h>

#include <Wire.h>
//#include <Adafruit_LSM303.h>
#include <Adafruit_LSM303_U.h>
#include <Elcano_Serial.h>
#include <FusionData.h>

/* Assign a unique ID to this sensor at the same time */
Adafruit_LSM303_Mag mag = Adafruit_LSM303_Mag(1366123);

long CurrentHeading = -1;

// On the Ethernet Shield, CS is pin 4. Note that even if it's not
// used as the CS pin, the hardware CS pin (10 on most Arduino boards,
// 53 on the Mega) must be left as an output or the SD library
// functions will not work.

#ifdef SIMULATOR
#include <Elcano_simulator.h>
#endif


namespace C6_Navigator
{
    void setup();
    void loop();
}

// Set the GPSRATE to the baud rate of the GPS module. Most are 4800
// but some are 38400 or other. Check the datasheet!
#define GPSRATE 4800

#define MAX_WAYPOINTS 10
/*   There are two coordinate systems.
     MDF and RNDF use latitude and longitude.
     C3 and C6 assume that the earth is flat at the scale that they deal with.
     All calculations with C6 are performed in the (east_mm, north_mm)
     coordinate system. A raw GPS reading is in latitude and longitude, but it
     is transformed to the flat earth system using the distance from the origin,
     as set by (LATITUDE_ORIGIN, LONGITUDE_ORIGIN).
     A third coordinate system has its origin at the vehicle center and is
     aligned with the vehicle. This is usually transformed into the flat
     world coordinate system.
*/


#ifdef SIMULATOR
namespace C6_Navigator {
#endif
// limited to 8+3 characters
#define FILE_NAME "GPSLog.csv"

File dataFile;
char GPSfile[BUFFSIZ] = "mmddhhmm.csv";
char ObstacleString[BUFFSIZ];
char StartTime[BUFFSIZ] = "yy,mm,dd,hh,mm,ss,xxx";
const char TimeHeader[] = "year,month,day,hour,minute,second,msec";
const char* RawKF = "Raw GPS data,,,,,,Kalman Filtered data";
const char* Header = "Latitude,Longitude,East_m,North_m,SigmaE_m,SigmaN_m,Time_s,";
const char* ObstHeader ="Left,Front,Right,Busy";

// Added by Varsha
SerialData C2_Results;
SerialData C4_Results;


//#define WHEEL_DIAMETER_MM 397

/* time (micro seconds) for a wheel revolution */
volatile long Odometer_mm = 0;
volatile long SpeedCyclometer_mmPs;
// Speed in degrees per second is independent of wheel size.
volatile long SpeedCyclometer_degPs;

// waypoint mission[MAX_WAYPOINTS];
waypoint GPS_reading;
waypoint estimated_position;
//instrument IMU;
const unsigned long LoopPeriod = 100;  // msec

PositionData oldPos, newPos;

/* Structure to store the distance history */
struct SpeedData {
    long olderSpeed_cmPs;
    unsigned long olderTime_ms;
    long oldHeading;
    
    long newSpeed_cmPs;
    unsigned long newTime_ms;
    long newHeading;

    long olderX_pos;
    long olderY_pos;
    long newX_pos;
    long newY_pos;
    
} history;

/* This procedure accepts SerialData structure and prints all the members of the struct to a serial
   output device. This will be only used for debugging purposes
   
   Added by Varsha
*/
void displayResults(SerialData &Results)
{
    Serial.print("SerialData::Kind :" );
    Serial.println(Results.kind);
    Serial.print("SerialData::Number:");    
    Serial.println(Results.number);    
    Serial.print("SerialData::speed_cmPs:");
    Serial.println(Results.speed_cmPs);
    Serial.print("SerialData::angle_deg:");
    Serial.println(Results.angle_deg);    // front wheels
    Serial.print("SerialData::bearing_deg:");
    Serial.println(Results.bearing_deg);  // compass direction
    Serial.print("SerialData::posE_cm:");
    Serial.println(Results.posE_cm);
    Serial.print("SerialData::posN_cm:");
    Serial.println(Results.posN_cm);
    Serial.print("SerialData::probability:");
    Serial.println(Results.probability);
    Serial.print("SerialData::distance_travelled_cm:");
    Serial.println(Results.distance_travelled_cm);
}

//---------------------------------------------------------------------------
char* obstacleDetect()
{
// Calibration shows that readings are 5 cm low.
#define OFFSET 5
    int LeftRange =  analogRead(LEFT) + OFFSET;
    int Range =      analogRead(FRONT) + OFFSET;
    int RightRange = analogRead(RIGHT) + OFFSET;

  sprintf(ObstacleString,
  "%d.%0.2d,%d.%0.2d,%d.%0.2d,",
  LeftRange/100, LeftRange%100, Range/100, Range%100, RightRange/100, RightRange%100);

  return ObstacleString;
}
/*---------------------------------------------------------------------------------------*/
/* Feb 23, 2016  TCF.  This instance of WheelRev is depricated.
   Current code for WheelRev is in Elcano_C2_LowLevel.
   The odometer processing is part of low level control.
   C2 will send odometer information to C6 over a serial line. */

/*---------------------------------------------------------------------------------------*/
/* Jun 20, 2016. Varsha - Get heading value from LSM303 sensor  */
long GetHeading(void)
{
    //Get a new sensor event from the magnetometer
    sensors_event_t event;
    mag.getEvent(&event);
    
    Serial.print("X:");
    Serial.print(event.magnetic.x);
    Serial.print(" Y:");
    Serial.print(event.magnetic.y);
    Serial.println("");
    
    //Calculate the current heading (angle of the vector y,x)
    //Normalize the heading
    float heading = (atan2(event.magnetic.y, event.magnetic.x) * 180) / M_PI;

    if (heading < 0)
    {
        heading = 360 + heading;
    }
    // Converting heading to x1000
    return ((long)(heading * HEADING_PRECISION ));
}

/*
 * Test Code to be removed
 */

void TestSpeed ( SerialData &data )
{
  long randNumber = random(3000, 5000);
  
  Serial.println(randNumber);
  data.Clear();
  data.kind = MSG_SENSOR;
  data.speed_cmPs = randNumber;
}
/*
 * End of Test Code
*/



//Added by Pengfei Zhu
// To calculate the lines by giving the point 
// This will be used for find the crosspoint to find the fuzzy numbers
long getSlope (long x1, long x2, long y1, long y2) {
  long k;
  k = (y1-y2)/(x1-x2);
  return k;
}

long getIntercept (long x1, long x2, long y1, long y2) {
  long d;
  long k = getSlope(x1, x2, y1, y2);
  d = y1 - k * x1;
  return d;
}


/*---------------------------------------------------------------------------------------*/

void initialize()
{
  pinMode(GPS_POWER, OUTPUT);
  char* GPSString;
  char* protocol =  "$PSRF100,1,4800,8,1,0*0E"; // NMEA
  char* disable =   "$PSRF103,02,00,00,01*26\r\n";
  char* querryGGA = "$PSRF103,00,01,00,01*25";
  bool GPS_available = false;
  Serial3.begin(GPSRATE);
  digitalWrite(GPS_POWER, LOW);         // pull low to turn on!
  Serial.flush();
  Serial3.flush();
  delay(5000);
  // prints title with ending line break
  Serial.println(" GPS parser");
//  Serial.print("Acquiring GPS RMC...");
  checksum(protocol);
  Serial3.println(protocol);
  disable[10] = '2';
  checksum(disable);
  Serial3.println(disable);   // no GSA

  GPS_available = estimated_position.AcquireGPRMC(70000);
  
  Serial.println(TimeHeader);
  Serial.println(StartTime);
  Serial.println(RawKF);
  Serial.print(Header);
  Serial.print(Header);
  Serial.println(ObstHeader);
  if (GPS_available)
  {
    estimated_position.sigma_mm = 1.0E4; // 10 m standard deviation
//    Serial.println("OK");
  }
  else
  {
    estimated_position.latitude = 47.62130;  // set by hand here
    estimated_position.longitude = -122.35090;
    estimated_position.Compute_mm();
    estimated_position.sigma_mm = 1.0E5; // 100 m standard deviation
    estimated_position.time_ms = millis();
//    Serial.println("Failed");
  }
  // Set velocity and acceleration to zero.
  estimated_position.speed_mmPs = 0;
  // Set attitude.
  estimated_position.Evector_x1000 = 1000;  // to be taken from path or set by hand
  estimated_position.Nvector_x1000 = 0;
  GPS_reading = estimated_position;
  GPSString = estimated_position.formPointString();
  Serial.println(GPSString);

  // Set Odometer to 0.
  // Set lateral deviation to 0.
  // Read compass.
  // Added by Varsha - To get heading data
  CurrentHeading=GetHeading();
  
  // ReadINU.
  // SendState(C4);
    // Wait to get path from C4
//    while (mission[1].latitude > 90)
    {
      /* If (message from C4)
      {
        ReadState(C4);  // get initial route and speed
      }
       Read GPS, compass and IMU and update their estimates.
     */
    }
    /* disable GPS messages;
    for (char i='0'; i < '6'; i++)
    {
      disable[9] = i;
      checksum(disable);
      Serial3.println(disable);
    }
    Serial3.println(querryGGA);
    */
//    GPS_available = GPS_reading.AcquireGPGGA(300);
    // ready to roll
    // Fuse all position estimates.
    // Send vehicle state to C3 and C4.
    
    
}


/*---------------------------------------------------------------------------------------*/

void setup()
{
  
randomSeed(analogRead(0));
    pinMode(Rx0, INPUT);
    pinMode(Tx0, OUTPUT);
    pinMode(GPS_RX, INPUT);
    pinMode(GPS_TX, OUTPUT);
    pinMode(C4_RX, INPUT);
    pinMode(C4_TX, OUTPUT);
    pinMode(INU_RX, INPUT);
    pinMode(INU_TX, OUTPUT);
    pinMode(GPS_POWER, OUTPUT);
    Serial3.begin(GPSRATE); // GPS
    Serial.begin(9600);
    Serial2.begin(9600);
    digitalWrite(GPS_POWER, LOW);         // pull low to turn on!
    // make sure that the default chip select pin is set to
    // output, even if you don't use it:
    pinMode(chipSelect, OUTPUT);
    pinMode(53, OUTPUT);  // Unused CS on Mega
    pinMode(GPS_RED_LED, OUTPUT);
    pinMode(GPS_GREEN_LED, OUTPUT);
    digitalWrite(GPS_GREEN_LED, LOW);
    digitalWrite(GPS_RED_LED, LOW);

    /* Initializing old PositionData struct to default values
     *  Added by Varsha
     */
    oldPos.Clear();
	oldPos.time_ms = millis();

    //Enable auto-gain
    mag.enableAutoRange(true);

    //Initialise the sensor

    delay(100);
    if(!mag.begin())
    {
        //There was a problem detecting the LSM303 ... check your connections
        Serial.println("Ooops, no LSM303 detected ... Check your wiring!");
        while(1);
    }
    initialize();
    Serial.print("Initializing GPS SD card...");

    // see if the card is present and can be initialized:
    if (!SD.begin(chipSelect))
    {
      Serial.println("Card failed, or not present");
      digitalWrite(GPS_RED_LED, HIGH);
    }
    else
    {
      Serial.println("card initialized.\n");
      dataFile = SD.open(GPSfile, FILE_WRITE);
      // if the file is available, write date and time to it:
      if (dataFile)
      {
          dataFile.println(TimeHeader);
          dataFile.println(StartTime);
          dataFile.println(RawKF);
          dataFile.print(Header);
          dataFile.print(Header);
          dataFile.println(ObstHeader);
          dataFile.close();
      }
    }
    // Commented by Varsha as low-level routine will be used from C2
    //pinMode(CYCLOMETER, INPUT);
    //attachInterrupt (5, WheelRev, RISING);

}
/*---------------------------------------------------------------------------------------*/
void waypoint::SetTime(char *pTime, char * pDate)
{
    //GPSfile = "mmddhhmm.CSV";
    strncpy(GPSfile,   pDate+2, 2);  // month
    strncpy(GPSfile+2, pDate, 2);    // day
    strncpy(GPSfile+4, pTime,2);     // GMT hour
    strncpy(GPSfile+6, pTime+2,2);   // minute
    Serial.println(GPSfile);

    strncpy(StartTime,     pDate+4, 2);  // year
    strncpy(StartTime+3,   pDate+2, 2);  // month
    strncpy(StartTime+6,   pDate, 2);    // day
    strncpy(StartTime+9,   pTime,2);     // GMT hour
    strncpy(StartTime+12,  pTime+2,2);   // minute
    strncpy(StartTime+15,  pTime+4,2);   // second
    strncpy(StartTime+18,  pTime+7,3);   // millisecond
}


/*---------------------------------------------------------------------------------------*/
void loop()
{
    Serial.println("Inside C6 loop");
    unsigned long deltaT_ms;
    unsigned long time = millis();
    unsigned long endTime = time + LoopPeriod;
    unsigned long work_time = time;
    int PerCentBusy;
    char* pData;
    char* pGPS;
    char* pObstacles;
    bool GPS_available = GPS_reading.AcquireGPGGA(300);

    /* Perform dead reckoning from clock and previous state
    Read compass.
    ReadINU.
    Set attitude.
    Read Hall Odometer;  */

   //IMU.Read(GPS_reading);

    // Added by Varsha - to get heading
    CurrentHeading = GetHeading();
    Serial.print("CurrentHeading:");
    Serial.println(CurrentHeading);
    // End of changes
    
/*  Read Optical Odometer;
    Read lane deviation;   
    If (message from C4)    
    { */     
      readline(2);  // C4 Path planner on serial 2 get new route and speed
 /* }
    If (message from C3)
    { */
//      readline(2);  // get C3 Pilot commanded wheel spin and steering
/*    }
    if (landmarks availabe)
    {  // get the position based on bearing and angle to a known location.
      ReadLandmarks(C4);
    }
    // Fuse all position estimates with a Kalman Filter */
    deltaT_ms = GPS_reading.time_ms - estimated_position.time_ms;
    estimated_position.fuse(GPS_reading, deltaT_ms);
    estimated_position.time_ms = GPS_reading.time_ms;
    
    // Added by Varsha
    // Send vehicle state to C6 and C4.

    // Preparing Result struct to send data to C4
    C4_Results.Clear();
    C4_Results.bearing_deg = CurrentHeading;
    C4_Results.posE_cm = estimated_position.east_mm;
    C4_Results.posN_cm = estimated_position.north_mm;
    C4_Results.kind = MSG_GOAL;

    //Sending GPS position from C6 to C2
    C2_Results.Clear();    
    C2_Results.posE_cm = estimated_position.east_mm/10;
    C2_Results.posN_cm = estimated_position.north_mm/10;
    C2_Results.kind = MSG_SENSOR;
    
    // Read data from C2 using Elcano_Serial
    C2_Results.Clear();
    readSerial(&Serial2, &C2_Results);
    TestSpeed(C2_Results);
    displayResults(C2_Results);
    
    if ( C2_Results.kind == MSG_SENSOR )
    {
      // Updating the C4_Results with the
      // odometer details from C2
      C4_Results.speed_cmPs = C2_Results.speed_cmPs;
      
	  newPos.speed_cmPs = C2_Results.speed_cmPs;
	  newPos.bearing_deg = CurrentHeading;
	  newPos.time_ms = time;

      ComputePositionWithDR(oldPos, newPos);
    }
        
    writeSerial(&Serial2, &C4_Results);
    writeSerial(&Serial2, &C2_Results);   
    
    Serial.print("time, gps, dt_ms = ");
    Serial.print(time, DEC); Serial.print(", ");
    Serial.print(GPS_reading.time_ms, DEC); Serial.print(", ");
    Serial.println(deltaT_ms, DEC);

    // Send vehicle state to C3 and C4.

    // open the file. note that only one file can be open at a time,
    // so you have to close this one before opening another.
    dataFile = SD.open(GPSfile, FILE_WRITE);

    // if the file is available, write to it:
    if (GPS_available)
    {
        digitalWrite(GPS_GREEN_LED, HIGH);
        pGPS = GPS_reading.formPointString();
        if (dataFile) dataFile.print(pGPS);
        // print to the serial port too:
        Serial.print(pGPS);
        pData = estimated_position.formPointString();
        if (dataFile) dataFile.print(pData);
        Serial.print(pData);
        Serial3.print(pData);  // send data to C4 path planner
        pObstacles = obstacleDetect();
        if (dataFile)
        {
          dataFile.print(pObstacles);
        }
        Serial.print(pObstacles);
    }
    else
    {
        digitalWrite(GPS_GREEN_LED, LOW);
        Serial.print("GPS not available");
    }

    work_time = millis() - time;
    PerCentBusy = (100 * work_time) / LoopPeriod;
    if (dataFile)
    {
      dataFile.println(PerCentBusy);
    }
    Serial.println(PerCentBusy);
    // if the file didn't open, pop up an error:
    if (dataFile)
    {
        digitalWrite(GPS_RED_LED, LOW);
        dataFile.close();
    }
    else
    {
        digitalWrite(GPS_RED_LED, HIGH);
 //     Serial.println("error opening file");
    }

  // delay, but don't count time in loop
  while (time < endTime)
  {
    time = millis();
  }

}


#ifdef SIMULATOR
} // end namespace
#else
void Show(char* x)
{
  Serial.print(x);
}
void Show(REAL x)
{
  Serial.print(x);
  Serial.print(", ");
}
#endif

/* Entry point for the simulator.
   This could be done with namespace, but the Arduino IDE does not handle preprocessor statements
   wrapping a namespace in the standard way.
*/
void C6_Navigator_setup() { C6_Navigator::setup(); }

void C6_Navigator_loop() { C6_Navigator::loop(); }
