lanfuli/Localization/elcano-master/Elcano_C4_Planner/SD/src/utility/SdFatUtil.h

/* Arduino SdFat Library
 * Copyright (C) 2008 by William Greiman
 *
 * This file is part of the Arduino SdFat Library
 *
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
 * You should have received a copy of the GNU General Public License
 * along with the Arduino SdFat Library.  If not, see
 * <http://www.gnu.org/licenses/>.
 */
#ifndef SdFatUtil_h
#define SdFatUtil_h
/**
 * \file
 * Useful utility functions.
 */
#include <Arduino.h>
#ifdef __AVR__
#include <avr/pgmspace.h>
/** Store and print a string in flash memory.*/
#define PgmPrint(x) SerialPrint_P(PSTR(x))
/** Store and print a string in flash memory followed by a CR/LF.*/
#define PgmPrintln(x) SerialPrintln_P(PSTR(x))
/** Defined so doxygen works for function definitions. */
#endif
#define NOINLINE __attribute__((noinline,unused))
#define UNUSEDOK __attribute__((unused))
//------------------------------------------------------------------------------
/** Return the number of bytes currently free in RAM. */
static UNUSEDOK int FreeRam(void) {
  extern int  __bss_end;
  extern int* __brkval;
  int free_memory;
  if (reinterpret_cast<int>(__brkval) == 0) {
    // if no heap use from end of bss section
    free_memory = reinterpret_cast<int>(&free_memory)
                  - reinterpret_cast<int>(&__bss_end);
  } else {
    // use from top of stack to heap
    free_memory = reinterpret_cast<int>(&free_memory)
                  - reinterpret_cast<int>(__brkval);
  }
  return free_memory;
}
#ifdef __AVR__
//------------------------------------------------------------------------------
/**
 * %Print a string in flash memory to the serial port.
 *
 * \param[in] str Pointer to string stored in flash memory.
 */
static NOINLINE void SerialPrint_P(PGM_P str) {
  for (uint8_t c; (c = pgm_read_byte(str)); str++) Serial.write(c);
}
//------------------------------------------------------------------------------
/**
 * %Print a string in flash memory followed by a CR/LF.
 *
 * \param[in] str Pointer to string stored in flash memory.
 */
static NOINLINE void SerialPrintln_P(PGM_P str) {
  SerialPrint_P(str);
  Serial.println();
}
#endif  // __AVR__
#endif  // #define SdFatUtil_h
