lanfuli/Localization/(commit log)

2016-07-03 New Elcano
    [ArduinoMegaPins.xls, Arduino_backplane.brd, Arduino_backplane.sch, C1_Interface.brd, C1_Interface.sch, C1_MotorInterface.sch, C2_Servos.sch, Elcano_BOM.xls]
2016-07-26 Update Varsha's code and the test case
2016-08-18 Fusion Data added in library
    [Elcano_BOM.xls]
