lanfuli/Localization/(notices)

Notices in the files:
elcano-master/Elcano_C4_Planner/SD/src/utility/SdVolume.cpp:
This Library is free software: you can redistribute it and/or modify
it under the terms of the GNU General Public License as published by
the Free Software Foundation, either version 3 of the License, or
(at your option) any later version.
parts and their libraries:
SparkFun-Passives: Licensing: Creative Commons ShareAlike 4.0 International - https://creativecommons.org/licenses/by-sa/4.0
